tomcoolpxl/cool8-cpu/board/README.md

# board

Pin constraint files and hardware notes. See docs/05-board.md.
