tomcoolpxl/cool8-cpu/rtl/soc/README.md

# rtl/soc

FPGA-only system: SPRAM controller, video, audio, PS/2, UART,
hardware loader, SPI flash reader, bus arbiter.

Free to use iCE40 primitives. Never instantiated by the ASIC build.
