tomcoolpxl/cool8-cpu/RUST_PORT.md

# The machine

`rust/` **is** the COOL8 machine: the CPU, the SoC around it, the
scanline renderer and the window. Every software suite runs on it,
`sim/cosim.py` diffs it against the RTL, and `tools/cool8rsvm.py` is
how Python drives it. Read this file before touching anything under
`rust/`.

It began as a fast copy of a Python model, for one reason — speed:

| level | workload | CPython | Rust | |
|---|---|---|---|---|
| CPU | 852,740-instruction multiply sweep | 0.73 M instr/s | 115 M instr/s | 158× |
| machine | 90 frames of boot ROM | 0.50 M instr/s | 66 M instr/s | 132× |

Profiling showed the CPU stepping loop itself was the cost, and PyPy
was ruled out by its numpy story, so the loop was ported rather than
coaxed. It then spent a development cycle as a runner gated against
the Python model per retired instruction, which is what made the
hand-over a rename rather than a leap
([D57](docs/01-decisions.md)) — and the Python model is now gone.

## The one rule: the RTL is the authority, and the specification is prose

`docs/02-isa.md` and `docs/04-system.md` say what this machine is;
`rtl/` is what it will be in silicon. **When this machine and the RTL
disagree, one of them is wrong and the documents decide which** — the
seat the Python emulator used to hold, now held by the hardware it was
always checked against. Do not resolve a cosim failure by changing
whichever side is easier to change.

Two independent implementations of the semantics still exist, which is
the property that made any of this trustworthy: the Verilog and this.
They are diffed instruction by instruction on every run of the gate.

## The verification contract

`sim/cosim.py` holds this machine and the RTL to one contract, and it
is the contract that was always here:

- **One line of full architectural state per retired instruction**, in
  cosim's format, lowercase hex:
  `pc r0r1r2r3 x y sp f` → `"%04x %02x%02x%02x%02x %04x %04x %04x %02x"`.
  Change one side, change all three.
- **The same programs**, generated by `sim/progen.py`: `directed()` (one
  probe per encoding, all 511), constrained-random streams, the four
  interrupt/halt/brk programs, and the exhaustive 65536-pair multiply.
- **The same retirement rules.** BRK and the reserved page-2 trap retire
  (they are instructions); a hardware interrupt entry does not; a halted
  tick does not. `o_retire` is the RTL's signal for it and the
  machine's `instructions` counter is its mirror.
- **Interrupts injected by retired-instruction count, never by cycle**,
  because the two models cannot agree on a cycle and do not need to.
  The machine takes the RTL testbench's plusarg vocabulary
  (`+irqafter=`, `+nmiafter=`, `+irqat=`), so cosim invokes both sides
  with the same words.
- **The whole 64 KB memory image is compared** after every run, so a
  store to a wrong address cannot hide behind a matching register trace.

Run it:

```
poe cosim              # the gate for any RTL change
poe test-rust          # the machine against RTL-dumped goldens
poe check              # among other things, the generated-table drift check
```

`poe check` runs `mkrsopc --check` so a stale generated table fails
loudly instead of misexecuting quietly. Run it before trusting a
cosim result after an encoding change.

## What is generated and what is hand-written

The project rule is that `tools/opcodes.py` is the single source of
truth for the encoding and nothing carries its own copy of the tables.
Rust cannot import Python, so the tables are **generated, not copied**:

- `tools/mkrsopc.py` reads `opcodes.py` and writes `rust/src/optab.rs`:
  the per-encoding cycle costs (branches as a not-taken/taken pair),
  the page-2 assigned/reserved split, and `INTERRUPT_CYCLES`.
- The generated file is committed, and `python tools/mkrsopc.py --check`
  regenerates and compares without writing — the same drift gate
  `asic/tt/prepare.py --check` gives the TinyTapeout copy of the RTL.
  It runs in `poe check`.
- **The hand-written Rust states no table.** `rust/src/cpu.rs` adds
  cycles only from `optab.rs` — there are no inline cycle constants to
  drift — and decides reserved-page-2 trapping only from the generated
  `P2_ASSIGNED`. After any change to the encoding or to
  `opcodes.cycles()`: rerun `python tools/mkrsopc.py`, rebuild, rerun
  `poe cosim`.

What *cannot* be generated is the instruction semantics, because
`opcodes.py` does not contain them (deliberately — the machine decodes
from bit fields independently of the table, so a disagreement between
the two is a real signal). `rust/src/cpu.rs` states them by hand, and
the trace diff against the RTL is what polices it.

## The files

| file | what |
|---|---|
| `rust/src/cpu.rs` | the CPU: state, ALU, conditions, interrupts, the step dispatcher, and the `Bus` trait |
| `rust/src/machine.rs` | the SoC: memory map, ROM overlay, UART, PS/2, flash, sound, the video register file and VRAM, and the scanline accounting |
| `rust/src/optab.rs` | **generated** by `tools/mkrsopc.py` — do not edit |
| `rust/src/main.rs` | the harness: both CLIs, the run loops, trace, dumps |
| `rust/src/render.rs` | the scanline renderer, modeled on the RTL — see below |
| `rust/src/emu.rs` | the window, the speaker and the host keyboard (`--features gui` only) |
| `tools/mkrsopc.py` | the generator, and `--check` |
| `tools/cool8rsvm.py` | the Python client: the batch machine (CPU+RAM per call, one shared `+serve` process) and the session machine (a persistent machine with peripherals, one process each), plus module-level `Machine`/`boot`/`converse` so a suite migrates by importing this module as `vm` |
| `tools/cool8rsrun.py` | the launcher: builds the ROM, font, keymap and disk with the ordinary tools, then hands over to `cool8rs +emu` |

`rust/target/` is gitignored; `Cargo.lock` is committed. There are no
dependencies.

The runner has two modes, chosen by the arguments. **CPU mode**
(`+hex=`): 64 K image, one hex byte per line as `progen.write_hex`
emits, plus `+trace=`, `+memdump=`, `+maxinstr=`,
`+irqafter=`/`+irqat=`, `+nmiafter=` — the RTL testbench's plusarg
vocabulary. Hardware-only plusargs (`+ws=`, `+wsrnd=`, `+maxcycles=`,
`+busrq*`) are accepted and ignored so cosim call sites can be reused
verbatim; anything else unknown is an error, so a typo'd `+irqafter`
cannot silently become a run with no interrupt in it. **Machine mode**
(`+rom=`, a binary ROM image): `+flash=` (a raw flash image, as
`Machine(flash_path=…)` takes), `+script=`, `+trace=` (a path, or
`-` for stdout), `+memdump=`, `+vramdump=`, `+said=`. Every run prints
`-- N instructions, … T s` (stdout in CPU mode, stderr in machine mode,
where stdout may be carrying the trace); T is stepping time alone, so
process start-up and image parsing flatter neither side of the speed
report.

## The machine level

`machine.rs` is the SoC: the memory map with the I/O page and the ROM
overlay, the UART, the PS/2 port, the SPI flash with its floor, the
eight-voice sound engine, the complete video register file with its
VRAM port, palette latch, pixel port and sprite table, and the
scanline accounting that makes time pass.

Its gate is `sim/test_vm.py`, and it is the same shape as cosim's: the
stimulus is transcribed by hand from `sim/tb/cool8_video_tb.v` into
Python, replayed through this machine's registers and VRAM, and the
frame the renderer scans out is compared **per pixel** against the
frame the RTL's own pixels made — `build/text.hex`, `build/tiles.hex`
and the sprite phase, 307,200 pixels each. The sound engine's level
stream is compared the same way against `build/snd.hex`, 4096 samples
from the running RTL, and the boot path against the bytes a real board
returned on its serial console.

**Why transcribe the stimulus rather than share it.** The frames could
have been produced by asking this machine to render whatever the
testbench set up, which would make the check a test of the renderer
against itself. Written out twice — once in Verilog, once in Python —
a misunderstanding of what a register means has to be made twice,
identically, to go unnoticed.

## Traps already hit, or designed around

- **Cycle accounting is table-driven for a reason.** `enter()` (the
  interrupt/trap entry) adds no cycles itself; every cost comes from
  the generated table at the dispatch site. BRK's table entry (6) and
  the reserved-page-2 trap's (7) already *include* the entry cost —
  adding `INTERRUPT_CYCLES` around a call to `enter()` double-counts.
  Only a real hardware interrupt adds `INTERRUPT_CYCLES` explicitly.
- **The run-loop event order is cosim's**: retire, apply any event,
  write the state line, then the halt check — so an event aimed at a
  halted machine still fires. The stop condition is the emulator's:
  halted, and neither `nmi_edge` nor (`irq_line` and `I`).
- **`+irqat=0` means "asserted from reset"**, applied before the first
  step, exactly like `emu_trace`'s `events={0: ...}`.
- **Both sides of the machine diff must run on `tick()`, not
  `run_line()`.** The two are not interchangeable: `run_line` runs to a
  cycle target and drops the overshoot when an instruction crosses the
  line boundary, while `tick` carries it in the owed-cycles
  accumulator, so the raster — and with it every interrupt — falls on
  different instructions. The Rust machine implements `tick` and the
  parity driver calls `m.tick()`.
- **`m.said()` drains the UART.** The suite compares it once and hands
  the bytes to the sanity callback; a second read sees nothing, which
  looked exactly like a monitor that never spoke.
- **Page-2 `$2C/$2D` (`ADDW X|Y,#imm16`) sit inside the unary range**
  `$10–$3F` and must be matched before it, as the emulator's `elif`
  order does; `$2E/$2F` in that range are reserved and are caught by
  `P2_ASSIGNED` before any range match runs.
- **`INCW`/`DECW` set only Z**, not N; `MOV` and the wide pointer ops
  set nothing; loads and `POP` set Z/N; stores and `PUSH` set nothing.
  All of it is the emulator's behaviour, ported — resist "fixing" flag
  behaviour in Rust on the way through.

## The display: modeled on the RTL, because now it can be

`rust/src/render.rs` is a scanline renderer derived from the Verilog —
`cool8_fetch.v`, `cool8_pixel.v`, `cool8_sprite.v`, `cool8_vga.v` —
rather than a port of the whole-frame Python renderer it replaced. The
reason that renderer stated in its own header: at CPython speed a frame
costs 0.88 s, so it drew whole frames from a register snapshot and **a
mid-frame register change was not visible**. At Rust speed the
hardware's real structure costs nothing, so it is modeled:

- **The line buffer, filled a source row ahead of the raster**, with
  `row_ptr` walking by stride from a base captured at frame start —
  so `VID_BASE` is latched at vblank exactly as docs/04-system.md
  section 12 promises, page flips cannot tear, and a mid-frame base
  write behaves as the hardware's accumulator does.
- **Registers sampled per line**, so a raster split lands on the line
  the write preceded and a palette change colours only the lines below
  it.
- **Text cells latched for sixteen lines, tile rows every line**, the
  circular `stride * 32` wrap, patterns flipped at fetch time, the
  256-word bank clamp on long bitmap strides.
- **Sprites per line**: eight slots with trailing rows counting,
  descriptor-order priority, the shared palette bank, `behind` losing
  to a non-zero background. The slot scan itself lives in the
  *machine* (both of them — see the findings below), because the
  overrun flag is CPU-visible.

The sprite *bandwidth* is modeled too, at the granularity the RTL's
own header states it: the scan-and-sweep lead-in, ~33 clocks for a
16x16 sprite, trailing rows cheaper, against the 266-clock line. A
line that runs out of clocks loses its last-rendered — which are the
lowest-numbered — sprites, and the overrun flag says so. The costs
are the RTL's stated figures, not a cycle-exact FSM re-derivation;
`sprite_plan` in machine.rs is the one statement of the rule, for
both the flag and the renderer. The *fetch* engine's
bandwidth stays unmodeled: nothing observable hangs off it.

**The gate**: `sim/test_vm.py`, per pixel, against the RTL's own
rendered frames — text, tiles and eleven sprites over a bitmap, all
307,200 pixels of each. Static frames, necessarily: the per-line
behaviour a whole-frame comparison cannot reach rests on the RTL
derivation above, and on `sim/test_video.py`, which checks the gates
themselves on every pixel clock of two frames.

## The window: `poe emu`

`tools/cool8rsrun.py` builds the ROM, the font, the machine-layout
keymap and a BASIC disk with the ordinary tools, then launches
`cool8rs +emu` (`--monitor` boots just the ROM). The front end is
`rust/src/emu.rs`, behind `--features gui` so the parity suite's build
stays dependency-free; SDL2 — bundled, so the build owns its copy — is
the window, the speaker, the clipboard and the scaler, the same library
the Python front end rides through pygame. (It was minifb and cpal
first; one library that does all four jobs replaced two that did one
each.)

- The CPU gets **exactly 266 system clocks per scanline**, 525 lines a
  frame, 139,650 cycles a frame at 60 Hz — 8.375 MHz of machine time,
  the same constant the Python machine and D32 state. Real time costs
  about 4 % of a core; the renderer adds 18.4 M pixels/s and does not
  change that picture.
- Audio is the machine's own 32.7 kHz `level` stream, resampled to the
  device rate; the queue takes the drift.
- The keyboard has three modes (`+keys=text|raw|both`).
  `text`, the default, takes printable characters from the OS — the
  user's layout applies — and types them through the machine's own
  keymap, derived from sw/keymap.asm by the launcher, never a second
  copy; the character-less keys go as physical Set 2 make/break, with
  the PS/2 typematic repeat a held key really produces. `raw` is all
  physical US-layout scancodes; `both` echoes characters to the UART
  for a machine with no keyboard driver yet.
- **F1 restarts the machine warm and F10 cold** — they send the raw
  scancodes of the machine's own Ctrl+Esc and Ctrl+Shift+Esc
  ([D54](docs/01-decisions.md)), which the keyboard block decodes
  before software sees them. The chords themselves cannot be used
  here: Windows keeps Ctrl+Esc for the Start menu and Ctrl+Shift+Esc
  for the task manager and never delivers either to an application.
  On the board, where nothing stands between the keyboard and the
  machine, the real chords work. Injecting the scancodes rather than
  performing the restart keeps the emulator on the same path the
  hardware takes — the machine cannot tell which keyboard it is.
- **F11** (and Ctrl+Pause, the board's own chord) is the break button
  — an NMI, as SW[0] is. **F12** writes the screen to a PNG.
  **Alt+Enter** toggles aspect-ratio-scaled fullscreen. **Right
  click** pastes the clipboard as keystrokes, a character a frame so
  the 16-byte FIFO never overruns.
- `+wav=` captures the speaker to a WAV at the machine's own sample
  rate, and a flash the machine wrote is written back to its image at
  exit, so SAVE survives the window closing.

## Python-model errors found against the RTL, and what was done

Reading the Verilog for the renderer turned up three places where
the Python model disagreed with the hardware. Per the rule of the day
the reference was fixed first and the Rust machine followed it; parity
gated both, and the software suites that exercise machine timing
(`basic`, `boot_basic`, `autoboot`, `interp`, and `test_run`'s VSYNC
and sprite-pacing checks) pass on the corrected phase. (At the time of
the fix, `names` and parts of `test_run` were failing for an unrelated
reason — the in-progress editor rewrite and CONST removal — so "the
whole suite is green" was not available as a gate; what was green
before the fix stayed green after it.)

1. **The vblank flag fired 45 lines late.** cool8_vga raises
   `frame_start` at line 480 — the start of vertical blanking, which
   is also what docs/04-system.md section 6 specifies — and the model
   raised it at the counter wrap, line 525/0. **Fixed** in the
   end-of-line step (and the cursor-blink tick with it, which the RTL
   also advances at frame start).
2. **The sprite overrun flag was never set.** cool8_sprite sets it on
   the ninth hit of a line — trailing rows counting — and on a render
   outrun by the next line. **Fixed, both halves**: the scan and the
   clock-budget model run in both machines' end-of-line step whenever
   sprites are enabled, so $FE2C bit 1 reads correctly and the
   renderer drops what the hardware would drop.
3. **Whole-frame rendering itself** — the snapshot model cannot show a
   raster split, a mid-frame palette change, or the vblank `VID_BASE`
   latch. Not fixable at CPython speed; that is what render.rs is for,
   and it is why the whole-frame Python renderer could not survive as
   the render model.

## What this is not: the scope line

- **Scanline granularity, PS/2 at FIFO level** — the machine's stated
  fidelity line. Finer than that, ask the RTL.
- **The loader wire protocol (`cool8_loader`) is not modeled**,
  deliberately: no software in the emulator ever speaks it — loading is
  the flash image or a poked memory image — and `sim/test_loader.py`
  drives the real thing over a bit-banged wire. It becomes worth doing
  the day a host-loader test wants to run without iverilog.
- **The sound *sample stream* is now diffed** (`sim/test_vm.py`, 4096
  levels against the running RTL); what is still not is the sigma-delta
  bitstream below it, where nothing CPU-visible reads back.

## How tests consume it: the batch machine

`tools/cool8rsvm.py` is the consumer path. `cool8rsvm.machine()` hands
back the batch machine, for CPU-and-RAM workloads: `bus.mem`, the
whole register file (which round-trips, so poke → run → inspect → run
again works), `romen`, `breakpoints`, and `run(until=…, cycles=…,
budget=…)` with the classic reasons. Peripheral state does not survive
between runs — the class docstring states the contract — and a
predicate `until` does not cross a process boundary. Without cargo
there is no machine and it says so: the suites need one.

The plumbing: one `cool8rs +serve` process per test process, batch runs
sent over stdin (tab-separated, because the fields carry paths), each
run a fresh machine on the far side whose loop is `Machine.run`'s own —
halt test before the tick, budget in ticks — so stopping behaviour
moves unchanged. One spawn per suite, not per case; per-case cost is a
64 KB file each way. `run()` works once per RustMachine and raises on a
second call — registers do not round-trip, so a resume would be a
different machine.

**The boundary rule, unchanged since the original investigation: it
sits at machine-API granularity or coarser.** There is no PyO3 wrapper
and no per-bus-access FFI. Anything that must look at the machine
*while it runs* becomes a server-side command rather than a Python
loop — `settle`, the cycle profiler (`profon`/`profdump`, which is
what `dbg.Profile` now reads) and the SP low-water mark (`spmin`),
each of which would otherwise cost a round trip per instruction. A new
question extends the protocol; it does not get a loop here.

## And the session machine, for the suites that type

The batch machine cannot host `test_basic` — that suite types, waits
for idle, reads the screen, types again — so the serve protocol grew a
**session form**: one persistent machine per `+serve` process,
peripherals, flash and all, with commands that mirror the Machine API
(`type`, `scan`, `nmi`, `said`, `text`, `frames`, `srun`, memory and
VRAM reads and writes, `flush` for the flash image, `fb` for a
rendered frame, and the peripheral dumps `pald`/`sprd`/`sndd`/`snds`
that let a harness compare two programs' setup without modelling any
of it). The command that shows the boundary rule at work is
**`settle`**: test_basic's idle test — both FIFOs empty, the input
ring drained, PC at the idle label — polls per instruction, so it runs
server-side as one command instead of one tick per round trip.

Two invariants the first migration day taught:

- **`romen` is machine state, not client belief.** The flash stub
  drops the overlay before jumping to BASIC; a client that pushes its
  own stale `romen` back before every run re-enables the overlay
  mid-boot. It round-trips with the registers on every stepping reply.
- **A zero-length transfer is `-`**, not an empty hex string, on both
  sides of the wire.

`cool8rsvm.Machine(...)`, `.boot(...)` and `.converse(...)` are the
module-level entry points, so a suite reads exactly as it did — the
migration was a changed import. `Machine(render=True)` attaches the
scanline renderer, which is what `m.fb()` answers from and what
`test_run`'s sprite check and `test_vm`'s frame gate use.

## Measured

The speeds that justified the port, 2026-08 on this machine, against
the CPython model it replaced:

| | workload | CPython 3.12 | `cool8rs` (release, LTO) |
|---|---|---|---|
| CPU | multiply sweep, 852,740 instr | 1.17 s — 0.73 M instr/s | 0.0074 s — 115 M instr/s |
| machine | 90 boot frames, 3,605,915 instr | 7.18 s — 0.50 M instr/s | 0.055 s — 66 M instr/s |

And what that bought the suites, on the day they moved: the software
group **823.8 s → 185.7 s** wall (`test_run` 823.7 → 183.7,
`test_basic` 177.9 → 2.9, the flash and boot suites to under 1.5 s
each), and `cosim all` to 55 s with the model side reduced from most
of the run to seconds — vvp is the cost now, which is the right cost.

The parity suite that made the hand-over safe (directed 511 encodings,
random streams, the interrupt programs, the multiply sweep, the
monitor conversation and an 8.5 M-instruction flash-to-BASIC boot, all
byte-identical) retired with the model it compared against. Its
successors are `poe cosim` and `poe test-rust`.
