tomcoolpxl/cool8-cpu/docs/12-tasks.md

# 12. Commands, and the runner that names them

Every command this project has is named in `pyproject.toml`: the job
table under `[tool.cool8.jobs]` for the suites, `[tool.poe.tasks]` for
the direct commands. That file is the vocabulary: if a command is not
in it, it is not a command, it is something someone typed once.

**The runner is pytest**, fed the job table by the one shim in
`sim/runner/test_jobs.py` — the shim shells each suite exactly as a
person would and holds no policy of its own. pytest-xdist runs jobs in
parallel (`-n auto`, the default), a group is a marker (`-m rtl`), and
`--durations` says where the time went. **poethepoet** (`poe`) names
the rest; `pip install -e ".[dev]"` once installs all three. Use
`python -m pytest` / `python -m poethepoet` where Scripts is not on
PATH.

```
poe test                 every software suite, in parallel  (pytest)
pytest -k "interp or asm"    just those two
poe test-rtl             the RTL side (cosim is the gate for any RTL change)
poe test-board           the physical board, one job at a time
poe test-all             software and RTL together
poe check                the generated tables, against what generated them
poe build                boot ROM, basic.bin, BOOT.BIN, with sizes
poe bench                the language benchmark
poe prof                 where the interpreter's clocks go
poe web                  build wasm and serve the web emulator locally
poe web-build            build wasm and web assets for GitHub Pages
poe list                 everything the runner knows about
```

**Three phases, and they are not the same kind of thing.** `sw` runs on
the machine — `rust/`, driven through `tools/cool8rsvm.py`, so it needs
`cargo` and there is no fallback — and is the fast inner loop. `rtl`
runs iverilog against the hardware description: slower, and where a
change to `sw/boot.asm` actually gets checked, since the boot ROM is
compiled into the bitstream. `board` talks to real hardware over USB.

**Board jobs must not run in parallel.** There is one USB device and no
lock on it; two `icesprog` processes at once do not fail cleanly, they
interleave on the SPI and hand back a readback full of zeroes — which
reads as a corrupt bitstream rather than as a corrupt test. That
happened here. `poe test-board` therefore carries `-n 0`; never run the
board group with xdist enabled.

What the runner buys is the part that was being done by hand in a shell
loop for a year:

- **The suites run at once.** A dozen of them, serially, is minutes of
  waiting while eleven cores idle.
- **Each job gets its own build directory**, `sim/build/jobs/<group>-<id>`,
  passed as `COOL8_BUILD`. Every `sim/*.py` honours it. This is not a
  nicety: the suites all compile `basic.bin`, and without it parallel
  runs write it on top of each other and fail in ways that look like
  bugs in the machine.

  **The trap that comes with it:** a suite that reads an artifact
  *another* suite produced will not find it, because that one wrote to
  its own directory. `sim/test_vm.py` hit this and passed in 0.19 s
  having compared nothing. If a suite consumes another's output, it
  must search the sibling directories — and **treat a missing input as
  a failure, never a skip**. A check that cannot run has not passed.
- **Only failures print their output.** A pass is a dot and a duration.
- **The exit code is the answer**, so it can gate a commit.

A suite counts as passed when it exits 0 *and* the word `FAIL` does not
appear in its output — two of them report a count rather than a status,
and an exit code alone would take their word for it. The shim enforces
this, not the suites.

## Writing a suite

Every suite is an ordinary script: it builds something, drives the
machine, prints a line per check, and returns an exit code. What it
does **not** do is carry its own copy of any of that.

```python
import harness as H
import cool8rsvm as vm

def main():
    code, syms = H.build_bas("basic.bas")
    m = vm.Machine()
    ...
    H.check(m.shows("42"), "RUN prints its answer")
    return H.report()
```

`sim/harness.py` owns building, checking and the paths;
`sim/toolchain.py` owns iverilog, yosys and the RTL file lists
(`T.build`, `T.run`, `T.cells`, `T.CORE`). Both are described in
[AGENTS.md](../AGENTS.md) and [10-debugging.md](10-debugging.md), and
using them is standing rule 4 — not a style note. A suite that rolls
its own is a second implementation of the thing it is testing with.

**A suite that reads another suite's artifact must search for it and
fail loudly when it is missing** — see the per-job build directories
above.

## The jobs

### `sw` — the software suite (`poe test`)

| | |
|---|---|
| `interp` | the interpreter on the editor's stored form |
| `lib` | M14 -- `sw/demo.bas` against `sw/demo.asm`, work per frame |
| `asm` | the on-machine assembler, byte-identical to `tools/cool8asm.py` |
| `basic` | the screen editor, typed at |
| `run` | `RUN`, plus `INKEY` and `KEY` driven from the PS/2 port |
| `boot_basic` | reset → autoboot → relocate → BASIC → a keypress, off a flash image |
| `autoboot` | autoboot and the monitor's flash write |
| `corpus` | the compiler against its corpus |
| `fs` | the filesystem, both implementations |
| `bas` | the code-size gate: within 15 % of hand-written |
| `memmap` | in the `check` group — [`tools/memmap.py`](../tools/memmap.py) is the one machine-readable memory map, the same arrangement `opcodes.py` has for the encoding. It verifies itself against the equates every `sw/*.asm` actually declares, and refuses two names on one byte of page 0. **Import from it rather than writing an address down twice**: `sim/test_interp.py` used to carry its own `VARS = 0x0040`, `sim/build_basic.py` its own `ORG`/`TOP` — and `sim/tb/cool8_boot_tb.v` its own `$8104` for the boot banner, which went stale at [D70]'s map move (2026-08-13) and stayed stale through [D82]: the `boot` job failed for four days and nobody saw, because map moves are software work and the `rtl` group was not in the loop. A testbench cannot import, so the rule there takes its other form, the one `+stopat` already used: the address goes in as a plusarg (`+banner=`, `+moncy=`), read out of the assembled `boot.asm` by `sim/test_boot.py`, and a missing plusarg is a hard failure rather than a default |
| `fp` | the loadable float package of [D62](01-decisions.md#d62--floating-point-ships-as-a-loadable-library-not-as-part-of-the-system) — arithmetic, decimal text, trig. **It also prints its own size and timing table**, which is what the decision entries quote rather than a hand-typed copy. `--trace <op> <x> <y> <label> <n>` breakpoints a routine and decodes forward; that is how `fdiv16` was caught answering the wrong question |
| `names` | global name collisions across the system image |
| `action` | the CoolAction! compiler of [15-action.md](15-action.md): one program per construct read back by symbol, the Byte sieve's clocks beside compiled BASIC's, `demos/primes.act` at the UART, what the compiler refuses -- and its assembler against `tools/cool8asm.py`: every program byte for byte, and all 491 encodings through both. **The library on the hardware**: every routine of `sw/libaction.act` called and the machine read back -- VRAM, palette, sprites, sound, the registers -- and `Line` against `LINE` over `test_run.py`'s fan, the whole mode 4 frame compared. **The nine ports against their originals**: each `demos/name.act` runs beside its `name.bas` to the same frame wait, `RND` call or key wait, and what the machine holds -- VRAM, palette, text map, voices, registers -- must be identical; the clocks are printed beside each other where the CPU is what is measured. **`KeyPoll`/`KeyHeld`** from a fed FIFO, on the bare machine and `SYS`'d from a booted BASIC with its interrupt handler running (D101), **KEYTEST** from the flash-booted disc, **the loader** (D102) putting RAINBOW.PRG at $1400 from the disc's catalogue and resetting the machine after it, and **Ms. Cool-Man** played by an autopilot -- and started from BASIC with a real space bar -- -- the title frame, dots, the pill, a ghost eaten and home, a death, two levels cleared into the blue maze, the fruit, the sprite engine's overrun flag -- which skips, loudly, without its art part. `--profile` prints the sieve's clocks by loop, `--profile line` the library's `Line` over the fan |

**Ten suites are on disk and not in the runner.** This paragraph said
five, and then named six; it also said "this is all of them", and it
was not. Two Tetris suites arrived with the demos and were never added
here, and the two ports below arrived after that. **The count is
derived, so check it rather than trusting it:**

```bash
for f in sim/test_*.py; do grep -q "$(basename $f)" pyproject.toml || echo $f; done
```

That is the failure mode a "deliberately excluded" list has, and it has
now happened twice: an excluded suite and a forgotten one look
identical from outside, so nothing complains when the list falls
behind.

The shelved on-machine compiler's gates — `sim/test_comp.py`,
`sim/test_emit.py`, `sim/test_lex.py` — cost minutes to gate code that
ships nowhere ([11-compiler.md](11-compiler.md)). Run them deliberately
before touching `sw/comp.bas`, `sw/emit.bas` or `sw/lex.bas`, and before
any change to the token table or the stored-program format, which both
sides of those diffs share.

The rest:

| | |
|---|---|
| `sim/test_asm.py` | `sw/asm.asm`, the assembler **on the machine**, gated on byte-identity with `tools/cool8asm.py` for the same source. Run it when either assembler changes |
| `sim/timing.py` (`poe timing`) | measures every encoding's clocks from `rtl/core`. **Not a suite and not gated**, and it is the only thing that keeps `rtl/core`, `tools/opcodes.py:cycles()` and the emulator's accounting in step — cosim cannot, because the two models are not expected to agree on a cycle. Run it whenever the control FSM changes, then update the other two ([02-isa.md §8](02-isa.md)) |
| `sim/test_load.py` | the host loader against the real RTL and against itself — the wire format of [07-loader.md](07-loader.md). Needs the toolchain, which is why it is not in the `sw` group |
| `sim/test_cooltris.py`, `sim/test_cooltris2.py` | the two Tetris demos, driven through the text buffer and through the tile map. They gate a demo rather than the system. Run them when `demos/cooltris*.bas` changes |
| `sim/test_pascal.py` | UCSD p-System II.0 ([14-demos.md](14-demos.md), [D95 and D96](01-decisions.md)). **It needs a system volume this repository does not contain** — `tools/ucsd-psystem-vm` is cloned rather than vendored, and `.gitignore` says why. Clone it there and the suite boots the p-System, walks into the Filer and back, and compiles `HELLO` with the real `SYSTEM.COMPILER` |
| `sim/test_z3.py` | the Z-Machine and the four Infocom games. **It needs story files that are not ours to redistribute.** Put them where `tools/gen_z3.py` looks and it boots all four, then saves and restores |

**Neither port can be gated, and that is what not vendoring them
costs.** `sim/test_pascal.py` skips its volume when the clone is
absent, which is the one thing the per-job build directory paragraph
above forbids — a check that cannot run has not passed. It cost
exactly that: the Pascal interpreter stopped assembling at some point,
and nothing said so until someone ran the suite by hand.

### `rtl` — `poe test-rtl`

`cosim` is **the gate for any RTL change**. It takes about a minute. Run
it; do not reason about whether it would pass.

`monitor` is the one that matters after a change to `sw/boot.asm`,
`sw/kbd.asm` or `sw/keymap.asm`: it boots the whole SoC cold on the
parameters the bitstream carries and types at it on **both** the serial
line and the PS/2 clock, so a scancode takes the same path it takes on
the bench. That is where a keyboard change is really checked — the
machine models the PS/2 port at FIFO level, but only this runs the
receiver, the parity check and the FIFO itself.

| | |
|---|---|
| `cosim` `boot` `soc` | the CPU and the machine against the RTL |
| `ps2` `flash` `spram` `loader` | one peripheral each |
| `monitor` | type at the whole SoC, serial and PS/2 |
| `video` `vram` `vport` | every mode and visible pixel |
| `snd` | the sound engine — **and it writes `build/snd.hex`**, the golden `test_vm` gates against |

Not in the runner, because they are slower than the gate and are run
deliberately:

```bash
python sim/cosim.py mul        # exhaustive multiply (~2.5 min)
python sim/test_load.py        # the host loader, against the RTL
python sim/test_video.py --refresh    # also updates docs/img/
poe mutate                 # break the RTL on purpose; require a fail
poe synth                  # hygiene, LUT/FF count, gate estimate
poe timing                 # measured clocks per encoding
```

### Two that answer a question rather than gate a change

Neither is a test and neither belongs in the runner. Both exist because
a decision was resting on a guess.

```bash
python sim/cpi.py              # cycles per instruction, and what it
                               # costs to add one. ~1 min
python tools/mkbit.py --seeds 6   # Fmax per clock across placer seeds
                               # ~70 s for the first, ~40 s each after
```

**`sim/cpi.py`** measures CPI on three code shapes — native, bytecode
and the real interpreter — and turns it into the break-even clock for
any change that adds a cycle to the fetch. It priced
[D59](01-decisions.md#d59--cpi-is-259-and-pipelining-the-fetch-is-a-bet-rather-than-an-optimisation)
in minutes, against a question that had been open for four milestones.
Re-run it whenever the cycle table moves: **at CPI 2.59 one added cycle
per instruction is a 39 % penalty**, which is what makes
per-instruction overheads so expensive on this machine.

**`--seeds N`** is the honest way to read Fmax. One nextpnr run is not a
measurement — the placer spread is around 6 %, and
[D38](01-decisions.md#d38--the-fetch-path-next-state-is-decoded-flat-and-it-bought-area-rather-than-speed)
is the write-up of a single-seed result that was noise and was believed
for a round. Synthesis is deterministic, so yosys runs once and only
placement repeats. It reports `sclk` and `pclk` separately, which the
plain build did not: it used to print whichever clock nextpnr mentioned
last.

### `board` — `poe test-board`

| | |
|---|---|
| `probe` | the board answers at all: the SPI flash identifies itself |
| `flash` | both halves read back off the chip and compared byte for byte |

Neither writes anything. Both are exclusive.

### `rust` — `poe test-rust`

| | |
|---|---|
| `vm` | the machine against RTL-dumped goldens: every pixel of three frames (text, tiles, sprites over a bitmap), 4096 sound samples, and a boot to the monitor answering `D F000` with the bytes a real board gave |

Its own group rather than `sw` because it needs the RTL dumps in
`sim/build` — `sim/test_video.py` and `sim/test_snd.py` produce them,
and it SKIPs rather than fails when they are absent. Everything about
the machine — what it is, what is generated, what the gates prove — is
in [RUST_PORT.md](../RUST_PORT.md).

**What the board phase cannot check** is that the machine boots to a
picture. `LOADER` defaults to 0 ([D40](01-decisions.md)) so there is no
way to read the framebuffer over the wire, and BASIC writes to the video
rather than to the UART — a serial terminal shows nothing even when it
is working perfectly. That needs eyes on the VGA output and a PS/2
keyboard in the socket, and it is the one part of this that is not
automatable.

### The emulator window

```
poe disk                                     a flash image with BASIC on drive 0
poe emu                                      boot it in a window
poe demo                                     rebuild the demo disc and boot it
python tools/cool8rsrun.py --flash IMG       boot some other image
python tools/cool8rsrun.py --rebuild ...     rebuild that image first
python tools/cool8rsrun.py --monitor         ROM only: no flash, no BASIC
```

`poe emu -- --flash IMG` does **not** work: poe passes the `--` through
and argparse rejects it. Call the script, or use `poe demo`.

**Putting BASIC into a running machine: `H.line`, not `H.key`.**
`m.key()` is the keyboard and stays the thing to *test* with; `H.line`
is what a builder wants. It sends one `inject` command -- the text, and
the addresses of `LBUF`, `LLEN` and `ed_inject`, all out of the symbol
table -- and the machine tokenises the line itself through
`sw/token.asm`, exactly as if it had been typed. One round trip a line
against one a character: **19.6x measured**, and the stored program is
byte-for-byte identical, floats included.

**Nothing is written into RAM to make the call.** The first version
poked `CALL / HALT` into four bytes of low RAM and jumped there, which
needed an address that was free -- and `sw/lowram.asm` says in its own
header that its map "has been wrong". The return address is pushed
instead, so the machine returns to the PC it was already sitting on and
there is no byte to contest.

**`--rebuild` is the one-command answer to a stale disc.** The launcher
otherwise builds nothing, deliberately — `basic_image` in
[cool8rsrun.py](../tools/cool8rsrun.py) says why: a launcher that
decides *for itself* when an image has gone stale needs a rule about
when a source counts as newer, and that rule is what quietly boots
yesterday's image one day. **Asking is not deciding**, so the flag is
allowed where a timestamp heuristic is not.

It picks the builder from the target: `demos.img` goes to
`mkdemos.py --no-shots`, anything else to `flash.py`. **`--no-shots`
matters**: `mkdemos` normally runs every demo for twelve chunks of 500M
cycles to photograph it, which is minutes; skipping that leaves typing
the sources onto the disc, which is not. The pictures are for
[14-demos.md](14-demos.md), not for booting.

**The launcher refuses to hand over idle symbols it knows are wrong.**
It compares the `BOOT.BIN` it would build against the one on the image,
and when they differ it says so and names the fix rather than passing
`+idle=` addresses from a build the machine is not running — which
makes `Machine::is_idle` never true, so the taskbar's play button waits
forever for a machine that booted seconds ago. That reads as "the demos
do not work" and is nothing of the kind; it has cost two sessions.

**There is a taskbar**, and every key below is also a button on it with
the shortcut and a line of description under the pointer. It carries a
menu of **every program on every disc**, and the play button beside it
cold-restarts the machine and then types `DRIVE n`, `LOAD "…"`, `RUN` —
the machine is typed at, exactly as a person would, and knows nothing
about the menu. **Fullscreen has no bar**, which is what fullscreen is
for.

**A program means a `.BAS`, and the menu holds nothing else.** That is
the machine's own rule and not the launcher's taste: `sw/fscmd.asm`
fills in `.BAS` when a name is typed without an extension, so a name in
the menu is exactly what the `LOAD` it is about to type will find. The
menu listed every *file* until Bad Apple made the difference plain —
its stream is 82 chunks called `BA000.DAT` upward, spread across twelve
drives, none of which can be loaded and run, and they buried the twelve
things that can in a list ninety-five long. `tools/cool8disk.py`'s
`catalogue` filters, `sim/test_fs.py` holds it, and `BOOT.BIN` falls out
of the same test instead of being named.

The bar is [Dear ImGui](https://github.com/ocornut/imgui) through
`imgui-sdl2-support` and `imgui-glow-renderer`, and the icons are
Phosphor merged into its font atlas ([`assets/icons/`](../assets/icons)).
Nothing in [`rust/src/bar.rs`](../rust/src/bar.rs) draws a widget or
packs a glyph; it decides what the bar holds and what each control does
to the machine. **The window never reads the flash image**: the disc
catalogue arrives as a file the launcher wrote with `tools/cool8disk.py`
(`+discs=`), the same arrangement the keymap has, because a directory
walk written again in Rust would be a second implementation of a format
that already has an owner.

| key | |
|---|---|
| `F1` | warm restart — the machine's Ctrl+Esc |
| `F10` | cold restart — Ctrl+Shift+Esc |
| `F11`, `Ctrl+Pause` | break: an NMI, as the board's button is |
| `F12` | the screen to a PNG in the current directory |
| `Alt+Enter` | fullscreen |
| right click | paste the clipboard, typed through the keymap |

**`F1` and `F10` exist because Windows keeps the real chords.** The
machine's own restarts are Ctrl+Esc and Ctrl+Shift+Esc ([D54](01-decisions.md)),
decoded in `cool8_ps2` before software sees anything — right on a board
where no operating system stands between the keyboard and the machine,
and impossible on a host that claims both for the Start menu and the
task manager. So the emulator injects the chord's raw scancodes: the
machine receives the bytes a real keyboard would send and cannot tell
the difference, and the hardware keeps a convention chosen for hardware.

### The demo disc

```
poe demos           build sim/build/demos.img and shoot the first demo
```

Formats sixteen volumes, boots the machine, **types** every
`demos/*.bas` at drive 13 and lets `SAVE` write it, then loads the first
one and renders a frame to `docs/img/`. No toolchain and no board: it is
the VM, which is what [14-demos.md](14-demos.md) means by a demo being a
question about software. It writes the `BOOT.BIN` it just built rather
than the one in `sim/build` — see the trap in
[AGENTS.md](../AGENTS.md), which cost a session.

### The board

```
poe bit             build the bitstream: yosys, nextpnr, icepack
poe disk            a flash image with BASIC on volume 0. No board touched
poe flash           bitstream + BASIC: the whole board
poe flash-fpga      the bitstream only, to flash offset 0
poe flash-system    BASIC only, to flash offset $100000
poe flash-verify    read BOTH halves back off the board and compare
poe console -- --port COM6      the board's text screen, on the PC
poe load -- --port COM6 --load build/BOOT.BIN --at 0x200 --go 0x200
```

> **`console` and `load` need a `LOADER(1)` bitstream, which is not the
> one you have.** Both talk to the hardware loader, and `LOADER`
> defaults to 0 ([D40](01-decisions.md)) — so on a shipping board they
> reach nothing. `poe board-screen` is the screen reader that works
> there: it asks BASIC to POKE the framebuffer at the UART, which needs
> no loader. Build with `LOADER(1)` when a board will not boot and you
> need the bus-master read-back.

**The boot ROM is inside the bitstream.** There is no separate step for
it: a change to `sw/boot.asm`, `sw/kbd.asm` or `sw/keymap.asm` reaches
the board through `poe bit` and `poe flash-fpga`, and through
nothing else. `poe rom` builds `boot.hex` for the *simulators*.

Flash holds two unrelated things and every way of confusing them is
destructive, so `tools/flash.py` makes the mistakes impossible rather
than documenting them a fifth time:

| offset | what | if you get it wrong |
|---|---|---|
| `0` | the FPGA bitstream | the board does nothing until reprogrammed |
| `$100000` | volume 0, where `BOOT.BIN` lives | boots to the monitor, looking like a BASIC bug |

It refuses to write a disk image at offset 0, refuses a bitstream
anywhere else, refuses an image whose volume 0 has no `BOOT.BIN`, and
**refuses `-e` outright** — that is a whole-chip erase, not a sector
erase, and it takes the bitstream with it.

**The image is not what goes to the board.** `build/cool8.img` is the
whole 8 MB flash *with volume 0 at `$100000` inside it*, because that is
what `vm.Machine(flash_path=…)` wants. Handing it to
`icesprog -o 0x100000` writes 8 MB starting at 1 MB — a megabyte off the
end of the chip, and minutes of SPI to do it. Only volume 0's used
extent is written: 28 KB for BASIC, about two seconds. That mistake was
made here and it presented as a hang, which is why:

**Programming streams its output and prints elapsed seconds when it goes
quiet.** A tool that says nothing for a minute cannot be told from one
that has died. Measured on the board: the bitstream writes in 6 s and
reads back in 4, volume 0 writes in 2 s — with a heartbeat every 2 s
throughout.

**Every write reads itself back and compares**, both halves, and that is
the check rather than the exit code — `icesprog` reports `done` for a
zero-byte write exactly as happily as for a real one, which is how a
wrong length went unnoticed here once. A bitstream that is 99 % right is
a board that does nothing and gives no clue why.

| | offset | bytes | write | verify |
|---|---|---|---|---|
| bitstream | `0` | 104,090 | 6 s | 4 s |
| volume 0 | `$100000` | 28,672 | 2 s | 1 s |

`--drive` programs the bitstream by copying onto the iCELink drive
instead, which is the documented drag-and-drop route and needs no
`icesprog`. It is fire-and-forget: the debugger takes the file and tells
you nothing about what reached the chip, so it cannot be verified.
Prefer `icesprog`.

Programming the bitstream works either way: `icesprog`, or a copy onto
the iCELink drive, which is the programming operation on that board.
Reaching a flash *offset* needs `icesprog` — the drive takes a bitstream
and nothing else. `icesprog` **ships in the OSS CAD Suite's `bin`**
([05-board.md](05-board.md)), so it is found by `OSS_CAD_SUITE` or by
the suite being on `PATH`, exactly like `yosys`. A bare `which` in a
shell that has not set that up says "no" and means nothing.

### `check` and `build`

`check` runs `opcodes --check`, `mkasmtab --check`, `mkrsopc --check`,
`mkactdata --check`, `cool8kbd --check` and the emulator's self-test —
the ones that verify a generated table still matches what generated
it. The last two are the CoolAction! ports' tables against their BASIC
originals' `DATA`, and the library's keyboard tables against
`sw/keymap.asm`. `mk3d --check` holds `demos/cobra.bas` and the
compiled COBRAs' model blocks to the generator, which checks each
tumble's camera against the machine's integer arithmetic over every
pose, and COBRA 2's sky against exact division, on the way
([D105](01-decisions.md), [D106](01-decisions.md)). `mkarkanoid --check`
holds Arkanoid's art file and its two data files, ARKANOID.DAT and
ARKSCENE.DAT, to the ripped arcade sheets, the 32 rounds and the music's
register logs, proving on the way that every background's model rebuilds
its panel and that the shadow is the sheet's own
([D107](01-decisions.md)). `mkpics --check` holds the picture drive's `.pic` and
`.rpl` files to the originals they were made from, and passes with a
message when none has been fetched -- the originals are downloaded, not
committed ([D103](01-decisions.md)). It plans every row's palette again
to do it, about 40 s for the four, so it is marked `slow`
([D104](01-decisions.md)). `ioregs --check` is
in the same group and reads every dialect in `sw/` — `.asm`, `.bas`
and `.act` — because the one it did not read shipped a library with
seventeen wrong addresses ([D98](01-decisions.md#d98--the-register-check-reads-every-dialect-and-the-library-names-no-address)).

`build` produces the boot ROM and the system image and **prints the
sizes**, because the image grows down from `$FEFF` into a finite gap
above system storage and nothing else warns you as it fills. `check`
fails the build when that gap is gone and warns from 256 bytes out.

## Adding a command

Add it to the relevant job list in `pyproject.toml`'s `[tool.cool8.jobs]`: an `id`,
the `run` path, optional `args`, and an `about` line that says what it
proves. `slow: true` moves it to the front of the queue, since with a
fixed pool the long pole sets the wall clock.

Nothing else needs changing. `poe list` picks it up.

## Shells

**Run the RTL suites from PowerShell, not from the Bash tool.** Under
Bash, `yosys.exe` exits 0 having printed nothing and every downstream
script then fails on empty output, which reads like a broken script
rather than a broken shell.

There are two `oss-cad-suite` installs on this machine; use the `eda\`
one.

## What is generated

`sim/build/` and everything under it, including the per-job
subdirectories. `build/` is the bitstream's. Both are gitignored, as is
`node_modules/` — there are no dependencies, so nothing is installed and
`poe test` works on a fresh clone with Node present.
