tomcoolpxl/cool8-cpu/docs/04a-registers.md

# 04a. The I/O registers

**Generated by `tools/ioregs.py` from the Verilog that decodes them — do not edit.** `poe build` regenerates it and `poe check` fails if it is stale, if a peripheral has gained a register without a name, or if anything in `sw/` names an address no hardware answers at.

`$FF00-$FFF7` is decoded on the bus ahead of memory, so these addresses are never RAM. Each peripheral's Verilog gives its offsets as localparams whose value *is* the page offset — `A_IDX = 8'h50` is `$FF50` — so the addresses here are read from the hardware rather than restated.

The page stops at `$FFF7`, eight bytes short of the top: `$FFF8-$FFFF` stay RAM because the CPU fetches its reset and interrupt vectors from there, and leaving them alone is what let the page move without touching `rtl/core/` ([D67](01-decisions.md)).

What the registers *do* at the bit level is [04-system.md](04-system.md), written by hand.

## `cool8_flash.v`

| | | |
|---|---|---|
| `$FF88` | `FLS_ADDR_L` | SPI flash address, low |
| `$FF89` | `FLS_ADDR_M` | SPI flash address, middle |
| `$FF8A` | `FLS_ADDR_H` | SPI flash address, high |
| `$FF8B` | `FLS_DATA` | read the byte at that address |
| `$FF8C` | `FLS_CTRL` | start a read, select the device |
| `$FF8D` | `FLS_STAT` | busy and done |
| `$FF8E` | `FLS_WDATA` | byte to program |
| `$FF8F` | `FLS_WCTRL` | program and erase control |

## `cool8_pixport.v`

| | | |
|---|---|---|
| `$FF34` | `PIX_X_L` *(also `PIX_X`)* | plot X, low |
| `$FF35` | `PIX_X_H` | plot X, high |
| `$FF36` | `PIX_Y_L` *(also `PIX_Y`)* | plot Y, low |
| `$FF37` | `PIX_Y_H` | plot Y, high |
| `$FF38` | `PIX_DATA` | write plots the pixel at X,Y, then X advances |
| `$FF39` | `PIX_DATA_Y` | write plots the pixel at X,Y, then Y advances |

## `cool8_ps2.v`

| | | |
|---|---|---|
| `$FF40` | `KBD_STAT` | PS/2 status: byte ready, error |
| `$FF41` | `KBD_DATA` | the scancode; reading clears ready |
| `$FF42` | `KBD_CTRL` | interrupt enable and reset |
| `$FF43` | `KBD_TX` | byte to send to the keyboard |
| `$FF44` | `KBD_MOD` | modifier state, decoded in hardware |

## `cool8_snd.v`

| | | |
|---|---|---|
| `$FF50` | `SND_IDX` | voice to address |
| `$FF51` | `SND_DATA` | that voice's registers |

## `cool8_soc.v`

| | | |
|---|---|---|
| `$FF00` | `SYS_CTRL` *(also `IOBASE`)* | system control: reset and bank selects |
| `$FF02` | `SYS_STAT` | system status, read-only |
| `$FF03` | `LED` | the board's LEDs, one per bit |
| `$FF70` | `UART_STAT` | transmit ready, receive ready |
| `$FF71` | `UART_DATA` | read receives, write transmits |
| `$FF72` | `UART_DIV_L` *(also `UART_DIV`)* | baud divisor, low |
| `$FF73` | `UART_DIV_H` | baud divisor, high |
| `$FF80` | `LDR_CTRL` | boot loader control |
| `$FF81` | `LDR_STAT` | boot loader status |

## `cool8_sprite.v`

| | | |
|---|---|---|
| `$FF2A` | `SPR_IDX` | sprite to address |
| `$FF2B` | `SPR_DATA` | that sprite's attribute bytes |
| `$FF2C` | `SPR_CTRL` | per-sprite enable bits |

## `cool8_vport.v`

| | | |
|---|---|---|
| `$FF26` | `VRAM_ADDR_L` *(also `VRAM_ADDR`)* | indirect VRAM address, low |
| `$FF27` | `VRAM_ADDR_H` | indirect VRAM address, high |
| `$FF28` | `VRAM_STEP` | added to the address after each access |
| `$FF29` | `VRAM_DATA` | the byte at that address; access auto-steps |

## `cool8_vregs.v`

| | | |
|---|---|---|
| `$FF10` | `VID_MODE` | screen mode, low nibble |
| `$FF11` | `VID_CTRL` | display enable, sprite enable, blanking |
| `$FF12` | `VID_BASE_L` *(also `VID_BASE`)* | character/bitmap base, low |
| `$FF13` | `VID_BASE_H` | character/bitmap base, high |
| `$FF14` | `VID_STRIDE_L` *(also `VID_STRIDE`)* | bytes per row, low |
| `$FF15` | `VID_STRIDE_H` | bytes per row, high |
| `$FF16` | `VID_SCX_L` *(also `VID_SCX`)* | horizontal scroll, low |
| `$FF17` | `VID_SCX_H` | horizontal scroll, high |
| `$FF18` | `VID_SCY_L` *(also `VID_SCY`)* | vertical scroll, low |
| `$FF19` | `VID_SCY_H` | vertical scroll, high |
| `$FF1A` | `VID_BORDER` | border colour index |
| `$FF1B` | `VID_RASTER` | current raster line, read-only |
| `$FF1C` | `VID_RCMP` | raster line to compare against |
| `$FF1D` | `VID_IRQ` | interrupt enable and acknowledge |
| `$FF1E` | `PAL_IDX` | palette entry to address |
| `$FF1F` | `PAL_DATA` | that entry's colour |
| `$FF20` | `VID_PAT_L` *(also `VID_PAT`)* | pattern/tile base, low |
| `$FF21` | `VID_PAT_H` | pattern/tile base, high |
| `$FF22` | `CUR_X` | text cursor column |
| `$FF23` | `CUR_Y` | text cursor row |
| `$FF24` | `CUR_CTRL` | cursor enable and blink |
| `$FF2D` | `TMR_L` | frames since reset, low byte |
| `$FF2E` | `TMR_M` | ...middle byte |
| `$FF2F` | `TMR_H` | ...high byte |
| `$FF30` | `VID_DBASE_H` | display base override, high byte -- the fetch engine scans from {this,$00} while VID_CTRL bit 6 is set, so VID_BASE can point drawing at a hidden page (D92) |

## Registers no software name reaches

0 of 62. The hardware decodes them and nothing in `sw/` has an equate for one, so reaching them means a bare `POKE $FExx`. Not a fault — several are read-only status or set once by the boot ROM — but the list is generated so it is a decision rather than an oversight.

.

## Registers with more than one software name

10 of them. `IOBASE` is the page itself, and the rest are `sw/io.act`'s `CARD` views of an `_L`/`_H` pair, which share the low byte's address by construction. Two spellings of one address is untidy but harmless, so the check reports rather than refuses; a spelling pointing at the *wrong* address is what it fails on.

| | |
|---|---|
| `$FF00` | `IOBASE` · `SYS_CTRL` |
| `$FF12` | `VID_BASE` · `VID_BASE_L` |
| `$FF14` | `VID_STRIDE` · `VID_STRIDE_L` |
| `$FF16` | `VID_SCX` · `VID_SCX_L` |
| `$FF18` | `VID_SCY` · `VID_SCY_L` |
| `$FF20` | `VID_PAT` · `VID_PAT_L` |
| `$FF26` | `VRAM_ADDR` · `VRAM_ADDR_L` |
| `$FF34` | `PIX_X` · `PIX_X_L` |
| `$FF36` | `PIX_Y` · `PIX_Y_L` |
| `$FF72` | `UART_DIV` · `UART_DIV_L` |
