tomcoolpxl/cool8-cpu/docs/13a-vocabulary.md

# 13a. The vocabulary

**Generated by `tools/vocab.py` from the tables that implement the language — do not edit.** `poe check` fails if this file and the sources disagree, and if any entry has lost its signature.

Names come from `TOKTAB` and `btab`, the bytes the matcher compares against. Return types are declared next to each entry and verified against the tail its handler leaves through. **Argument types are declarations, not proofs** — most handlers read `R0:R1` without testing `STYPE`, which is what `!intonly` marks: a float reaching one is silently wrong rather than an error. Behaviour at the edges is in [13-basic.md](13-basic.md), measured rather than derived.

## Statements

| token | | |
|---|---|---|
| `$80` | `PRINT [item][; \| ,]...` | strings and numbers; a trailing separator holds the newline |
| `$81` | `SUB name` | a definition; stepped over when execution reaches it |
| `$83` | `DIM name(size:int[,size:int[,size:int]])` | up to three dimensions; the name's suffix picks the element -- none integer, # float, $ string `!intonly` |
| `$84` | `RUN` |  |
| `$85` | `FOR var = from:int TO to:int [STEP step:int]` | eight deep `!intonly` |
| `$86` | `NEXT [var]` | naming an outer var closes the inner loops |
| `$88` | `DO [WHILE cond \| UNTIL cond]` |  |
| `$89` | `LOOP [WHILE cond \| UNTIL cond]` |  |
| `$8C` | `EXIT DO` |  |
| `$8D` | `IF cond THEN stmt [ELSE stmt]` | single line; the arm is one statement |
| `$8F` | `ELSE stmt` |  |
| `$90` | `ELSEIF cond THEN stmt` |  |
| `$91` | `END` |  |
| `$92` | `RETURN` |  |
| `$93` | `CALL name` | no parameters and no locals |
| `$98` | `POKE addr:int, value:int` | `!intonly` |
| `$9E` | `SYS addr:int \| name:string` | jumps to an address, or loads a PRG and jumps where its first two bytes say `!intonly` |
| `$A2` | `GOTO line:int` |  |
| `$A5` | `MODE n:int` | `!intonly` |
| `$A6` | `VSYNC` | waits for the next frame |
| `$A8` | `COLOR fg:int[, bg:int]` | the pen every PRINT, CLS and scroll writes. 0-15 each; with no bg the paper stays as it was |
| `$A9` | `CURSOR on:int[, rate:int]` | 0 off, 1 on. Rate 0-3 is 8, 16, 32 frames a phase and 3 is solid; the blink is the hardware's |
| `$AB` | `SOUND voice:int, pitch:int, volume:int, length:int` | `!intonly` |
| `$AD` | `PLOT x:int, y:int, colour:int` | `!intonly` |
| `$AE` | `LINE x1:int, y1:int, x2:int, y2:int, colour:int` | `!intonly` |
| `$AF` | `INPUT var` | a line of text; the variable's suffix decides -- string, float or integer |
| `$B0` | `DATA n[, n]...` | numbers only; skipped when execution reaches it |
| `$B1` | `READ var[, var]...` | scalar targets only |
| `$B2` | `RESTORE` |  |
| `$B4` | `ON e:int GOTO line[, line]...` | literal lines; out of range falls through |
| `$B6` | `CLG colour:int` | `!intonly` |
| `$B7` | `PITCH voice:int, pitch:int` | `!intonly` |
| `$B8` | `GTEXT x:int, y:int, text:string` | `!intonly` |
| `$B9` | `LIST [from:int][, to:int]` |  |
| `$BA` | `NEW` |  |
| `$BB` | `FREE` | prints the bytes left |
| `$BC` | `RENUM` |  |
| `$BD` | `DELETE from:int[, to:int]` |  |
| `$BE` | `CLS` |  |
| `$BF` | `SAVE name:string [AT addr:int, len:int]` | no AT saves the program; AT saves len bytes of memory, and the length is not optional |
| `$C0` | `LOAD name:string [AT addr:int \| , line:int]` | no AT loads a program and chains into it; AT loads raw bytes, the file's own length; a comma merges from that line up |
| `$C1` | `DIR` |  |
| `$C2` | `ERA name:string` |  |
| `$C3` | `COMPACT` |  |
| `$C4` | `DRIVE n:int` |  |
| `$C5` | `REM text` | stored verbatim; nothing inside is tokenised |
| `$C7` | `CLEAR` | every variable away, the program kept |
| `$C8` | `LOCAL name[,name]` | inside a SUB: the caller's values come back on RETURN |
| `$CB` | `PAUSE frames:int` | wait, still answering the break key `!intonly` |
| `$CC` | `CONT` | resume a program the break key stopped |
| `$CE` | `STOP` | stops with ?BREAK, and CONT resumes; the break key's own tail |
| `$CF` | `OPENIN name:string` | positions a read stream at the file's first byte; one at a time |
| `$D0` | `CLOSE` | abandons the read stream; harmless if none is open |
| `$D2` | `GOSUB line:int` | call a line; RETURN comes back. Shares CALL's frame and its depth limit |

## Tokenised, but not statements

These hold a token but `sttab` sends them to `bad`, so meeting one where a statement was expected is `?SYNTAX`. Three reasons, all marked below: a **clause** the tokeniser matches inside something else (`TO` in a `FOR`, `THEN` in an `IF`); a **function** reached from `prim` rather than dispatched; or a command that was **removed**, whose token stays because the order of `TOKTAB` fixes every byte after it and programs on disk hold the old numbering.

| token | | |
|---|---|---|
| `$82` | `! -- reserved` | was FUNCTION, which only ever parsed as SUB |
| `$87` | `TO` | |
| `$8A` | `WHILE` | |
| `$8B` | `UNTIL` | |
| `$8E` | `THEN` | |
| `$94` | `AS` | |
| `$95` | `INT(a:float) -> int` | floors; the float-to-integer crossing |
| `$96` | `BYTE` | |
| `$97` | `PEEK(addr:int) -> int` | a function, not a statement `!intonly` |
| `$99` | `AND` | |
| `$9A` | `OR` | |
| `$9B` | `XOR` | |
| `$9C` | `CARD` | |
| `$9D` | `AT` | |
| `$9F` | `EXTERN` | |
| `$A0` | `INCLUDE` | |
| `$A1` | `INLINE` | |
| `$A3` | `WEND` | |
| `$A4` | `(reserved)` | K_NUM: a numeric literal with two binary bytes after it. The "?" entry in TOKTAB holds the slot open |
| `$A7` | `(removed)` | was SCROLL dx, dy -- POKE VID_SCX/VID_SCY, see 04a-registers.md |
| `$AA` | `(removed)` | was VPOKE addr, value -- POKE VRAM_ADDR_L/H, VRAM_STEP, then VRAM_DATA, which auto-steps |
| `$AC` | `(removed)` | was HLINE x, y, n, colour -- set PIX_X/PIX_Y, then POKE PIX_DATA n times; the port steps X itself |
| `$B3` | `STEP` | |
| `$B5` | `(removed)` | was TILE x, y, tile, attr -- the map entry through the VRAM port |
| `$C6` | `! -- reserved` | the float literal marker, never a statement |
| `$C9` | `TAB(col:int)` | in PRINT: spaces out to that column, or nothing if already past it |
| `$CA` | `SPC(n:int)` | in PRINT: n spaces |
| `$CD` | `NOT n:int` | -1 - n, bitwise; binds looser than a comparison and tighter than AND `!intonly` |
| `$D1` | `ON ERROR GOTO line:int` | arm a handler; GOTO 0 disarms. ERR says which fault fired |

## Functions

Matched by name, not tokenised — they have no token byte.

| | |
|---|---|
| `LEN(s:string) -> int` |  |
| `LEFT$(s:string, n:int) -> string` | clamps past the end |
| `RIGHT$(s:string, n:int) -> string` | clamps past the end |
| `MID$(s:string, start:int[, n:int]) -> string` | two arguments run to the end; empty past the end |
| `CHR$(n:int) -> string` | `!intonly` |
| `ASC(s:string) -> int` |  |
| `STR$(n:int\|float) -> string` | a float renders as PRINT would |
| `VAL(s:string) -> same` | a fraction gives a float, four digits of it; nonsense is 0 |
| `INSTR(hay:string, needle:string) -> int` |  |
| `INKEY -> int` | 0 when nothing was typed |
| `KEY(code:int) -> int` | is that key held down `!intonly` |
| `RND(n:int) -> int` | 0..n-1; RND(0) is the raw word `!intonly` |
| `TIMER -> int` | frames since boot |
| `ERR -> int` | the code of the fault ON ERROR caught, 0 if none has |
| `BGET -> int` | the next byte of the open stream, or -1 past the end |
| `EOF -> int` | -1 when the stream has no more bytes, or none is open |
| `GET$ -> string` | one line of the open stream, without its CR; empty at the end |
| `POS -> int` | the cursor's column, 0 at the left margin |
| `VPOS -> int` | the cursor's row, 0 at the top |
| `TRUE -> int` | -1, which is what a comparison answers ([D47]) |
| `FALSE -> int` | 0 |
| `STRING$(n:int, s:string) -> string` | s repeated n times; 0 gives the empty string |
| `VPEEK(addr:int) -> int` | `!intonly` |
| `PI -> float` | 3.1416, from the table fatan folds against |
| `SIN(x:float) -> float` | radians |
| `COS(x:float) -> float` | radians |
| `TAN(x:float) -> float` | radians; unchecked at a pole |
| `ATN(x:float) -> float` | radians |
| `SQR(x:float) -> float` | a negative returns the argument, silently |
| `LOG(x:float) -> float` | natural; not-positive returns the argument |
| `EXP(x:float) -> float` |  |
| `FLT(n:int) -> float` |  |
| `ABS(n:int\|float) -> same` | keeps the type it was given |
| `SGN(n:int\|float) -> int` | -1, 0 or 1, always an integer |

## The `!intonly` list

18 of them. Each reads `R0:R1` and never tests `STYPE`, so handing one a float does not raise an error — it acts on whatever the integer registers last held. This list is generated so it cannot quietly grow.

`DIM`, `FOR`, `PEEK`, `POKE`, `SYS`, `MODE`, `SOUND`, `PLOT`, `LINE`, `CLG`, `PITCH`, `GTEXT`, `PAUSE`, `NOT`, `CHR$`, `KEY`, `RND`, `VPEEK`.
