tomcoolpxl/cool8-cpu/docs/15-action.md

# 15 — CoolAction!, the compiled language

**Normative for the language, its calling convention, and the
compiler's command line.** [D97](01-decisions.md#d97--coolaction-a-compiled-language-for-games-cross-compiled-in-rust)
is the argument for having it; this is what it is.

CoolAction! is a small structured language for games and demos,
compiled on the host to a COOL8 PRG. It is Clinton Parker's
Action! (OSS, 1983) with C's operators, and it exists because a 60 Hz
game is the one job the BASIC interpreter of [13-basic.md](13-basic.md)
was never going to do. `BYTE`, `CARD`, `INT`, pointers, arrays, records,
`PROC`/`FUNC`, and nothing else: no strings beyond a length-prefixed
array, no floats, no heap.
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
