tomcoolpxl/cool8-cpu/assets/arkanoid/arcade_vaus_world.png

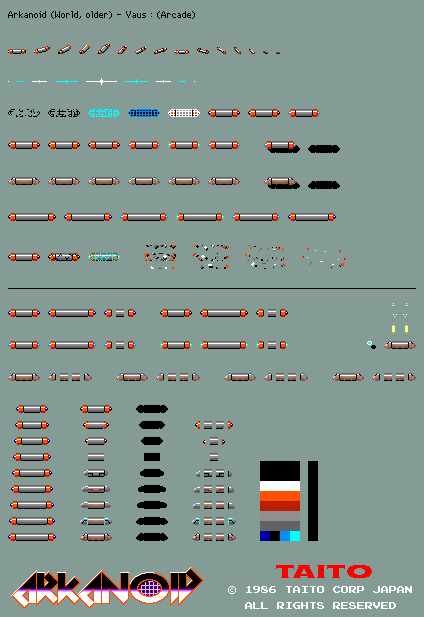
assets/arkanoid/arcade_vaus_world.png
