tomcoolpxl/cool8-cpu/assets/arkanoid/preview.png

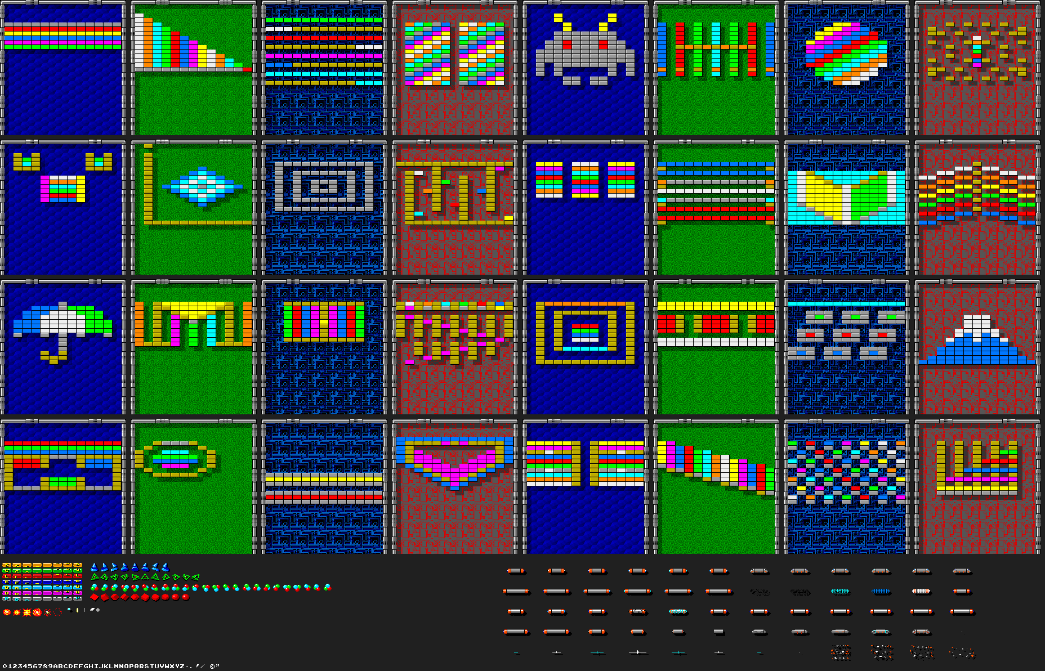
assets/arkanoid/preview.png
