tomcoolpxl/cool8-cpu/assets/blockade/Blockade_gameplay.png

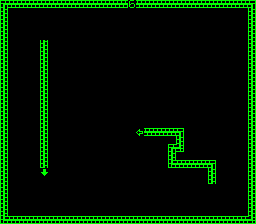
assets/blockade/Blockade_gameplay.png
