tomcoolpxl/cool8-cpu/assets/coolsw/preview.png

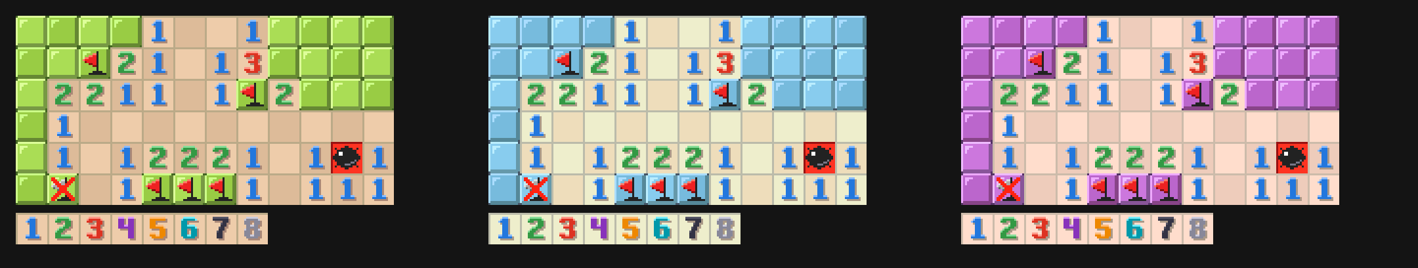
assets/coolsw/preview.png
