tomcoolpxl/cool8-cpu/assets/cooltris/preview.png

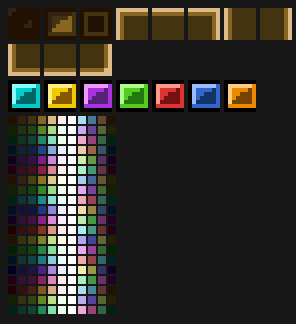
assets/cooltris/preview.png
