tomcoolpxl/cool8-cpu/assets/galaga/preview.png

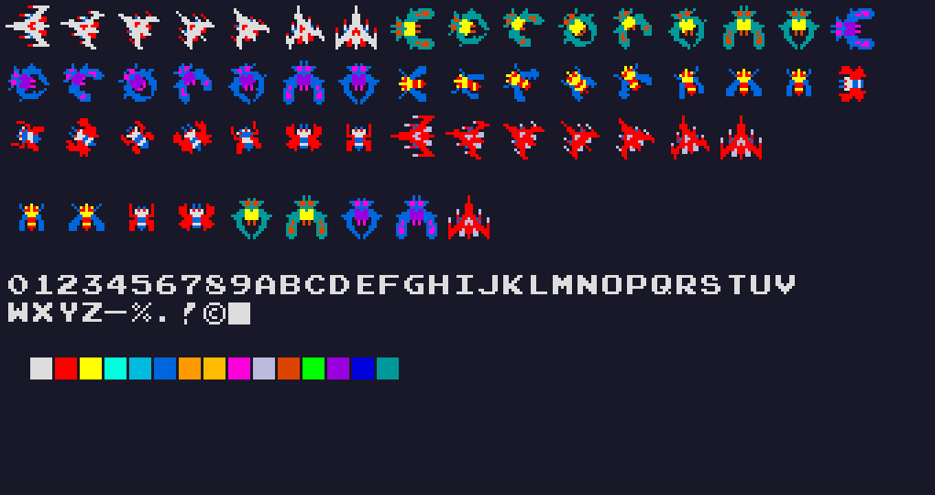
assets/galaga/preview.png
