tomcoolpxl/cool8-cpu/assets/misscool/arcade_mspacman_general.png

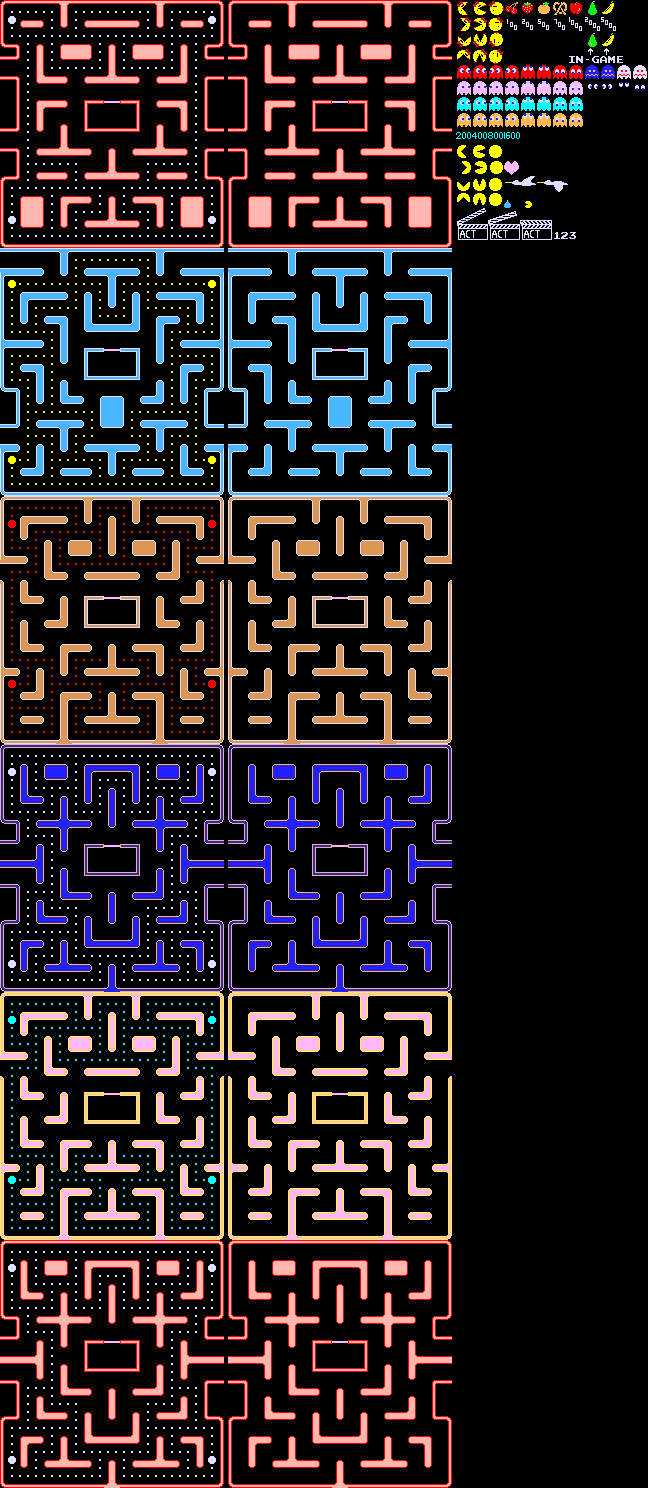
assets/misscool/arcade_mspacman_general.png
