tomcoolpxl/cool8-cpu/assets/misscool/preview.png

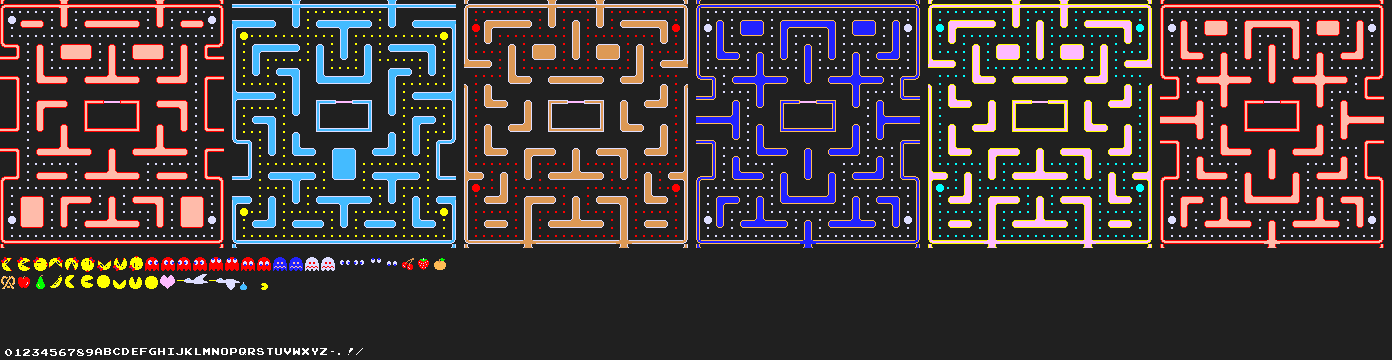
assets/misscool/preview.png
