tomcoolpxl/cool8-cpu/assets/mott/preview.png

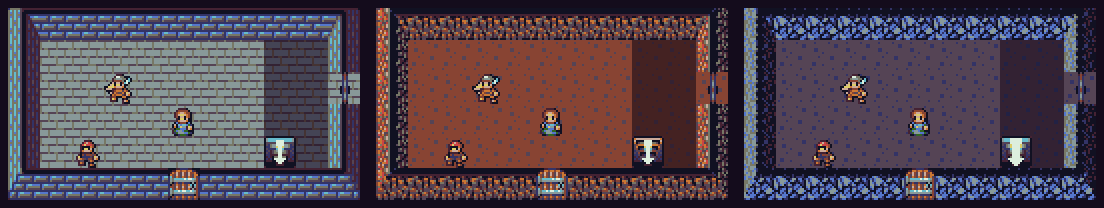
assets/mott/preview.png
