tomcoolpxl/cool8-cpu/docs/img/demo-bapple-early.png

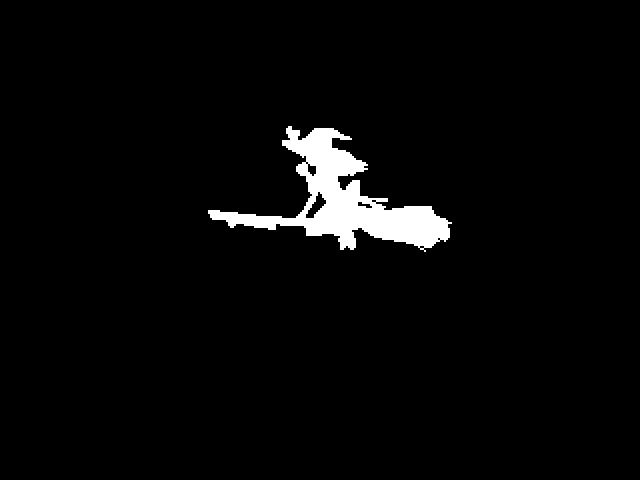
docs/img/demo-bapple-early.png
