tomcoolpxl/cool8-cpu/docs/img/demo-hhgg.png

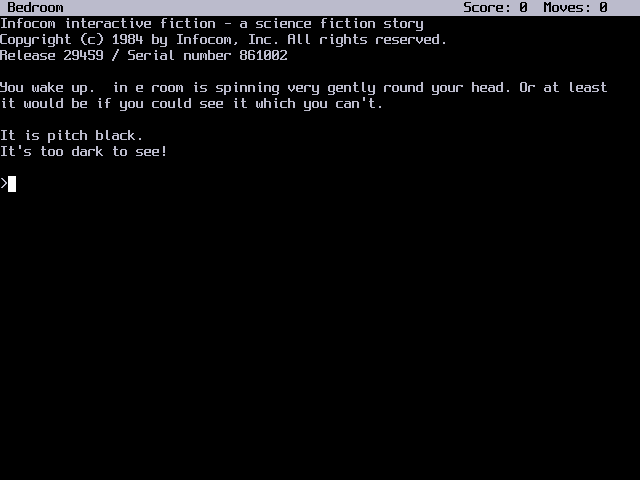
docs/img/demo-hhgg.png
