tomcoolpxl/cool8-cpu/docs/img/screenshot-2026-08-16-015423.png

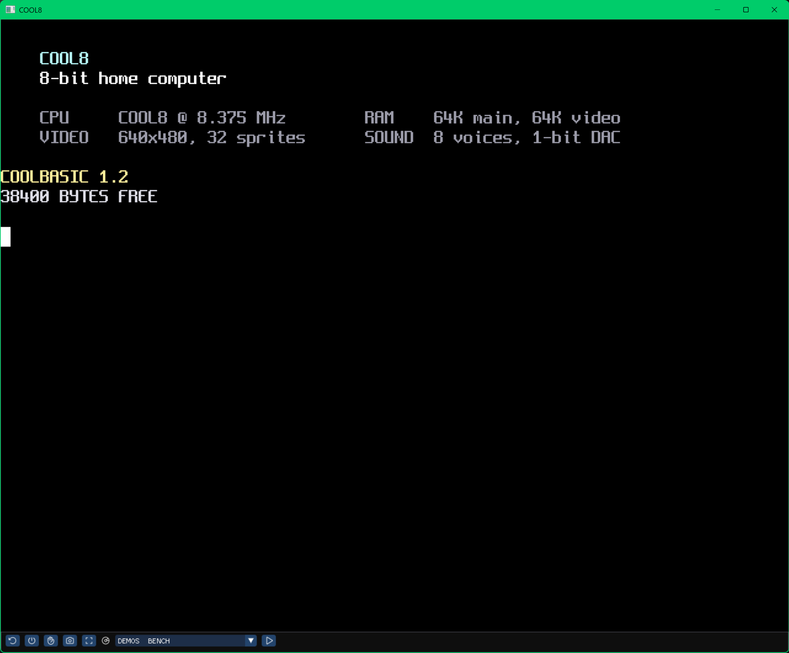
docs/img/screenshot-2026-08-16-015423.png
