tomcoolpxl/cool8-cpu/docs/img/text-mode-0.png

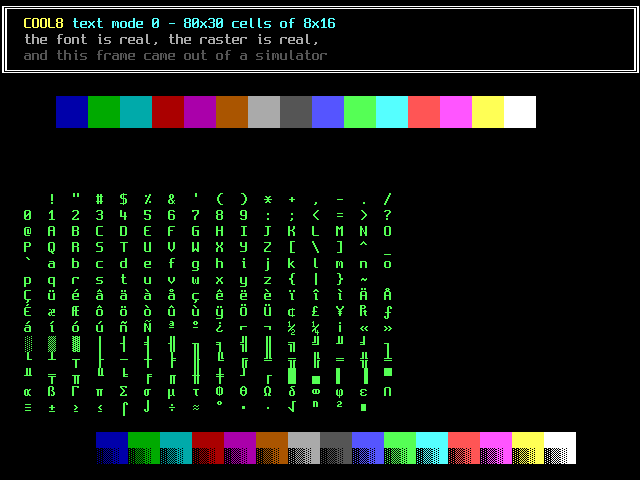
docs/img/text-mode-0.png
