tomcoolpxl/cool8-cpu/docs/img/raster-test-pattern.png

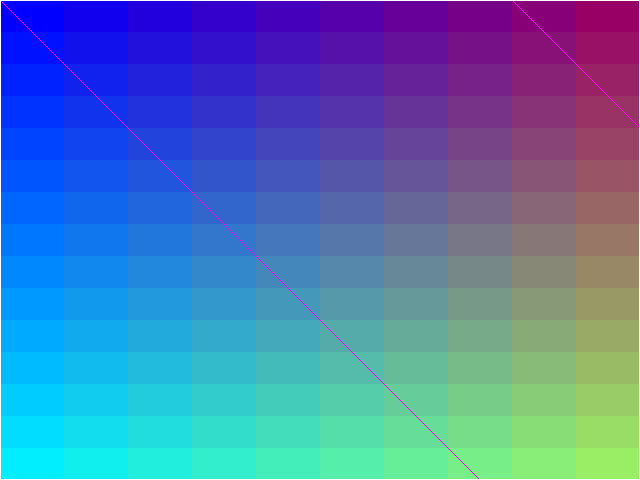
docs/img/raster-test-pattern.png
