tomcoolpxl/cool8-cpu/rust/src/machine.rs

// The COOL8 machine — a hand port of tools/cool8vm.py's Machine, its
// bus and its peripherals, to the same rule as cpu.rs: cool8vm.py is
// the reference, this copy is never authoritative, and sim/rustsim.py
// diffs the two per retired instruction over a real boot with the RAM
// and the VRAM compared at the end.
//
// What is here is what the CPU can see: the register files, the FIFOs,
// the flash, the scanline accounting that makes time pass. Rendering is
// deliberately absent — cool8vid.py stays the only renderer — and so is
// the font, which no register exposes.
//
// The machine is scanline-accurate through tick(), cool8vm's own
// discipline: one instruction, then the raster, the sound clock and the
// interrupt flags kept in step through the owed-cycles accumulator.
// Both sides of the parity diff must use tick(), not run_line(): the
// two differ in how a line boundary falls mid-instruction, and mixing
// them diverges the interrupt timing.

use crate::cpu::{Bus, Cpu};
use std::collections::VecDeque;

// docs/04-system.md section 5.1 and D32.
pub const CYCLES_PER_LINE: u64 = 266;
pub const V_TOTAL: u32 = 525;
const SND_DIV: u64 = 256;

// ------------------------------------------------------------------ UART

pub struct Uart {
    pub rx: VecDeque<u8>,
    pub tx: Vec<u8>, // everything the machine has said
    pub overrun: bool,
    pub div: u16,
}

impl Uart {
    const DEPTH: usize = 16;

    fn new() -> Uart {
        Uart { rx: VecDeque::new(), tx: Vec::new(), overrun: false, div: 72 }
    }

    pub fn feed(&mut self, data: &[u8]) {
        for &b in data {
            if self.rx.len() < Uart::DEPTH {
                self.rx.push_back(b);
            } else {
                self.overrun = true;
            }
        }
    }

    fn read(&mut self, a: u8) -> u8 {
        match a {
            0x70 => {
                (if self.rx.is_empty() { 0 } else { 0x01 })
                    | 0x02
                    | (if self.overrun { 0x04 } else { 0 })
            }
            0x71 => self.rx.pop_front().unwrap_or(0xFF),
            0x72 => self.div as u8,
            0x73 => (self.div >> 8) as u8,
            _ => 0xFF,
        }
    }

    fn write(&mut self, a: u8, v: u8) {
        match a {
            0x70 => {
                if v & 0x04 != 0 {
                    self.overrun = false;
                }
            }
            0x71 => self.tx.push(v),
            0x72 => self.div = (self.div & 0xFF00) | v as u16,
            0x73 => self.div = (self.div & 0x00FF) | (v as u16) << 8,
            _ => {}
        }
    }
}

// ------------------------------------------------------------------- PS/2

pub struct Ps2 {
    pub q: VecDeque<u8>,
    pub overrun: bool,
    pub irq_en: bool,
    // The modifiers and the two chords, as cool8_ps2.v decodes them
    // from the arriving bytes. Tracked on arrival rather than on a
    // successful enqueue: a key really did move even if the queue was
    // full and dropped the byte.
    pub m_shift: bool,
    pub m_ctrl: bool,
    pub m_alt: bool,
    brk_p: bool,
    pub warm_l: bool,
    /// Set when a chord arrives; the machine services them on its next
    /// tick, which is where an NMI or a reset can actually be applied.
    pub warm_pending: bool,
    pub reset_pending: bool,
}

impl Ps2 {
    const DEPTH: usize = 16;

    fn new() -> Ps2 {
        Ps2 {
            q: VecDeque::new(),
            overrun: false,
            irq_en: false,
            m_shift: false,
            m_ctrl: false,
            m_alt: false,
            brk_p: false,
            warm_l: false,
            warm_pending: false,
            reset_pending: false,
        }
    }

    pub fn feed(&mut self, codes: &[u8]) {
        for &b in codes {
            self.track(b);
            if self.q.len() < Ps2::DEPTH {
                self.q.push_back(b);
            } else {
                self.overrun = true;
            }
        }
    }

    /// The modifier and chord decode of cool8_ps2.v, byte for byte.
    /// $E0 is not consumed: left and right Ctrl differ only by that
    /// prefix and are one key here, the same call sw/kdown.asm makes.
    fn track(&mut self, b: u8) {
        if b == 0xF0 {
            self.brk_p = true;
            return;
        }
        if b == 0xE0 {
            return;
        }
        let down = !self.brk_p;
        self.brk_p = false;
        match b {
            0x12 | 0x59 => self.m_shift = down,
            0x14 => self.m_ctrl = down,
            0x11 => self.m_alt = down,
            0x76 if down && self.m_ctrl => {
                if self.m_shift {
                    self.reset_pending = true;
                } else {
                    self.warm_pending = true;
                    self.warm_l = true;
                }
            }
            _ => {}
        }
    }

    fn irq(&self) -> bool {
        self.irq_en && !self.q.is_empty()
    }

    fn read(&mut self, a: u8) -> u8 {
        match a {
            0x40 => {
                (if self.q.is_empty() { 0 } else { 0x01 })
                    | (if self.overrun { 0x02 } else { 0 })
            }
            0x41 => self.q.pop_front().unwrap_or(0xFF),
            0x42 => if self.irq_en { 0x10 } else { 0x00 },
            0x44 => {
                (if self.m_shift { 0x01 } else { 0 })
                    | (if self.m_ctrl { 0x02 } else { 0 })
                    | (if self.m_alt { 0x04 } else { 0 })
                    | (if self.warm_l { 0x08 } else { 0 })
            }
            _ => 0xFF,
        }
    }

    fn write(&mut self, a: u8, v: u8) {
        match a {
            0x40 => {
                if v & 0x02 != 0 {
                    self.overrun = false;
                }
            }
            0x42 => {
                self.irq_en = v & 0x10 != 0;
                if v & 0x01 != 0 {
                    self.q.clear();
                }
            }
            0x44 => {
                if v & 0x08 != 0 {
                    self.warm_l = false;
                }
            }
            _ => {}
        }
    }
}

// ------------------------------------------------------------------ flash

pub struct Flash {
    pub mem: Vec<u8>,
    addr: u32,
    open_r: bool,
    /// When the prefetched byte is there: cool8_flash's `pf_valid`, kept
    /// as a clock. A read of FLS_DATA before it is held off until it,
    /// which is `o_stall` holding mem_ready low -- `MachineBus::wait`.
    ready_at: u64,
    wdata: u8,
    denied: bool,
    /// A program or erase landed: the emulator writes the image back
    /// at exit so SAVE survives the window closing, as cool8run.py's
    /// flush does. Batch and parity runs never write back.
    pub dirty: bool,
}

impl Flash {
    const SIZE: usize = 8 << 20;
    const FLOOR: u32 = 0x100000;
    const SECTOR: usize = 4096;
    /// cool8_flash's shifter in system clocks, as sim/tb/cool8_flash_tb.v
    /// measures it on the RTL: four clocks a bit, so the first byte is
    /// there 161 after the stream opens -- the 32-bit command, then a
    /// byte -- and each one after it 34 after the read before, 32 on the
    /// wire and two to hand it over and arm the next. Until SLIDES timed
    /// its picture stream this model handed every byte over at once, and
    /// a loop the board runs at 34 clocks a byte measured 14 here.
    const FIRST: u64 = 161;
    const BYTE: u64 = 34;

    fn new(image: Option<Vec<u8>>) -> Flash {
        let mut mem = vec![0xFFu8; Flash::SIZE];
        if let Some(d) = image {
            let n = d.len().min(Flash::SIZE);
            mem[..n].copy_from_slice(&d[..n]);
        }
        Flash { mem, addr: 0, open_r: false, ready_at: 0, wdata: 0,
                denied: false, dirty: false }
    }

    /// A read at clock `t`: the value, and the clocks it was held off.
    fn read(&mut self, a: u8, t: u64) -> (u8, u64) {
        match a {
            0x88 => (self.addr as u8, 0),
            0x89 => ((self.addr >> 8) as u8, 0),
            0x8A => ((self.addr >> 16) as u8, 0),
            0x8B => {
                // a read advances the stream; with none open nothing is
                // on its way, and there is nothing to wait for
                if !self.open_r {
                    return (0xFF, 0);
                }
                let held = self.ready_at.saturating_sub(t);
                let b = self.mem[self.addr as usize % Flash::SIZE];
                self.addr = (self.addr + 1) & 0xFFFFFF;
                self.ready_at = t + held + Flash::BYTE;
                (b, held)
            }
            0x8C => (if self.open_r { 0x01 } else { 0x00 }, 0),
            // bit 1 the stream open, bit 0 the shifter still at the next
            // byte -- a read that never stalls, as the RTL's does not
            0x8D => (if !self.open_r { 0x00 }
                     else if t < self.ready_at { 0x03 } else { 0x02 }, 0),
            0x8F => (if self.denied { 0x04 } else { 0x00 }, 0),
            _ => (0xFF, 0),
        }
    }

    /// A write at clock `t`.
    fn write(&mut self, a: u8, v: u8, t: u64) {
        match a {
            0x88 | 0x89 | 0x8A if !self.open_r => {
                let sh = match a {
                    0x88 => 0,
                    0x89 => 8,
                    _ => 16,
                };
                self.addr = (self.addr & !(0xFF << sh)) | (v as u32) << sh;
            }
            0x8C => {
                // opening sends the command and fetches the first byte
                // behind it; a 1 written to an open stream opens nothing
                if v & 1 != 0 && !self.open_r {
                    self.ready_at = t + Flash::FIRST;
                }
                self.open_r = v & 1 != 0;
            }
            0x8E => self.wdata = v,
            0x8F => {
                if v & 0x04 != 0 {
                    self.denied = false;
                }
                if self.open_r {
                    return;
                }
                if v & 0x01 != 0 {
                    // program: a flash can only clear bits
                    if self.addr < Flash::FLOOR {
                        self.denied = true;
                    } else {
                        let i = self.addr as usize % Flash::SIZE;
                        self.mem[i] &= self.wdata;
                        self.dirty = true;
                    }
                } else if v & 0x02 != 0 {
                    // erase the 4 KB sector
                    if self.addr < Flash::FLOOR {
                        self.denied = true;
                    } else {
                        let base = (self.addr as usize % Flash::SIZE)
                            & !(Flash::SECTOR - 1);
                        self.mem[base..base + Flash::SECTOR].fill(0xFF);
                        self.dirty = true;
                    }
                }
            }
            _ => {}
        }
    }
}

// ------------------------------------------------------------------ sound

pub struct Sound {
    inc: [u16; 8],
    phase: [u16; 8],
    vol: [u8; 8],
    enable: [bool; 8],
    noise: [bool; 8],
    idx: u8,
    hold: u8,
    lfsr: u16,
    pub samples: Vec<u8>, // unsigned 8-bit, SND_HZ
}

impl Sound {
    const VOICES: usize = 8;

    /// The programmed voice array, in the register layout software
    /// wrote it through SND_IDX/SND_DATA: per voice, inc lo/hi at
    /// 8v+0/1, the (engine-owned) phase at 8v+2/3, volume at 8v+4,
    /// noise/enable bits at 8v+5. What a harness comparing two
    /// programs' sound setup wants to see.
    pub fn dump(&self) -> [u8; 64] {
        let mut out = [0u8; 64];
        for v in 0..Sound::VOICES {
            out[8 * v] = self.inc[v] as u8;
            out[8 * v + 1] = (self.inc[v] >> 8) as u8;
            out[8 * v + 2] = self.phase[v] as u8;
            out[8 * v + 3] = (self.phase[v] >> 8) as u8;
            out[8 * v + 4] = self.vol[v];
            out[8 * v + 5] = ((self.noise[v] as u8) << 7)
                | ((self.enable[v] as u8) << 6);
        }
        out
    }

    fn new() -> Sound {
        Sound {
            inc: [0; 8],
            phase: [0; 8],
            vol: [0; 8],
            enable: [false; 8],
            noise: [false; 8],
            idx: 0,
            hold: 0,
            lfsr: 0xACE1,
            samples: Vec::new(),
        }
    }

    fn write(&mut self, a: u8, v: u8) {
        if a == 0x50 {
            self.idx = v & 0x3F;
        } else if a == 0x51 {
            if self.idx & 1 != 0 {
                // the odd byte commits the word
                let word = (v as u16) << 8 | self.hold as u16;
                let (vc, which) = ((self.idx >> 3) as usize,
                                   (self.idx >> 1) & 3);
                if vc < Sound::VOICES {
                    if which == 0 {
                        self.inc[vc] = word;
                    } else if which == 1 {
                        self.phase[vc] = word;
                    } else {
                        self.vol[vc] = (word & 0x0F) as u8;
                        self.enable[vc] = word & 0x4000 != 0;
                        self.noise[vc] = word & 0x8000 != 0;
                    }
                }
            } else {
                self.hold = v;
            }
            self.idx = (self.idx + 1) & 0x3F;
        }
    }

    /// One mixed sample, signed, in the mixer's own -128..127 range.
    fn sample(&mut self) -> i32 {
        let mut mix: i32 = 0;
        for v in 0..Sound::VOICES {
            let nxt = (self.phase[v] as u32 + self.inc[v] as u32) & 0x1FFFF;
            let wrapped = nxt > 0xFFFF;
            let old = self.phase[v];
            self.phase[v] = nxt as u16;
            if !self.enable[v] {
                continue;
            }
            let wave = if self.noise[v] {
                let w = self.lfsr & 1;
                if wrapped {
                    let bit = ((self.lfsr >> 15) ^ (self.lfsr >> 13)
                        ^ (self.lfsr >> 12) ^ (self.lfsr >> 10)) & 1;
                    self.lfsr = (self.lfsr << 1) | bit;
                }
                w
            } else {
                (old >> 15) & 1
            };
            mix += if wave != 0 { self.vol[v] as i32 } else { -(self.vol[v] as i32) };
        }
        mix.clamp(-128, 127)
    }

    /// The byte the modulator is fed. The halving is the headroom that
    /// lets eight voices sum without the pin clipping — see cool8vm.py.
    fn level(&mut self) -> u8 {
        (128 + (self.sample() >> 1)) as u8
    }

    fn tick(&mut self, n: u64) {
        for _ in 0..n {
            let l = self.level();
            self.samples.push(l);
        }
    }
}

// ------------------------------------------------------------------ video

/// The register file, VRAM, and the state a frame is drawn from —
/// everything software can see and set, and nothing about how a
/// scanline is assembled.
pub struct Video {
    pub vram: Box<[u8; 0x10000]>,
    pub pal: [u16; 256],

    pub mode: u8,
    pub ctrl: u8,
    /// D92: the page on the glass while ctrl bit 6 splits it from base
    pub dbase: u8,
    pub base: u16,
    /// Where the map starts, as opposed to which row is shown first.
    /// Latched from the mode preset; a scroll moves `base` and not this.
    pub map_org: u16,
    pub stride: u16,
    pub pat_base: u16,
    pub scrl_x: u16,
    pub scrl_y: u16,
    pub border: u8,
    pub rcmp: u8,
    pub irq_en: u8,
    pub irq_fl: u8,
    pub vactive: u16,
    pub raster: u32,
    /// The clock `raster` last changed on: the machine's end of a line.
    pub raster_at: u64,
    /// With the log on, every palette entry committed: (clocks since
    /// `raster_at`, `raster`, the entry, its $0RGB). `pallog`'s.
    pub pal_log: Option<Vec<(u64, u32, u8, u16)>>,
    pub blink: u32, // frames; the phase restarts on a move
    /// Frames since reset, free-running, 24 bits — the machine's clock.
    /// Counted here and not by a handler, so nothing can miss a tick.
    pub tmr: u32,

    pal_idx: u8,
    pal_half: bool,
    pal_red: u8,

    pub cur_x: u8,
    pub cur_y: u8,
    pub cur_ctrl: u8,
    pub cur_lines: u8,

    // VRAM port
    vaddr: u16,
    vstep: u8,

    // pixel port
    pix_x: u16,
    pix_y: u16,

    // sprites: 32 descriptors of 8 bytes
    pub spr: [u8; 256],
    spr_idx: u8,
    spr_hold: u8,
    pub spr_en: bool,
    pub spr_overrun: bool,
    pub spr_bank: u8,
}

// Mode presets, as cool8vm.Video.PRESETS: (ctrl, base, stride, vactive).
const PRESETS: [(u8, u16, u16, u16); 7] = [
    (0b00_00_00, 0x9800, 160, 480),
    (0b01_00_00, 0x9800, 160, 480),
    (0b11_10_01, 0x0000, 128, 480),
    (0b00_00_10, 0x0000, 80, 480),
    (0b11_10_10, 0x0000, 160, 480),
    (0b11_10_10, 0x0000, 128, 384),
    (0b11_11_10, 0x0000, 256, 480),
];

impl Video {
    fn new() -> Video {
        Video {
            vram: vec![0u8; 0x10000].into_boxed_slice().try_into().unwrap(),
            pal: crate::pal::DEFAULT,   // the bitstream's, see tools/palette.py
            mode: 0,
            ctrl: 0,
            dbase: 0,
            base: 0x9800,
            map_org: 0x9800,
            stride: 160,
            pat_base: 0,
            scrl_x: 0,
            scrl_y: 0,
            border: 0,
            rcmp: 0,
            irq_en: 0,
            irq_fl: 0,
            vactive: 480,
            raster: 0,
            raster_at: 0,
            pal_log: None,
            blink: 0,
            tmr: 0,
            pal_idx: 0,
            pal_half: false,
            pal_red: 0,
            cur_x: 0,
            cur_y: 0,
            cur_ctrl: 0,
            cur_lines: 0xF0,
            vaddr: 0,
            vstep: 1,
            pix_x: 0,
            pix_y: 0,
            spr: [0; 256],
            spr_idx: 0,
            spr_hold: 0,
            spr_en: false,
            spr_overrun: false,
            spr_bank: 0,
        }
    }

    pub fn bpp_log(&self) -> u8 {
        (self.ctrl >> 2) & 3
    }

    /// One line's sprite work, planned as cool8_sprite.v performs it
    /// and exactly as cool8vm.Video.scan_sprites states it: up to
    /// eight hits in descriptor order (trailing rows counting), a
    /// ninth setting the overrun flag, and the render budget — the
    /// RTL's own stated costs against the 266-clock line — deciding
    /// how many of the *last-rendered* sprites, which are the
    /// lowest-numbered ones, are lost. Returns (hits, lost, ninth).
    pub fn sprite_plan(&self, line: u32)
        -> ([(usize, bool, bool, u32); 8], usize, usize, bool) {
        let mut hits = [(0usize, false, false, 0u32); 8];
        let mut n = 0;
        let mut ninth = false;
        for si in 0..32 {
            let d1 = self.spr[si * 8 + 1];
            if d1 & 0x40 == 0 {
                continue;
            }
            let big = d1 & 0x80 != 0;
            let h = if big { 16u32 } else { 8 };
            let y = ((d1 as u32 & 0x01) << 8) | self.spr[si * 8] as u32;
            let dy = line.wrapping_sub(y) & 0x3FF;
            let trail = dy >= h;
            if !(dy < h + 2 && (line < 480 || trail)) {
                continue;
            }
            if n == 8 {
                ninth = true;
                continue;
            }
            hits[n] = (si, big, trail, dy);
            n += 1;
        }

        // The render costs as the RTL's header counts them: ~33 clocks
        // for a 16x16, the scan and sweep leading in, trailing rows
        // cheaper because they fetch nothing. Behaviour, not clock
        // exactness: a render outrun by the next line loses its tail.
        let mut budget: i32 = 266 - 34;
        let mut lost = 0usize;
        for want_trail in [true, false] {
            for &(_, big, trail, _) in hits[..n].iter().rev() {
                if trail != want_trail {
                    continue;
                }
                let c: i32 = match (big, trail) {
                    (true, true) => 21,
                    (false, true) => 13,
                    (true, false) => 33,
                    (false, false) => 21,
                };
                if lost > 0 || c > budget {
                    if !trail {
                        lost += 1; // a lost trailing row draws nothing
                    }
                } else {
                    budget -= c;
                }
            }
        }
        (hits, n, lost, ninth)
    }

    pub fn scan_sprites(&mut self, line: u32) {
        let (_, _, lost, ninth) = self.sprite_plan(line);
        if lost > 0 || ninth {
            self.spr_overrun = true;
        }
    }

    fn irq(&self) -> bool {
        self.irq_fl & (self.irq_en >> 4) != 0
    }

    fn step_val(&self) -> u16 {
        match self.vstep & 7 {
            0 => 0,
            1 => 1,
            2 => 2,
            3 => 4,
            4 => 8,
            5 => 16,
            6 => 256,
            _ => self.stride,
        }
    }

    fn vadvance(&mut self) {
        let d = self.step_val();
        self.vaddr = if self.vstep & 8 != 0 {
            self.vaddr.wrapping_sub(d)
        } else {
            self.vaddr.wrapping_add(d)
        };
    }

    fn read(&mut self, a: u8) -> u8 {
        match a {
            0x10 => self.mode,
            0x11 => self.ctrl,
            0x30 => self.dbase,
            0x12 => self.base as u8,
            0x13 => (self.base >> 8) as u8,
            0x14 => self.stride as u8,
            0x15 => (self.stride >> 8) as u8,
            0x16 => self.scrl_x as u8,
            0x17 => (self.scrl_x >> 8) as u8,
            0x18 => self.scrl_y as u8,
            0x19 => (self.scrl_y >> 8) as u8,
            0x1A => self.border,
            0x1B => self.raster as u8,
            0x1C => self.rcmp,
            0x1D => self.irq_en | self.irq_fl,
            0x1E => self.pal_idx,
            0x20 => self.pat_base as u8,
            0x21 => (self.pat_base >> 8) as u8,
            0x22 => self.cur_x,
            0x23 => self.cur_y,
            0x24 => self.cur_ctrl,
            0x25 => self.cur_lines,
            0x2D => self.tmr as u8,
            0x2E => (self.tmr >> 8) as u8,
            0x2F => (self.tmr >> 16) as u8,
            0x26 => self.vaddr as u8,
            0x27 => (self.vaddr >> 8) as u8,
            0x28 => self.vstep,
            0x29 | 0xC0..=0xFF => {
                // VRAM_DATA, and its $FEC0 alias
                let b = self.vram[self.vaddr as usize];
                self.vadvance();
                b
            }
            0x2A => self.spr_idx,
            0x2C => {
                (self.spr_bank << 4)
                    | (if self.spr_overrun { 0x02 } else { 0 })
                    | (if self.spr_en { 0x01 } else { 0 })
            }
            0x34 | 0x35 | 0x36 | 0x37 => {
                let v = if a < 0x36 { self.pix_x } else { self.pix_y };
                if a & 1 == 0 { v as u8 } else { ((v >> 8) & 7) as u8 }
            }
            _ => 0xFF,
        }
    }

    /// PAL_DATA: the first write holds the red, the second commits the
    /// entry and advances PAL_IDX, as cool8_pal does. With the log on, a
    /// commit is recorded with `t`, the clock of the store that made it,
    /// as clocks since the raster line last changed.
    fn pal_data(&mut self, v: u8, t: Option<u64>) {
        if self.pal_half {
            let rgb = (self.pal_red as u16) << 8 | v as u16;
            self.pal[self.pal_idx as usize] = rgb;
            if let Some(t) = t {
                let rec = (t.saturating_sub(self.raster_at), self.raster,
                           self.pal_idx, rgb);
                if let Some(log) = self.pal_log.as_mut() {
                    log.push(rec);
                }
            }
            self.pal_idx = self.pal_idx.wrapping_add(1);
            self.pal_half = false;
        } else {
            self.pal_red = v & 0x0F;
            self.pal_half = true;
        }
    }

    fn write(&mut self, a: u8, v: u8) {
        match a {
            0x10 => {
                self.mode = v;
                if let Some(p) = PRESETS.get((v & 0x0F) as usize) {
                    self.ctrl = p.0;
                    self.base = p.1;
                    self.map_org = p.1;
                    self.stride = p.2;
                    self.vactive = p.3;
                }
            }
            0x11 => self.ctrl = v & 0x7F,
            0x30 => self.dbase = v,
            0x12 => self.base = (self.base & 0xFF00) | v as u16,
            0x13 => self.base = (self.base & 0x00FF) | (v as u16) << 8,
            0x14 => self.stride = (self.stride & 0xFF00) | v as u16,
            0x15 => self.stride = (self.stride & 0x00FF) | (v as u16) << 8,
            0x16 => self.scrl_x = (self.scrl_x & 0x300) | v as u16,
            0x17 => self.scrl_x = (self.scrl_x & 0xFF) | ((v & 3) as u16) << 8,
            0x18 => self.scrl_y = (self.scrl_y & 0x300) | v as u16,
            0x19 => self.scrl_y = (self.scrl_y & 0xFF) | ((v & 3) as u16) << 8,
            0x1A => self.border = v,
            0x1C => self.rcmp = v,
            0x1D => {
                self.irq_en = v & 0x30;
                self.irq_fl &= !(v & 0x03);
            }
            0x1E => {
                self.pal_idx = v;
                self.pal_half = false;
            }
            0x1F => self.pal_data(v, None),
            0x20 => self.pat_base = (self.pat_base & 0xFF00) | v as u16,
            0x21 => self.pat_base = (self.pat_base & 0x00FF) | (v as u16) << 8,
            0x22 => {
                self.cur_x = v & 0x7F;
                self.blink = 0;
            }
            0x23 => {
                self.cur_y = v & 0x1F;
                self.blink = 0;
            }
            0x24 => self.cur_ctrl = v & 0x1F,
            0x25 => self.cur_lines = v,
            0x26 => self.vaddr = (self.vaddr & 0xFF00) | v as u16,
            0x27 => self.vaddr = (self.vaddr & 0x00FF) | (v as u16) << 8,
            0x28 => self.vstep = v & 0x0F,
            0x29 | 0xC0..=0xFF => {
                self.vram[self.vaddr as usize] = v;
                self.vadvance();
            }
            0x2A => self.spr_idx = v,
            0x2B => {
                if self.spr_idx & 1 != 0 {
                    self.spr[(self.spr_idx - 1) as usize] = self.spr_hold;
                    self.spr[self.spr_idx as usize] = v;
                } else {
                    self.spr_hold = v;
                }
                self.spr_idx = self.spr_idx.wrapping_add(1);
            }
            0x2C => {
                self.spr_en = v & 1 != 0;
                self.spr_bank = (v >> 4) & 0x0F;
                if v & 2 != 0 {
                    self.spr_overrun = false;
                }
            }
            0x34 => self.pix_x = (self.pix_x & 0x700) | v as u16,
            0x35 => self.pix_x = (self.pix_x & 0xFF) | ((v & 7) as u16) << 8,
            0x36 => self.pix_y = (self.pix_y & 0x700) | v as u16,
            0x37 => self.pix_y = (self.pix_y & 0xFF) | ((v & 7) as u16) << 8,
            0x38 => self.plot(v, false),
            0x39 => self.plot(v, true),
            _ => {}
        }
    }

    /// PIX_DATA: one pixel at (X, Y), then X advances. PIX_DATA_Y is the
    /// same store advancing Y instead — the address picks the direction,
    /// so a Bresenham loop holds no mode bit (D91). Both write-only.
    fn plot(&mut self, colour: u8, adv_y: bool) {
        let bpp = 1u32 << self.bpp_log();
        let row = self.base as u32 + self.pix_y as u32 * self.stride as u32;
        let byte = ((row + ((self.pix_x as u32 * bpp) >> 3)) & 0xFFFF) as usize;
        if bpp == 8 {
            self.vram[byte] = colour;
        } else {
            let sub = (self.pix_x as u32 * bpp) & 7;
            let shift = 8 - bpp - sub;
            let mask = (((1u32 << bpp) - 1) << shift) as u8;
            self.vram[byte] = (self.vram[byte] & !mask)
                | (((colour as u32) << shift) as u8 & mask);
        }
        if adv_y {
            self.pix_y = (self.pix_y + 1) & 0x7FF;
        } else {
            self.pix_x = (self.pix_x + 1) & 0x7FF;
        }
    }
}

// ---------------------------------------------------------------- the bus

/// The memory map of docs/04-system.md section 2: the I/O page wins,
/// reads at $F000-$FFFF come from ROM while ROMEN is set, and writes
/// always go to RAM.
pub struct MachineBus {
    pub mem: Box<[u8; 0x10000]>,
    pub rom: [u8; 4096],
    pub romen: bool,
    pub led: u8,
    build_id: u8,
    pub uart: Uart,
    pub kbd: Ps2,
    pub sound: Sound,
    pub video: Video,
    pub flash: Flash,
    /// The clock the instruction being executed began on, and the clocks
    /// a peripheral has held it off so far -- mem_ready low. The CPU's
    /// cycle table knows nothing of wait states, so `Machine::tick` adds
    /// these after the step, and they count for the raster, the profile
    /// and everything else a clock is counted for.
    pub now: u64,
    pub wait: u64,
}

/// Where in an instruction an I/O access falls: the data cycle of
/// `LD`/`ST [abs16]`, the last of its four, the form every streaming
/// loop uses. A read through `[X]` falls a cycle or two earlier, which
/// moves the phase of a read that is not held off and never the rate of
/// one that is.
const ACCESS: u64 = 3;

impl MachineBus {
    fn io_read(&mut self, a: u8) -> u8 {
        match a {
            0x00 => if self.romen { 0x01 } else { 0x00 },
            0x02 => self.build_id,
            0x03 => self.led,
            0x10..=0x3F | 0xC0..=0xFF => self.video.read(a),
            0x40..=0x44 => self.kbd.read(a),
            0x50..=0x51 => 0xFF, // sound is write-only, as the hardware is
            0x70..=0x73 => self.uart.read(a),
            0x88..=0x8F => {
                let (v, held) = self.flash.read(a, self.now + self.wait + ACCESS);
                self.wait += held;
                v
            }
            _ => 0xFF, // as a bus nobody is driving reads
        }
    }

    fn io_write(&mut self, a: u8, v: u8) {
        match a {
            0x00 => self.romen = v & 1 != 0,
            0x03 => self.led = v & 7,
            // ahead of the video block: a palette commit is logged with
            // the clock of the store that made it
            0x1F => self.video.pal_data(v, Some(self.now + self.wait + ACCESS)),
            0x10..=0x3F | 0xC0..=0xFF => self.video.write(a, v),
            0x40..=0x44 => self.kbd.write(a, v),
            0x50..=0x51 => self.sound.write(a, v),
            0x70..=0x73 => self.uart.write(a, v),
            0x88..=0x8F => self.flash.write(a, v, self.now + self.wait + ACCESS),
            _ => {}
        }
    }
}

/// The I/O page: $FF00-$FFF7, the top page less the eight vector bytes.
///
/// Mirrors `io_sel` in `rtl/soc/cool8_soc.v` and must keep mirroring it --
/// the two models are diffed instruction by instruction and a decode that
/// disagreed would show up as a wrong load rather than as a decode bug.
/// The notch at $FFF8 is what leaves RESET/NMI/IRQ/BRK in RAM, so the
/// core is unchanged by the move and the boot still installs them (D67).
#[inline]
fn is_io(addr: u16) -> bool {
    addr >= 0xFF00 && addr < 0xFFF8
}

impl Bus for MachineBus {
    fn read(&mut self, addr: u16) -> u8 {
        if is_io(addr) {
            return self.io_read(addr as u8);
        }
        if self.romen && addr & 0xF000 == 0xF000 {
            return self.rom[(addr & 0x0FFF) as usize];
        }
        self.mem[addr as usize]
    }

    fn write(&mut self, addr: u16, value: u8) {
        if is_io(addr) {
            self.io_write(addr as u8, value);
            return;
        }
        self.mem[addr as usize] = value;
    }
}

// ------------------------------------------------------------ the machine

pub struct Machine {
    pub cpu: Cpu,
    pub bus: MachineBus,
    pub line: u32,
    pub frames: u64,
    snd_owed: u64,
    tick_owed: u64,
    /// Display only, never CPU-visible: parity with cool8vm.Machine is
    /// untouched whether this is attached or not.
    pub renderer: Option<crate::render::Renderer>,
}

impl Machine {
    /// Idle: nothing left to read anywhere, and the CPU sitting in its
    /// keyboard wait.
    ///
    /// **One definition of "ready", asked by everything that needs it.**
    /// The `settle` command uses it for the suites and the window's demo
    /// launcher uses it to know a restart has finished booting — so
    /// "booted" cannot come to mean two different things in two places.
    /// The addresses are the machine's own symbols, handed in by whoever
    /// built the image; nothing here writes one down.
    ///
    /// It is not the cursor. The boot ROM enables the hardware cursor
    /// for its own loading screen (`sw/boot.asm`), so a blinking cursor
    /// means the ROM is alive, not that BASIC is listening.
    pub fn is_idle(&self, idle_pc: u16, irhead: usize, irtail: usize)
                   -> bool {
        self.bus.uart.rx.is_empty()
            && self.bus.kbd.q.is_empty()
            && self.bus.mem[irhead] == self.bus.mem[irtail]
            && self.cpu.pc == idle_pc
    }

    pub fn new(rom: [u8; 4096], flash_image: Option<Vec<u8>>) -> Machine {
        let mut m = Machine {
            cpu: Cpu::new(),
            bus: MachineBus {
                mem: vec![0u8; 0x10000].into_boxed_slice().try_into()
                    .unwrap(),
                rom,
                romen: true,
                led: 0,
                build_id: 0x05,
                uart: Uart::new(),
                kbd: Ps2::new(),
                sound: Sound::new(),
                video: Video::new(),
                flash: Flash::new(flash_image),
                now: 0,
                wait: 0,
            },
            line: 0,
            frames: 0,
            snd_owed: 0,
            tick_owed: 0,
            renderer: None,
        };
        m.cpu.reset(&mut m.bus);
        m
    }

    fn irq(&self) -> bool {
        self.bus.video.irq() || self.bus.kbd.irq()
    }

    /// The bookkeeping that happens when a scanline finishes.
    fn end_line(&mut self) {
        self.snd_owed += CYCLES_PER_LINE;
        let n = self.snd_owed / SND_DIV;
        self.snd_owed %= SND_DIV;
        self.bus.sound.tick(n);

        self.line += 1;
        if self.line >= V_TOTAL {
            self.line = 0;
            self.frames += 1;
        }
        if self.line == 480 {
            // At the start of vertical blanking, as cool8_vga raises
            // frame_start — cool8vm.py's rule, corrected to the RTL's.
            self.bus.video.blink += 1;
            self.bus.video.tmr = (self.bus.video.tmr + 1) & 0xFF_FFFF;
            self.bus.video.irq_fl |= 0x02; // vblank
        }
        self.bus.video.raster = self.line;
        // the clock the line changed on: `tick` has just taken the line's
        // clocks off what it owes
        self.bus.video.raster_at = self.cpu.cycles - self.tick_owed;
        if self.line & 0xFF == self.bus.video.rcmp as u32 {
            self.bus.video.irq_fl |= 0x01; // raster compare
        }
        if self.bus.video.spr_en {
            self.bus.video.scan_sprites(self.line);
        }
        if let Some(r) = self.renderer.as_mut() {
            r.line_event(self.line, &self.bus);
        }
    }

    /// One instruction, with the raster and the interrupts kept in step
    /// with it — cool8vm.Machine.tick, minus the profiling hooks.
    /// Ctrl+Shift+Esc. The hardware restarts its power-on stretch, which
    /// resets every register and leaves memory alone -- RAM, VRAM, the
    /// palette and the font are all still there, and it is BASIC's own
    /// init, once the boot ROM has reloaded it, that wipes user RAM.
    /// So this resets state, not storage.
    pub fn kbd_reset(&mut self) {
        let vram = std::mem::replace(&mut self.bus.video.vram,
                                     vec![0u8; 0x10000].into_boxed_slice()
                                         .try_into().unwrap());
        let pal = self.bus.video.pal;
        let spr = self.bus.video.spr;
        self.bus.video = Video::new();
        self.bus.video.vram = vram;
        self.bus.video.pal = pal;
        self.bus.video.spr = spr;

        self.bus.uart = Uart::new();
        self.bus.kbd = Ps2::new();
        self.bus.sound = Sound::new();
        self.bus.romen = true;
        self.bus.led = 0;
        self.line = 0;
        self.snd_owed = 0;
        self.tick_owed = 0;
        self.cpu.reset(&mut self.bus);
        if let Some(r) = self.renderer.as_mut() {
            *r = crate::render::Renderer::new(r.font);
        }
    }

    pub fn tick(&mut self) {
        // The chords, serviced where they can be: an NMI needs an
        // instruction boundary and a reset needs the whole machine.
        if self.bus.kbd.reset_pending {
            self.bus.kbd.reset_pending = false;
            self.kbd_reset();
            return;
        }
        if self.bus.kbd.warm_pending {
            self.bus.kbd.warm_pending = false;
            self.cpu.pulse_nmi();
        }
        self.cpu.irq_line = self.irq();
        let before = self.cpu.cycles;
        self.bus.now = before;
        self.bus.wait = 0;
        self.cpu.step(&mut self.bus);
        // the clocks a peripheral held an access off are clocks the
        // instruction took, as they are when mem_ready is low
        self.cpu.cycles += self.bus.wait;
        self.tick_owed += self.cpu.cycles - before;
        while self.tick_owed >= CYCLES_PER_LINE {
            self.tick_owed -= CYCLES_PER_LINE;
            self.end_line();
        }
    }
}
