tomcoolpxl/cool8-cpu/sw/interp.asm

; ---------------------------------------------------------------------
; interp.asm -- COOL8 BASIC, executing the program it holds.
;
; The stored program IS the program. There is no compile step and no
; second copy in memory: what LIST shows is what runs.
;
; ## It executes the editor's tokens, not its own
;
; I1 invented a private token space and was poked into memory by hand.
; That was wrong the moment it met a real program: $80 is PRINT in the
; editor's TOKTAB, not LET. This walks the stored form directly --
;
;     lineno (2, LE) | len (1) | tokens (len)
;
; -- with the same token bytes the editor writes. Statement tokens are
; not consecutive in TOKTAB, so dispatch is a table indexed by
; token - $80 with every unimplemented slot pointing at one handler.
;
; ## Recursion is bounded, and the bound is tighter than it looks
;
; The stack is 256 bytes. It is not where an earlier version of this
; comment said: sw/boot.asm:339 sets SP to $0200 and nothing moves it,
; so it grows down through page 1, and page 0 below holds this file's
; state, the A-Z variables and the filesystem's workspace. An overrun
; corrupts those rather than the I/O page.
;
; The expression evaluator is recursive descent, which is cheap here
; because a level costs one return address rather than a frame -- the
; compiler blew its stack because its frames were large, not because it
; recursed.
;
; **Measured, by sim/test_interp.py, rather than assumed: a parenthesis
; costs 4.0 bytes** -- 26 bytes at depth 5, 106 at depth 25. The earlier
; guess of six was pessimistic in the wrong direction, because the real
; problem is not the slope but where it ends up:
;
;   a stored line holds 127 token bytes, so the deepest expression a
;   user can type is about 60 parentheses, and that reaches 246 bytes
;   of the 256.
;
; Ten bytes of margin, measured from an empty stack -- and the editor is
; already 78 bytes down when it calls RUN, so 78 + 246 does not fit.
;
; So the evaluator counts its own nesting and refuses past MAXEXPR with
; ?FORMULA TOO COMPLEX, which is the error C64 BASIC has for exactly
; this reason. 24 levels is about 102 bytes, which leaves the editor its
; 78 and 76 spare. The counter is only touched where prim actually
; recurses, so an expression without a parenthesis pays nothing.
; sim/test_interp.py gates both the slope and the refusal.
; ---------------------------------------------------------------------

; ---- the tokens, generated from TOKTAB by tools/vocab.py.
;
; **These were twenty-five equates written out here**, which is the
; numbering hand-copied into a second place -- and [D65] then called the
; table order frozen on the strength of it. `poe check` fails if the
; generated file is stale, so `sw/toktab.asm` can be reordered or given
; a flags byte by rebuilding ([D68]).
;
; Generating them found four that had a definition and no user:
; `K_FUNC`, `K_RET`, `K_GOTOT` -- and `K_CONST`, which said `$84` long
; after `CONST` was removed and `RUN` took that byte, so anything that
; had reached for it would have matched the wrong keyword.
;
; $95 is INT. It is in toktab as the compiled dialect's type name, so
; the editor tokenises it before the interpreter can look it up, and a
; btab entry spelled "INT" could never be reached -- the token byte
; never spells itself. It is a builtin here instead, dispatched in
; `prim` the way PEEK is. $94 (AS) and $96 (BYTE) are still unused.
        .include "tokens.asm"

; ---- state
;
; The page 0 map and the error codes are in sw/lowram.asm, which the
; including file supplies once. LVAR/LLIM/LBODY/LLINE are adjacent there
; on purpose: they are the innermost FOR's frame and fpush copies them
; as seven consecutive bytes.
;
; The FOR stack is the BBC Micro's shape rather than BBC BASIC (86)'s.
; The BBC gave FOR, REPEAT and GOSUB a stack each and said "Too many
; FORs" when one filled; BBC BASIC (86) merged them onto the processor
; stack. The first is right here, because the processor stack is 256
; bytes shared with everything else and a deeply parenthesised
; expression already reaches 246 of it.

; ---- how deep an expression may nest
;
; Measured at 4.0 bytes of stack a level, so 24 is about 102 bytes. The
; editor is already 78 bytes down when it calls RUN and the whole stack
; is 256, which is where the number comes from: it is a stack budget,
; not a limit on what anyone would write. Ten nested parentheses is
; already beyond what BBC or C64 BASIC will take.
MAXEXPR = 24


; CALLB1 and friends: the convention for calling compiled BASIC.
; Included here rather than by basic.bas because this file is what
; uses them, and sim/test_interp.py assembles this file against a
; stub that never sees the editor.
        .include "call.asm"

; ---------------------------------------------------------------------
; SKIPSP -- Y forward over spaces; R2 = the character it stopped on.
;
; The editor stores the line as it was typed. `sw/basic.bas:1536-1541`
; drops exactly one space after the line number and `tokenise` copies
; every interior space verbatim, so `10 A = 7` is stored as
; A ' ' = ' ' $A4 07 00 -- and LIST gives the indentation back because of
; it. That is BBC BASIC's arrangement and 6502 Microsoft BASIC's alike:
; both keep the spaces and skip them at read time.
;
; Nothing here did, and no gate could see it, because every case in
; sim/test_interp.py builds its token stream by hand with no separators.
; A space reaching `varidx` became variable ($20-'A')*2 = 190, so
; `A = 7` assigned VARS+190 = $00FE -- silently, with ERR still zero.
;
; **Inlined, and that is measured.** As a subroutine it was 17.2 % of
; the expression benchmark, whose lines hold no spaces at all: 6 clocks
; of CALL and 3 of RET to discover there was nothing to do. The test
; itself is 7. This is CHRGOT, and it is inline for the reason CHRGOT
; is.
;
; R2 and not R0, because every operator peek in `eval` runs with the
; value it is accumulating live in R0:R1.
; ---------------------------------------------------------------------
.macro  SKIPSP
        LD   R2,[Y]
        CMP  R2,#$20
        BNE  @go
        CALL skipsp
@go:
.endm

; ---------------------------------------------------------------------
; run -- execute from the first line to the last.
;
; X and Y are both needed for memory access, so the token pointer lives
; in Y and everything else is reloaded. Y is the thing there are most
; accesses to.
; ---------------------------------------------------------------------
irun:
        CLR  R0
        ST   [ERR],R0
        CALL vwipe              ; every variable to zero, and the heap
        CLR  R0
        ST   [FDEPTH],R0        ; and no FOR loop is running
        ST   [DDEPTH],R0        ; nor a DO, which a second RUN must not
                                ;   inherit from the first
        ST   [EDEPTH],R0        ; at statement level, not inside a paren
        ST   [CDEPTH],R0        ; nor a call in progress
        ST   [FSP],R0           ; nor a float operand pending -- see
                                ;   idrct for why this one matters most
        CALL drst               ; the DATA pointer rewinds, unpositioned
        CLR  R0
        ST   [ibreak],R0        ; and nothing is asking it to stop
        ; Every SUB is found now, while LREC is still the program's
        ; first record -- the only moment that address is known without
        ; keeping a pointer to it. A call is then a name lookup rather
        ; than a search of the whole program.
        LD   R0,[LREC]
        PUSH R0
        LD   R0,[LREC+1]
        PUSH R0
        CALL subscan
        POP  R0
        ST   [LREC+1],R0
        POP  R0
        ST   [LREC],R0
        ; NTAB and HEAP are the caller's, like LREC and PEND: the table
        ; starts where the program's code ends and the heap comes down
        ; from MEMTOP, and only the caller knows where those are.
        ; LREC and PEND are set by the caller -- the editor passes the
        ; program it is holding, and the gate passes one it built.
        ;
        ; The FIRST record gets the same bound test every later one
        ; gets, through nextline's own tail. An empty program is
        ; LREC = PEND, and opening record zero anyway executes
        ; whatever is at PROG -- zeros on a harness, the relocating
        ; stub's leftover code on every flash boot.
        LD   R0,[LREC]
        LD   R1,[LREC+1]
        CALL lbound
        BCS  .go
        JMP  h_end              ; empty: a clean stop, nothing ran
.go:    JMP  stmt

; ---------------------------------------------------------------------
; The former editor commands, as statements. Thin token-side parsers
; over the same compiled cores the editor always used -- one
; vocabulary, so a program can SAVE itself, LOAD its sequel, CLS, or
; ask FREE, exactly as on the machines this one descends from. No
; guards and no ILLEGAL DIRECT: DELETE from a running program is legal
; and self-inflicted. The one exception is RUN, direct-only by ruling:
; a program restarting itself would stack a frame per restart.
; ---------------------------------------------------------------------

; rangel -- [lit ['-' [lit]]] into garg+0 and garg+2, presence in R3:
; bit 0 first number, bit 1 dash, bit 2 second number.
rangel: CLR  R3
        SKIPSP
        CMP  R2,#T_LIT
        BNE  .dash
        CALL rlit
        ST   [garg],R0
        ST   [garg+1],R1
        MOV  R3,#1
.dash:  SKIPSP
        CMP  R2,#$2D
        BNE  .out
        INCW Y
        OR   R3,#2
        SKIPSP
        CMP  R2,#T_LIT
        BNE  .out
        CALL rlit
        ST   [garg+2],R0
        ST   [garg+3],R1
        OR   R3,#4
.out:   RET

; rlit -- Y on T_LIT: the two bytes into R0:R1, Y past.
rlit:   INCW Y
        LD   R0,[Y]
        INCW Y
        LD   R1,[Y]
        INCW Y
        RET

esyn:   MOV  R0,#E_SYN
        ST   [ERR],R0
        RET

; **pshab is gone.** It pushed garg as two stacked call arguments, which
; is how a *compiled* SUB took them -- and sw/basic.bas went with [D68],
; so LIST, DELETE and RENUM read garg directly and nothing called it.
; cnext -- where every command handler ends. A compiled core clobbers
; X and Y both, so the walk resumes from LREC, which survives: the
; command was its line's last statement by construction (there is no
; ':'), and nextline already knows how to say "that was the direct
; line" or open the next record with Y rebuilt.
; cnext -- abandon the rest of this line and go to the next.
;
; **Only for statements that moved the program under the interpreter.**
; DELETE, RENUM, a program LOAD and a MERGE all rewrite the records that
; `LREC` is pointing into, so carrying on where we stood would run
; whatever landed there. Everything else -- CLS, FREE, DIR, SAVE, ERA,
; DRIVE, COMPACT, OPENIN, CLOSE, LIST, LOAD..AT -- leaves the program
; alone and ends in `JMP stmt`, which continues on the line and reaches
; the next record by itself when the line runs out.
;
; **That distinction did not matter until [D86].** With no separator
; there was never anything after these statements, so skipping the rest
; of the line was free; the moment `:` became legal, `CLS:PRINT 1`
; silently dropped the PRINT. Thirteen of the seventeen were wrong the
; day the colon landed.
cnext:  CALL nextline
        BCS  .cn
        RET
.cn:    JMP  stmt


; LIST [a[-[b]]]
h_list: CALL rangel
        TST  R3
        BNE  .some
        CLR  R0                 ; bare LIST: everything
        ST   [garg],R0
        ST   [garg+1],R0
        BRA  .all
.some:  CMP  R3,#1
        BNE  .dash
        LD   R0,[garg]          ; one number: that line alone
        ST   [garg+2],R0
        LD   R0,[garg+1]
        ST   [garg+3],R0
        BRA  .go
.dash:  CMP  R3,#7
        BEQ  .go
.all:   MOV  R0,#$FF            ; open-ended: to 32767
        ST   [garg+2],R0
        MOV  R0,#$7F
        ST   [garg+3],R0
.go:    LD   R0,[garg]          ; the bounds, in registers now
        LD   R1,[garg+1]
        LD   R2,[garg+2]
        LD   R3,[garg+3]
        CALL prg_list
        JMP  stmt 

; DELETE a[-[b]]
h_del:  CALL rangel
        BTST R3,#1
        BNE  .r1                ; no first number: nothing to do
        JMP  stmt 
.r1:    BTST R3,#2
        BNE  .r2
        LD   R0,[garg]          ; DELETE n: that line
        ST   [garg+2],R0
        LD   R0,[garg+1]
        ST   [garg+3],R0
        BRA  .go
.r2:    BTST R3,#4
        BNE  .go
        MOV  R0,#$FF            ; DELETE n-: to the end
        ST   [garg+2],R0
        MOV  R0,#$7F
        ST   [garg+3],R0
.go:    LD   R0,[garg]
        LD   R1,[garg+1]
        LD   R2,[garg+2]
        LD   R3,[garg+3]
        CALL prg_del
        JMP  cnext

; RENUM [start [step]]
h_renum:
        MOV  R0,#10
        ST   [garg],R0
        ST   [garg+2],R0
        CLR  R0
        ST   [garg+1],R0
        ST   [garg+3],R0
        SKIPSP
        CMP  R2,#T_LIT
        BNE  .go
        CALL rlit
        ST   [garg],R0
        ST   [garg+1],R1
        SKIPSP
        CMP  R2,#$2C            ; RENUM 100,5 and RENUM 100 5
        BNE  .st
        INCW Y
        SKIPSP
.st:    CMP  R2,#T_LIT
        BNE  .go
        CALL rlit
        ST   [garg+2],R0
        ST   [garg+3],R1
.go:    LD   R0,[garg]          ; start in R0:R1, step in R2
        LD   R1,[garg+1]
        LD   R2,[garg+2]
        CALL prg_renum
        JMP  cnext

h_new:  CALL prg_new              ; the program deleted itself: stop, as
        MOV  R0,#E_DONE         ; the C64 did
        ST   [ERR],R0
        RET

h_free: CALL prg_free           ; the count, then the word for it
        CALL num_putu           ; a size, not a value: 40,448 > 32767
        LDW  X,#MSGFREE
        CALL con_puts
        CALL con_nl
        JMP  stmt 

; vwipe -- A-Z to zero, then the heap and the name table.
;
; RUN's variable clear, split out because CLEAR is exactly that and
; nothing else: the program, and where it is, are untouched.
vwipe:  LDW  X,#VARS
        MOV  R1,#52
.z:     CLR  R0
        ST   [X],R0
        INCW X
        SUB  R1,#1
        BNE  .z
        JMP  vclear

; ---------------------------------------------------------------------
; LOCAL name[,name] -- the caller's values come back on RETURN.
;
; **The same save stack a parameter uses, minus the assignment.** That
; is the whole of it, and the reason it earns its place at forty-odd
; bytes: once values can be saved and put back, a local is a parameter
; nobody passed.
;
; Zeroed after saving, which is BBC's behaviour and the only predictable
; choice -- leaving the caller's value visible would make a local read
; as whatever the caller last had.
; ---------------------------------------------------------------------
h_local:
        LD   R0,[CDEPTH]
        BNE  .live
        JMP  e_call             ; outside a SUB nothing would put it back
.live:  SKIPSP
        CALL varidx
        LD   R2,[ERR]
        BNE  .out
        CMP  R0,#52
        BCC  .loc_res
        CALL nfind
.loc_res:
        MOV  R2,R0
        PUSH R2
        CALL lpush
        POP  R2
        LD   R0,[ERR]
        BNE  .out
        MOV  R0,R2
        PUSH R2
        CALL varaddr
        POP  R2
        CLR  R0
        ST   [X],R0
        INCW X
        ST   [X],R0
        CMP  R2,#52             ; a resident owns only those two
        BLO  .next
        INCW X
        ST   [X],R0
        INCW X
        ST   [X],R0
.next:  SKIPSP
        CMP  R2,#$2C            ; ',' -- another one
        BNE  .done
        INCW Y
        BRA  .live
.done:  JMP  stmt
.out:   RET

h_clear:
        CALL vwipe
        JMP  stmt

; ---------------------------------------------------------------------
; PAUSE n -- n frames, and the break key still works.
;
; Frames rather than milliseconds because `frames` is what the machine
; counts and what TIMER reports, so `PAUSE 60` and `TIMER` measure the
; same second. Sixty a second.
;
; **It polls `ipoll` rather than spinning.** A wait that cannot be
; interrupted is a machine that has hung as far as anyone watching is
; concerned, and this is the one statement whose whole job is to take a
; long time.
;
; The count is on the CPU stack, not in a claim: PAUSE cannot nest and
; the storage region has nothing spare.
; ---------------------------------------------------------------------
h_pause:
        CALL eval
        PUSH R1
        PUSH R0
.next:  LD   R0,[SP+0]
        LD   R1,[SP+1]
        MOV  R2,R0
        OR   R2,R1
        BEQ  .done
        LD   R2,[frames]        ; wait for the counter to tick once
.spin:  PUSH R2                 ; **ipoll returns the break flag in R2**
        CALL ipoll              ;   and this is the frame it is watching
        POP  R2                 ;   -- without the save, the compare
        LD   R0,[ERR]           ;   below was against 0 and PAUSE
                                ;   returned instantly, measured at
                                ;   zero frames waited
        BNE  .done
        LD   R0,[frames]
        CMP  R0,R2
        BEQ  .spin
        LD   R0,[SP+0]
        SUB  R0,#1
        ST   [SP+0],R0
        BCS  .next              ; carry set is no borrow ([D9])
        LD   R0,[SP+1]
        SUB  R0,#1
        ST   [SP+1],R0
        BRA  .next
.done:  ADDW SP,#2
        JMP  stmt

; ---------------------------------------------------------------------
; CONT -- resume the program the break key stopped.
;
; **Validated against the program, not only against a flag.** The record
; lives at a derived address above the name table, which is itself at
; PROGEND -- so editing the program moves it and the bytes read there
; are whatever happened to be in the heap. A saved LREC outside
; $0200..PROGEND cannot be a statement of the program that is loaded
; now, which is the same thing the C64 means by "editing a line loses
; CONT", arrived at from the other end.
; ---------------------------------------------------------------------
h_cont: CALL csave
        MOV  R0,XL
        ADD  R0,#9
        MOV  R1,XH
        MOV  R2,#0
        ADC  R1,R2
        MOV  XL,R0
        MOV  XH,R1
        LD   R0,[X]
        TST  R0
        BEQ  .no
        CLR  R0
        ST   [X],R0             ; one resume per break

        CALL csave
        LD   R0,[X]             ; the record it stopped in
        INCW X
        LD   R1,[X]
        INCW X
        PUSH R1                 ; ...checked before anything is restored
        PUSH R0
        LD   R2,[PROGEND]
        LD   R3,[PROGEND+1]
        SUB  R0,R2
        SBC  R1,R3
        BHS  .stale             ; at or past the end: a different program
        POP  R0
        POP  R1
        ST   [LREC],R0
        ST   [LREC+1],R1

        LD   R0,[X]             ; Y, kept while the depths go back
        INCW X
        PUSH R0
        LD   R0,[X]
        INCW X
        PUSH R0
        LD   R0,[X]
        ST   [FDEPTH],R0
        INCW X
        LD   R0,[X]
        ST   [DDEPTH],R0
        INCW X
        LD   R0,[X]
        ST   [EDEPTH],R0
        INCW X
        LD   R0,[X]
        ST   [CDEPTH],R0
        INCW X
        LD   R0,[X]
        ST   [LDEPTH],R0
        POP  R0
        MOV  YH,R0
        POP  R0
        MOV  YL,R0
        JMP  stmt

        ; **Not ?CALL, which means "no such SUB".** Four ways to get
        ; here and all of them are the same fact: there is no break to
        ; go back to. Nothing was stopped; the program was edited, so
        ; the saved record names a statement that is not there any more;
        ; NEW or RUN emptied it; or this break has already been
        ; continued once.
.stale: POP  R0
        POP  R1
.no:    MOV  R0,#E_CONT
        ST   [ERR],R0
        RET

h_cls:  CALL con_cls
        JMP  stmt 

; COLOR fg[, bg] -- the pen, which is CATTR: bg in the high nibble, fg
; in the low.
;
; **The background is optional and that is the whole design.** Changing
; ink is the common case by a wide margin, and a program that had to
; name the paper every time would either repeat itself or keep its own
; copy of it -- so `COLOR 14` reads the byte back and keeps the nibble
; it is not being asked about. Both are masked to 0-15, so no value can
; reach into the other's nibble.
;
; con_fill reads the same byte, so CLS and a scroll paint in the current
; paper rather than reverting to grey.
; CURSOR on[, rate] -- CUR_CTRL: bit 0 enables, bits 4:3 pick the
; blink.
;
; **Nothing here blinks anything.** `blink_r` counts frames in
; cool8_vregs.v and the rate selects which of its bits to test, so
; rate 0 is 8 frames a phase, 1 is 16, 2 is 32 and 3 short-circuits
; to solid. The phase also restarts whenever the cursor moves, which
; is what keeps it visible while a key is held -- none of which
; software could do as well per frame.
;
; A warm restart puts it back: `con_geom` writes $11 whatever a
; program left, so a demo cannot strand a machine with no cursor.
h_cursor:
        CALL eval               ; 0 off, 1 on
        AND  R0,#$01
        PUSH R0
        LD   R2,[Y]             ; a rate as well?
        CMP  R2,#$2C
        BEQ  .rate
        MOV  R0,#2              ; no: 32 frames a phase, the machine's
        BRA  .set
.rate:  INCW Y
        CALL eval
        AND  R0,#$03
.set:   ADD  R0,R0              ; the rate lives in bits 4:3
        ADD  R0,R0
        ADD  R0,R0
        POP  R2
        OR   R0,R2
        ST   [CUR_CTRL],R0
        JMP  stmt

h_color:
        CALL eval               ; the ink
        AND  R0,#$0F
        PUSH R0
        ; **The comma is read straight off Y, as h_poke reads its
        ; own.** `SKIPSP` here saw no comma at all and every paper
        ; silently became 0; the two-argument idiom in this file is
        ; `INCW Y` over a comma the evaluator left Y sitting on.
        LD   R2,[Y]
        CMP  R2,#$2C            ; ',' -- a paper as well?
        BEQ  .paper
        LD   R0,[CATTR]         ; no: keep the one already set
        AND  R0,#$F0
        BRA  .set
.paper: INCW Y
        CALL eval
        AND  R0,#$0F
        ; **Four adds, not MUL.** `MUL R0,R1` puts its product in
        ; X and leaves both registers alone -- `nentry` says so in
        ; its own comment -- so multiplying here left the paper
        ; exactly where it started and every one came out 0.
        ADD  R0,R0              ; into the high nibble
        ADD  R0,R0
        ADD  R0,R0
        ADD  R0,R0
.set:   POP  R2
        OR   R0,R2
        ST   [CATTR],R0
        JMP  stmt

h_run:  LD   R0,[LREC+1]        ; direct only: a program restarting
        CMP  R0,#>DIRBUF        ;   itself stacks a frame per restart
        BEQ  .ok
        JMP  esyn
.ok:
        CALL main_pre           ; where the program and the heap are
        CALL irun
        CALL main_err           ; ?WHAT IN nn, if it set ERR
        MOV  R0,#E_DONE
        ST   [ERR],R0
        RET

; idrct -- the staged record at DIRBUF, run with the machine's state
; LEFT ALONE. This is irun minus the variable clear: A-Z, arrays and
; the heap survive from the last run, which is what a direct PRINT A
; after a break is FOR -- the C64's direct mode with the BBC's manners.
; The caller (dodirect) has run the same preflight RUN gets, so a
; direct CALL reaches assembled ASM blocks and scanned SUB names, and
; PEND is progend: a direct GOTO lands in the program and simply keeps
; walking -- resume falls out of the record machinery.
idrct:  CLR  R0
        ST   [FDEPTH],R0        ; statement level, fresh
        ST   [DDEPTH],R0
        ST   [EDEPTH],R0
        ST   [CDEPTH],R0
        ST   [FSP],R0           ; **not optional.** fsav refuses past
                                ;   FSDEEP without pushing, and its
                                ;   caller pops regardless, so one
                                ;   over-nested expression leaves FSP
                                ;   five below zero -- and a byte
                                ;   underflows to 251, past every
                                ;   depth test. Every expression for
                                ;   the rest of the session then failed
                                ;   ?COMPLEX and returned rubbish:
                                ;   2 + 2 printed 1538. Resetting here
                                ;   bounds it to the statement.
        CALL drst               ; READ starts at the first DATA
        CLR  R0
        ST   [ibreak],R0
        LD   R0,[LREC]          ; subscan walks the program (LREC is
        PUSH R0                 ;   PROG here) exactly as irun's does
        LD   R0,[LREC+1]
        PUSH R0
        CALL subscan
        POP  R0
        POP  R0
        MOV  R0,#<DIRBUF        ; then the record is the staged one
        ST   [LREC],R0
        MOV  R0,#>DIRBUF
        ST   [LREC+1],R0
        CALL openline
        JMP  stmt

; openline -- LREC points at a record; put Y on its first token.
;
; There is nothing else to do. The line ends with a zero byte, so the
; statement loop asks "end of line?" with one load rather than a 16-bit
; compare against an end pointer that had to be maintained here.
openline:
        LD   R0,[LREC]
        MOV  YL,R0
        LD   R0,[LREC+1]
        MOV  YH,R0
        INCW Y
        INCW Y
        INCW Y
        RET

; nextline -- LREC = the record after this one. Carry clear when the
; program has run out.
;
; A record on DIRBUF's page is the staged direct line: it has no next
; record by construction, and its address is the whole mark -- the BBC's
; immediate-mode test was address-based too, and for the same reason:
; nothing else can be there. Program records live from $0200 up to
; progend, which cannot reach USERTOP, and the system storage region
; starts above USERTOP.
;
; **This was `CMP R0,#$FF`**, from when DIRBUF was at $FF88 in the old
; workspace page. When the I/O page took that page and DIRBUF moved to
; the storage region ([D67]), the constant did not move with it, so
; every direct line walked off its own record into the heap: RUN printed
; nothing and `MODE 4` never reached the hardware. The high byte is
; taken from DIRBUF now, so the mark follows the buffer.
nextline:
        LD   R0,[LREC+1]
        CMP  R0,#>DIRBUF
        BNE  .adv
        CLC
        RET
.adv:   LD   R0,[LREC]          ; this record + 4 + its length
        LD   R1,[LREC+1]
        MOV  XL,R0
        MOV  XH,R1
        INCW X
        INCW X
        LD   R2,[X]
        ADD  R0,#4
        MOV  R3,#0
        ADC  R1,R3
        ADD  R0,R2
        ADC  R1,R3
        ST   [LREC],R0
        ST   [LREC+1],R1
; lbound -- R0:R1 holds LREC's value: open it if it is short of PEND
; and return with carry set, or carry clear for "the program is over".
; irun enters here for record zero, nextline falls through for the rest.
lbound: LD   R2,[PEND]
        LD   R3,[PEND+1]
        SUB  R0,R2              ; LREC - progend
        SBC  R1,R3
        BLT  .more
        CLC
        RET
.more:  CALL openline
        SEC
        RET

; ---------------------------------------------------------------------
; The statement loop.
; ---------------------------------------------------------------------
stmt:
        LD   R0,[ERR]
        TST  R0
        BEQ  .live
        RET
.live:
        ; Every statement starts with an empty accumulator. Doing it
        ; here rather than in each handler is what makes a string
        ; sub-expression safe to leave alone: `(A$ + B$)` has to go on
        ; appending, so nothing below statement level may reset.
        CLR  R2
        ST   [SLEN],R2
        ST   [STYPE],R2
        SKIPSP             ; end of line? one load, past the spaces.
        TST  R2
        BNE  .more
        ; **Ask about the record that just ran, before overwriting the
        ; pointer to it.** This tested `R1` -- the high byte of the
        ; *next* record -- after LREC had already been advanced, so it
        ; only answered correctly while a direct line began and ended on
        ; the same page. DIRBUF sits at $B5FA, six bytes below the
        ; boundary, so `PRINT 6` ends at $B602 and the next record is on
        ; page $B6: the test compared $B6 against $B5, said "not the
        ; direct line", and walked on. LREC then marched up through
        ; memory four bytes at a time reading zeros as empty records
        ; until it reached the image at $BB97 and tried to run it --
        ; which is where the `?SYNTAX` after every direct statement came
        ; from. The answer had already been printed, so the machine
        ; looked like it was working and complaining anyway.
        ;
        ; Still the page and not the whole address: `nextline` beside
        ; this makes the identical test, program records cannot reach
        ; $B5xx, and comparing both bytes was built and measured at
        ; **seven bytes more** for a robustness against DIRBUF moving to
        ; a shared page -- which `tools/memmap.py --check` would refuse
        ; anyway. Three bytes buys the fix; ten buys the fix and a
        ; second opinion.
        LD   R0,[LREC+1]
        CMP  R0,#>DIRBUF
        BEQ  .stop              ; the staged direct line has no next

        ; Y is sitting on the terminator, so the next record begins at
        ; Y+1. There is no address to compute: nextline was 18 % of the
        ; run doing arithmetic the position already answered.
        INCW Y
        MOV  R0,YL
        ST   [LREC],R0
        MOV  R1,YH
        ST   [LREC+1],R1
        LD   R2,[PEND]
        LD   R3,[PEND+1]
        SUB  R0,R2
        SBC  R1,R3
        BLT  .open
.stop:  RET                     ; past the last line: stop
.open:  CALL openline
        JMP  stmt
.more:
        ; **The $80 split first, because every statement needs it.** A
        ; token dispatches; anything below is a name, a separator or a
        ; comment. This used to test the apostrophe -- the rarest of the
        ; three -- ahead of the split that decides all of them, so every
        ; token-led statement paid for a case it could not be.
        ;
        ; Putting the split first is what makes `:` free on that path
        ; rather than a third test in front of it.
        CMP  R2,#$80
        BCS  .tok
        ; **`:` is a separator, and it is all it is.** This loop already
        ; ran statement after statement to the end of a line -- a handler
        ; ends in `JMP stmt` and only a zero byte sends it to the next
        ; record -- so `A=5 PRINT A` has always worked and nobody could
        ; have guessed it. What did not work was the colon every BASIC
        ; programmer types, because it is below $80 and fell through to
        ; `h_let`, which read it as a variable name.
        ;
        ; Punctuation, not a token: stored as itself, costing no slot in
        ; TOKTAB, and LIST gives it back for nothing.
        CMP  R2,#$3A            ; ':'
        BEQ  .sep
        ; An apostrophe comment is stored as itself -- it is punctuation,
        ; so it gets no token. Sending it to h_rem is what keeps
        ; `' like this` from being parsed as a variable named `'`.
        CMP  R2,#$27
        BEQ  .rem
        JMP  h_let              ; a name: an assignment
.sep:   INCW Y
        BRA  stmt
.rem:   JMP  h_rem
.tok:   INCW Y
        MOV  R0,R2
        SUB  R0,#$80
        CMP  R0,#NTOK
        BCS  bad
        SHL  R0
        LDW  X,#sttab
        LD   R1,[X+R0]
        ADD  R0,#1
        LD   R2,[X+R0]
        MOV  XL,R1
        MOV  XH,R2
        JMP  [X]

bad:    MOV  R0,#E_SYN
        ST   [ERR],R0
        RET

; ---------------------------------------------------------------------
; REM, and the apostrophe stmt sends here: a comment.
;
; The tokeniser stores the text verbatim after the marker, so there is
; nothing here to interpret -- walk to the record's terminator and let
; the statement loop do what it already does with the end of a line.
;
; **Raw bytes, not skiptok.** A comment may contain a quote, and
; skiptok would take it for the start of a string and run past the
; terminator looking for the close.
; ---------------------------------------------------------------------
h_rem:  LD   R2,[Y]
        TST  R2
        BEQ  .out
        INCW Y
        BRA  h_rem
.out:   JMP  stmt

; END, and `END SUB` which is not the same statement at all.
;
; **Falling into `END SUB` used to stop the program.** A SUB returned
; only through `RETURN`; `END SUB` was a marker `h_sub` scanned for when
; stepping over a definition, and if execution ever reached one, `END`
; ran and set E_DONE. A sub whose last statement was not RETURN ended
; the whole program, silently and with the right answer already
; printed -- the shape of fault this file keeps producing.
h_end:  SKIPSP
        CMP  R2,#K_SUB
        BNE  .stop
        INCW Y                  ; over SUB: this is a return, not a stop
        JMP  h_ret
.stop:  MOV  R0,#E_DONE         ; a clean stop, not an error
        ST   [ERR],R0
        RET

; ---------------------------------------------------------------------
; v = <expression>
;
; A name is one letter here: A-Z are resident, which is BBC BASIC's
; A%-Z% and is why a loop counter costs nothing to find.
; ---------------------------------------------------------------------
; ---------------------------------------------------------------------
; MID$(a$, start [, n]) = expr -- the one assignment target that is not
; a variable or an array element.
;
; **A special case here because it is a special case in the language.**
; Every BASIC that has this implements it apart from ordinary assignment,
; because the left-hand side is a function call in every other context.
; The C64 has it; BBC BASIC does not.
;
; It **overwrites in place and never changes the length**, which is the
; whole reason it exists: no allocation, no garbage, and a fixed-width
; field can be rewritten as often as a program likes. Everything is
; clamped to what is there -- past the end writes nothing, too long a
; replacement is truncated -- so it cannot extend a string or run off
; the end of one.
; ---------------------------------------------------------------------

midnam: .byte "m","i","d","$","("

; ismid -- is the statement `MID$(`? C set and Y past it if so, Y
; untouched if not.
;
; Folded with OR $20, which turns a letter lower case and leaves `$` and
; `(` alone -- both already have bit 5 set. So this reads `mid$(` and
; `MID$(` alike without the tokeniser having to fold identifiers, which
; it does not: a name that is not a keyword is copied verbatim.
ismid:  PUSHW Y
        LDW  X,#midnam
        MOV  R3,#5
.mc:    LD   R0,[X]
        INCW X
        LD   R1,[Y]
        INCW Y
        OR   R1,#$20
        CMP  R0,R1
        BNE  .no
        SUB  R3,#1
        BNE  .mc
        POPW X                  ; matched: drop the saved Y, keep the walk
        SEC
        RET
.no:    POPW Y
        CLC
        RET

h_midst:
        CALL varidx             ; the target, X on its descriptor
        CMP  R0,#52
        BCS  .long
        JMP  esyn               ; A-Z is never a string, so nor is this
.long:  PUSHW X
        CALL isstr
        BCC  .str
        POPW X
        JMP  esyn
.str:   CALL sopen              ; ','
        CALL eval               ; where to start, counting from one
        PUSH R0
        ; **Two arguments means "to the end"**, the same shape `smid`
        ; uses for reading, and for the same reason: the count is asked
        ; for only if a ',' follows, and everything below clamps.
        SKIPSP
        CMP  R2,#$29            ; ')'
        BNE  .three
        INCW Y
        MOV  R0,#$FF
        BRA  .have
.three: CALL earg               ; , n )
.have:  PUSH R0
        SKIPSP
        INCW Y                  ; the '='
        CALL eval               ; the replacement, into the accumulator
        POP  R3                 ; how many
        POP  R2                 ; where
        POPW X                  ; the descriptor
        LD   R0,[ERR]
        BEQ  .go
        JMP  stmt
.go:    PUSHW Y                 ; Y is the token pointer; borrow it

        TST  R2                 ; one-based, and 0 reads as 1
        BNE  .s1
        MOV  R2,#1
.s1:    SUB  R2,#1              ; ...so this is the offset

        MOV  R1,#2
        LD   R1,[X+R1]          ; what the variable actually holds
        CMP  R2,R1
        BCC  .in
        BRA  .done              ; start past the end: nothing to write
.in:    SUB  R1,R2              ; room from there to the end
        CMP  R3,R1
        BCC  .n1
        MOV  R3,R1
.n1:    LD   R0,[SLEN]          ; and no more than there is to say
        CMP  R3,R0
        BCC  .n2
        MOV  R3,R0
.n2:    TST  R3
        BEQ  .done

        LD   R0,[X]             ; the heap bytes, at the offset
        INCW X
        LD   R1,[X]
        MOV  XL,R0
        MOV  XH,R1
        ADDW X,R2
        LD   R0,[SACC]
        MOV  YL,R0
        LD   R0,[SACC+1]
        MOV  YH,R0
.cp:    LD   R0,[Y+]
        ST   [X],R0
        INCW X
        SUB  R3,#1
        BNE  .cp
.done:  POPW Y
        JMP  stmt               ; `stmt` empties the accumulator, and a
                                ;   handler that does it too is six bytes
                                ;   saying what the loop already said

h_let:
        ; **One byte before anything else.** This is the hottest
        ; statement in the language -- `A = A + 1` inside a loop is here
        ; every iteration -- and MID$ on the left is rare, so the first
        ; character answers it and only a name beginning with M pays for
        ; the rest. Calling `ismid` unconditionally cost thirteen
        ; instructions per assignment to say no, which is the shape
        ; `nextline` was already caught in.
        LD   R0,[Y]
        OR   R0,#$20
        CMP  R0,#$6D            ; 'm', folded
        BNE  .let
        CALL ismid              ; MID$(a$,s[,n]) = ... ?
        BCS  h_midst
.let:   CALL varidx             ; R0 = the handle, Y past the name
        CMP  R0,#52
        BCC  .notstr            ; resident A-Z is never a string
        ; The subscript first, for the reason `prim` gives: the suffix
        ; test fired ahead of it, so `A$(3) = "x"` assigned the scalar
        ; A$ and left the subscript behind.
        SKIPSP
        CMP  R2,#$28            ; '('
        BEQ  .notstr
        CALL nfind              ; a long scalar: ensure in NTAB
        PUSH R0
        CALL isflt
        POP  R0
        BCC  .flt
        PUSH R0
        CALL isstr
        POP  R0
        BCS  .notstr
        JMP  h_lets             ; X is on its descriptor already
.flt:   JMP  h_letf
.notstr:
        SKIPSP
        CMP  R2,#$28            ; '(' -- a subscripted assignment
        BNE  .scalar
        JMP  h_leta             ; it lives at the end, out of branch reach
.scalar:
        ST   [TVAR],R0
        SKIPSP
        INCW Y                  ; the '='
        CALL evali              ; [D88] a float crosses here, flooring
        PUSH R1
        PUSH R0
        LD   R0,[TVAR]
        CALL varaddr
        POP  R0
        POP  R1
        ST   [X],R0
        INCW X
        ST   [X],R1
        JMP  stmt

; ---------------------------------------------------------------------
; Variables, and the two kinds of them.
;
; `varidx` returns a one-byte **handle**, not an address, and the split
; is the whole point:
;
;   0..50 even    A-Z, resident, the value at VARS + handle
;   52 + slot     a long name, the value in the name table's entry
;
; A handle rather than an address because `FOR` caches its variable in
; LVAR, one byte of a seven-byte frame that `fpush` copies whole; making
; it two would take FORSTK to 64 bytes and it has 56. It also keeps the
; resident path exactly what it was -- one load, one subtract, one shift
; -- which is most of the speed in a loop and the reason A-Z exist.
;
; What is new is that a name is now *scanned* rather than assumed to be
; one character. That closes a real fault as well as adding long names:
; any token byte below $80 that was not `(`, `-` or $A4 used to be taken
; for a variable, so a stray quote indexed VARS+194 = $0102 and `h_let`
; wrote there.
; ---------------------------------------------------------------------
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
