tomcoolpxl/cool8-cpu/(commit log)

2026-08-02 Add documentation for the Cool8 machine, board details, roadmap, and opcode table
    - Created `04-system.md` detailing the Cool8 machine architecture, memory map, boot sequence, I/O page, video specifications, and interrupt sources.
    - Added `05-board.md` outlining the iCESugar v1.5 board resources, pin assignments, external circuits for PS/2 and audio output, and a bill of materials.
    - Introduced `06-roadmap.md` to outline project milestones from specification to TinyTapeout, including tasks for each milestone.
    - Implemented `tools/opcodes.py` to generate and validate the opcode table for the Cool8 architecture, ensuring no collisions or gaps in the primary instruction set.
    [opcodes.py]
2026-08-02 Add loader documentation and update system and board details in README
    - Introduced a new document for the loader wire protocol.
    - Updated README with hardware loader capabilities and USB serial details.
    - Enhanced board documentation to clarify SPI flash usage post-configuration.
    - Revised roadmap to emphasize the importance of the hardware loader.
2026-08-02 Add 8x8 multiply instruction and related architecture updates
    - Introduced `MUL Rd,Rs` instruction for unsigned 16-bit multiplication, storing the result in register X.
    - Updated decision document (01-decisions.md) to include rationale for the multiply instruction and its implementation details.
    - Revised ISA documentation (02-isa.md) to define the new `MUL` instruction and its operation.
    - Enhanced microarchitecture documentation (03-microarchitecture.md) to describe the implementation of the multiply sequencer using existing hardware.
    - Added NMI break button functionality in system documentation (04-system.md) for debugging purposes.
    - Updated board pinout documentation (05-board.md) to r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
2026-08-02 Add COOL8 standard library and assembler
    - Introduced `lib.asm` containing standard routines for the COOL8 architecture, including memory manipulation, string handling, and arithmetic operations.
    - Added binary output for the library as `lib.bin`.
    - Implemented `gfx.bin` for graphical data.
    - Created `cool8asm.py`, a two-pass assembler that processes assembly code, generates binary output, and supports macros and expressions.
    - Enhanced operand normalization and instruction encoding to ensure compatibility with the disassembler.
2026-08-03 Enhance COOL8 architecture: add ADDW X|Y,#imm16 instruction, update documentation, and refine assembler functionality
2026-08-03 M3: the CPU in Verilog, co-simulated against the emulator
    cool8_core in Verilog-2001, plus the ASIC pad wrapper brought forward
    from M8 because LibreLane needs a tt_um_ top to harden and a core-only
    area figure would not be the figure that matters.
    Verification. Every one of the 511 encodings runs through a generated
    probe that sets the whole architectural state, executes one instruction
    and converges on a common jump, at zero, one and randomised wait states.
    Twelve randomised streams of 4000 instructions on top of that, the full
    64 KB memory image compared as well as the register trace, all 65536
    multiply operand pairs, and the same 511 encodings again through the
    three-phase bus against b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
2026-08-03 M4: settle the clock by measurement, start the SoC
    The CPU does not close at 25.125 MHz on iCE40UP5K. Measured with core,
    two SPRAM and the PLL: 1040 LCs and 16.90 MHz, the critical path being
    read data from SPRAM through instruction decode to the next address.
    Two attempts to break it elsewhere both failed and are recorded in D26
    because the failures bound the problem: adv as a flip-flop enable gave
    17.24 MHz for 109 more LCs, and registering the address in the memory
    controller gave 16.20 MHz. The floor is the decode cone at ~35 ns, and
    only splitting fetch and decode across two cycles moves it.
    None of which is necessary, because only the VGA pins need 25.175 MHz.
    Section 4.1's one-clock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
    [cool8_loader.v, cool8_uart.v]
2026-08-03 Add testbenches for cool8 SPRAM and loader functionality
    - Introduced cool8_spram_cpu_tb.v to test the CPU with real SPRAM, ensuring proper memory interaction and instruction execution.
    - Added cool8_spram_tb.v to validate the SPRAM controller against a byte array, checking address mapping and handshake protocols.
    - Created test_loader.py to simulate the cool8_loader and UART communication, allowing for baud rate and memory wait state variations.
    - Implemented test_spram.py to run comprehensive tests on the SPRAM controller, including directed cases and random access patterns.
2026-08-03 Add boot ROM and testbench for COOL8 architecture
    - Implemented the boot ROM in `sw/boot.asm`, initializing the system and setting up the RAM and vectors.
    - Created `tools/mkrom.py` to assemble the boot ROM into a hex image for simulation.
    - Developed `sim/tb/cool8_rom_tb.v` to verify the ROM image against the expected output.
    - Added `sim/tb/cool8_mem_tb.v` to test the memory overlay functionality and ensure correct read/write behavior.
    - Introduced `sim/test_boot.py` to automate the testing of the ROM and memory overlay, including RTL and netlist checks.
    [boot.asm, cool8_boot_tb.v, cool8_mem.v, cool8_mem_tb.v, cool8_rom.v, cool8_rom_tb.v, cool8_spram.v, mkrom.py]
2026-08-03 Add testbench and Python script for cool8 SoC
    - Introduced `cool8_soc_tb.v`, a comprehensive testbench for the cool8 SoC, validating the I/O page decode and ensuring proper interaction with the underlying memory and peripherals.
    - Created `test_soc.py`, a Python script to automate the testing process, including assembling test programs and running simulations with detailed reporting.
    - The testbench includes checks for register reads/writes, memory access, UART functionality, and proper handling of edge cases.
    - The Python script orchestrates the test execution, manages program assembly, and synthesizes the SoC design, providing a streamlined testing workflow.
2026-08-03 Add board wrapper and testbench for cool8 SoC; implement bitstream generation
2026-08-03 Implement loader functionality and testing framework for COOL8 hardware
    - Added `tools/cool8load.py` for host-side loader operations including commands for loading, dumping, and interacting with the COOL8 hardware.
    - Introduced `sim/test_load.py` to validate the loader's wire format against the RTL and command loops against a simulated board.
    - Created `sim/tb/cool8_wire_tb.v` to simulate the serial port communication, allowing for testing of the host tool against the machine.
    - Updated documentation in `docs/07-loader.md` to reflect new usage patterns and important operational rules for the loader.
    - Enhanced `sim/README.md` to include references to new test files and their purposes.
2026-08-05 Add testbenches for cool8_vram and cool8_vport
    - Implemented cool8_vram_tb.v to test the video memory and its arbiter against a reference word array, ensuring correct address mapping, nibble write masks, and arbitration logic.
    - Created test_vport.py to validate the indirect VRAM port functionality, including contention scenarios and various read/write operations.
    - Introduced test_vram.py to verify the video memory's behavior under directed cases, arbitration order, throughput, and concurrent access patterns.
    [cool8_vport.v, cool8_vport_tb.v, cool8_vram.v, cool8_vram_tb.v]
2026-08-06 Add COOL8 monitor implementation in assembly language
    This commit introduces the COOL8 monitor, an assembly language program that serves as the primary interface for the COOL8 machine. The monitor allows users to interact with the system through commands for dumping memory, entering bytes, unassembling instructions, executing code, and loading from SPI flash. It supports input from both a serial port and a PS/2 keyboard, providing a versatile environment for system management and debugging. The monitor operates directly from ROM, utilizing a small page of RAM for variables, and includes a command loop for processing user input.
2026-08-06 Refactor sprite handling and memory management in cool8 architecture
    - Updated cool8_pixel to use a shared palette bank for sprites, reducing memory usage and simplifying sprite data structure.
    - Modified cool8_pixport to remove unnecessary read capabilities, optimizing write operations and reducing complexity.
    - Enhanced cool8_soc to ensure proper write handling with new io_wreq signal, preventing double writes during stalled cycles.
    - Adjusted cool8_sprite to accommodate the new palette bank structure and ensure correct sprite rendering.
    - Improved cool8_video to reflect changes in sprite data handling and memory management.
    - Refined cool8_vport to align with the new write request handlin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
    [cool8_core.v, cool8_fetch.v, cool8_mon_tb.v, cool8_pixel.v, cool8_pixport.v, cool8_soc.v, cool8_sprite.v, cool8_uart.v]
2026-08-06 Add break button support and loader configuration options in cool8 architecture
2026-08-06 Refactor audio and loader functionality; update documentation
    - Updated the microarchitecture documentation to reflect changes in the SoC's resource usage, including LUT4 and flip-flop counts.
    - Changed references from "audio" to "sound" in system documentation, clarifying the sound engine's capabilities and structure.
    - Revised the loader section to indicate it is now a build option, with implications for the system's operation.
    - Enhanced board documentation to specify the audio output as mono and detail the DAC implementation using RC filters.
    - Adjusted the roadmap to reflect completed tasks for M7, including sound capabilities and flash writing.
    - Modified the top-level module to improv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
    [cool8_top.v]
2026-08-07 Add COOL8 BASIC one-pass native-code compiler
    This commit introduces a new Python script, cool8bas.py, which implements a one-pass compiler for a structured BASIC language targeting the COOL8 machine code. The compiler supports basic constructs such as variable declarations, arithmetic operations, conditional statements, loops, and subroutine calls. It generates assembly code directly without an intermediate representation, optimizing for speed and efficiency. The script includes a lexer, parser, and code generator, along with error handling for syntax issues.
    [cool8bas.py]
2026-08-07 Add COOL8 BASIC demo and runtime library
    - Introduced `demo.bas`, a COOL8 BASIC implementation of the assembly demo, featuring a tiled background, bouncing sprites, and sound.
    - Added `lib.bas`, a runtime library for COOL8 BASIC providing graphics, sound, and utility functions.
    - Created `test_lib.py` to benchmark the performance of the assembly and BASIC versions of the demo.
    - Implemented `libtest.bas` for testing basic library functions including modulo and random number generation.
2026-08-07 S1: COOL8 BASIC screen editor, the C64 way
    The screen is the buffer. Type anywhere, press Return anywhere on a row,
    and the machine re-reads that whole row and processes it: a row starting
    with a number is stored, one that does not is executed. Re-entering an
    existing number replaces that line.
    sw/basic.bas -- 7,162 bytes at $C000, 7.0 KB of the 15.5 KB resident
    budget. Lines are stored tokenised (lineno, len, tokens) in ascending
    order, so len makes skipping O(1) and insertion is a memmove.
    LIST, NEW, FREE, RENUMBER, DELETE, CLS.
    sim/test_basic.py types at it over the UART -- nothing is poked into
    memory -- and reads the screen back through the machine's own VID_BASE
    and VID_STRIDE. It re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
    [boot.asm, cool8_boot_tb.v, cool8_mon_tb.v, cool8bas.py, monitor.asm]
2026-08-07 S3: the code emitter, byte-identical to the assembler
    sw/emit.bas is the compiler's back end, running on the machine.
    sim/test_emit.py drives it with a program written twice -- once as calls
    into the emitter, once as text for tools/cool8asm.py -- and requires the
    bytes to match. A single source could only ever agree with itself; the
    second copy is the test. It earned that immediately, catching a
    transcribed LD where the driver said ST.
    The encodings turn out to be arithmetic, not a table:
    ALU Rd,#imm8 op*4 + rd
    ALU Rd,Rs $80 + op*16 + rd*4 + rs
    Bcc rel8 $70 + cc
    LD/ST Rd,[X|Y] $40 + st*8 + rd*2 + isy
    LD/ST Rd,[X|Y+d8] $50 + st*8 + rd*2 + isy
    L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
2026-08-07 S4b: symbols and expressions, byte-identical to the cross-compiler
    sw/comp.bas compiles DIM, CONST and assignment with the arithmetic
    between them, straight to bytes. sim/test_comp.py compiles the same
    program with tools/cool8bas.py and requires the code to match byte for
    byte and the variables to land at the same addresses.
    code and data together are 187 bytes, the reference 187 ok
    and the 182 bytes of code are identical ok
    the first variable is at $60B6, as the assembler put it ok
    There is a small expression tree here, where the rest of the compiler is
    one pass. It has to be: the code for `a + b` depends on whether b is a
    leaf, and every operand's width depend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
2026-08-07 S4c: control flow, byte-identical to the cross-compiler
    IF/ELSE/ELSEIF, single-line IF, DO with WHILE or UNTIL at either end,
    EXIT DO, FOR/NEXT. 562 bytes of code from a 50-line program, identical
    to what tools/cool8bas.py produces, with the variables at the same
    addresses.
    Every conditional branch goes long -- the short branch inverted, jumping
    over a JMP -- because one pass cannot see how far forward a block runs.
    The inverse of a condition is its low bit flipped: BLT/BGE, BEQ/BNE and
    BCC/BCS are adjacent encodings, so there is no table.
    a > b compiles as b < a and a <= b as b >= a. A 16-bit SUB leaves Z from
    the high byte alone, so BGT and BLE would be wrong whenever the low
    bytes diffe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
    [comp.bas]
2026-08-07 S4d(1): temporaries and the frame, byte-identical
    A right operand that is not a leaf now spills. 772 bytes of code from a
    58-line program, identical to tools/cool8bas.py, variables at the same
    ## The silent pass
    The frame prologue is ADDW SP,#-total, and the cross-compiler deletes
    the line entirely when the total is zero. This emitter writes bytes, so
    it cannot delete one it has written, and it cannot know the total until
    the body has been read.
    So the body is compiled twice. The first time equiet is set: cp advances
    exactly as it will the second time -- no instruction's length depends on
    a label's value, because every forward branch is emitted long -- but
    nothing is written an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
2026-08-07 S4d(3): arrays, byte-identical
    DIM a(n), element reads and stores, and DIM ... AT for an array laid
    over an address rather than allocated -- the screen, the I/O page.
    1,325 bytes of code from an 84-line program, identical to the
    cross-compiler's.
    ## The side table
    The backpatch chain cannot carry `base + off`: the operand field holds
    the link to the previous site waiting on the label, and there is nowhere
    left to put an addend. Array element addresses are the only place it
    comes up, so those sites go in a table of 64 -- site, label, offset --
    and are filled in after every label has been placed. It costs 320 bytes
    and nothing else changes.
    Both of the cross-compiler's subscript shortcuts a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
    [comp.bas, emit.bas]
2026-08-07 S4d(4): SUB and CALL, and the tooling that found the bug
    Parameters, locals, RETURN, calls in expressions and as statements, all
    byte-identical to the cross-compiler. A pre-scan records SUB names so a
    call can precede its definition, and because it runs first in both
    passes the k-th SUB is symbol k -- which is how each body's frame
    survives from the silent pass to the real one.
    ## The stack is 256 bytes, and below it is hardware
    OS_PLAN puts the stack at $FF00-$FFFF with the I/O page directly below
    at $FE00-$FEFF. A stack that grows past about 250 bytes therefore pushes
    return addresses INTO HARDWARE REGISTERS, where they are silently lost:
    the push appears to work and the matching RET ret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
    [comp.bas, emit.bas]
2026-08-07 S4d(5): size the tables, and measure the fixed point
    The compiler's own source declares 238 named things against a symbol
    table of 40, so the tables are sized for it: 255 symbols, 256 labels, a
    1,400-byte name pool, 128 fixups.
    255 and not 256 because an expression node holds a symbol index in one
    byte and 255 is "no such symbol". That is a limit on how many things one
    program may NAME, not on how big anything is: array bounds live in
    sycnt, which is 16-bit, and the gate compiles DIM scr(4095) already.
    Labels are made when first needed rather than two per symbol. Two
    apiece cost 476 on the compiler's own source, most never used -- a
    constant needs none, a SUB and an array need one, only a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
    [comp.bas, emit.bas]
2026-08-07 Drop self-hosting; measure what the overlay problem actually is
    The fixed point is off the plan. The measurement that killed it:
    compiler code + tables 30,020
    its own source, comments stripped 36,686
    resident system 12,064
    ------
    78,770 of 65,536
    It does not fit in the address space, and the gap is not the sort you
    close by tightening a loop. With comments the source alone is 59 KB --
    the stored form keeps them verbatim so LIST can give them back, so prose
    costs the same as code.
    No 8-bit home computer self-hosted. BBC BASIC was written on Acorn's
    development sy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
2026-08-07 Size the compiler's tables for user programs, not for itself
    MAXSYM was 255 and the name pool 1,400 bytes, sized so the compiler
    could compile its own source. That is no longer a goal, and 128 names is
    generous for a program someone types at a machine with 39.5 KB of user
    memory. Six tables and the pool halve: 6.8 KB of working RAM becomes
    4.3 KB.
    That limit is on how many things a program may NAME -- variables,
    constants and SUBs together. Not on how big anything is: array bounds
    live in sycnt, which is 16-bit, so an array can still have 65535
    elements and the gate compiles DIM scr(4095) as before.
    ## The shrink cannot be done by tightening
    Measured before touching anything, because "rew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
    [comp.bas, emit.bas]
2026-08-07 Measure how an interpreted operation reaches the next, on this ISA
    sim/bench_dispatch.py. bench_lang.py answered "compile or interpret"
    and got 6.7x for native. This asks the question underneath: if we
    interpret, how should control get from one operation to the next? On an
    8-bit machine that choice is most of the speed, and the answer is
    instruction-set specific, so it is measured rather than taken from a
    6502 paper.
    mechanism clocks/op overhead bytes/op vs native
    token table 49.0 38.0 1 4.45x
    direct thread 30.0 19.0 2 2.73x
    subroutine 20.0 9.0 3 1.82x
    native inline 11.0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
2026-08-07 Prototype: a statement-dispatched interpreter, 1.5x native
    sim/bench_interp.py runs BM1 -- FOR K = 1 TO 1000: NEXT K -- three ways
    and checks all three leave K at the same value before believing any of
    the timings.
    clocks per iteration vs native
    native 52,056 52.1 1.00x
    interpreted 98,122 98.1 1.88x
    interpreted, tight NEXT 77,143 77.1 1.48x
    An empty FOR loop is the WORST case for an interpreter -- there is no
    real work for the dispatch to be amortised over -- and it still comes in
    under 2x. That is nothing like the 6.7x that native-versus-bytecode
    suggested, and better th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
2026-08-07 Three prototypes: where a statement interpreter actually loses
    sim/bench_interp2.py. bench_interp measured loop control and got 1.5x.
    That is the case statement dispatch flatters, because one dispatch
    covers a whole iteration. These are the three it does not, all checked
    for the same answer before any timing is believed:
    native interpreted ratio
    expression 66,061 333,061 5.04x
    subscript 62,061 193,061 3.11x
    call 48,061 219,061 4.56x
    So the loop figure was not representative. An expression has to walk
    operands and operators one at a time, and that is where the dispatch
    saving is given back: `A = K + 3 - K` costs fi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
2026-08-07 I1: the interpreter core, and the compiler documented for keeping
    ## sw/interp.asm
    317 bytes: statement dispatch, resident variables, an inlined expression
    walker, LET, FOR/NEXT, END. sim/test_interp.py runs three programs and
    requires the same answers as native code before reporting any timing.
    native interp ratio answer
    A = 7 17 190 11.18x ok
    A = K + 3 - K 55 335 6.09x ok
    FOR K = 1 TO 1000: NEXT K 50,040 77,279 1.54x ok
    The first two are single statements, so their ratios are fixed overhead
    against almost nothing and should not be read as speed. The loop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
    [interp.asm]
2026-08-08 I2: the interpreter executes the editor's own stored programs
    sw/interp.asm, 830 bytes, walking `lineno | len | tokens` with the
    editor's token bytes. Eleven cases in sim/test_interp.py: assignment,
    precedence, parentheses, unary minus, variables, IF/THEN taken and not,
    the six relational operators, FOR/NEXT with and without a body, and
    POKE/PEEK.
    I1 had invented a private token space where $80 meant LET. $80 is PRINT
    in TOKTAB. It only worked because the test poked its own bytes into
    memory and never met a real program.
    Numeric literals are now stored as token $A4 and two binary bytes rather
    than as ASCII digits, so a loop no longer re-parses decimal every time
    round. tokenise() emits it,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
    [interp.asm]
2026-08-08 Profile the interpreter, and stop guessing at it
    sim/dbg.py gains a Profile class: per-routine clock counts, attributed
    by nearest preceding code label, costed with the emulator's own cycle
    count so the numbers add up rather than approximate. sim/prof_interp.py
    runs the expression benchmark under it.
    This exists because guessing did not work. Flattening the expression
    evaluator from three nested calls per operand to one was the obvious fix
    and moved the benchmark by 1.6 %:
    846,149 clocks total
    stmt 185,180 21.9%
    openline 138,046 16.3%
    eval 136,098 16.1%
    prim 111,042 13.1%
    h_next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
    [interp.asm]
2026-08-08 The stored form gains an end-of-line marker: 9.20x -> 7.57x
    A record is now `lineno(2) len(1) tokens(len) 0`. The zero is not
    counted in len, so LIST and the memmoves in storeline are unchanged and
    SAVE/LOAD keep working -- which a per-line link, the other candidate,
    would have broken without a relink pass after every edit and load.
    What it buys, all of it measured rather than reasoned:
    **The end-of-line test is one load.** `stmt` was comparing Y against a
    maintained 16-bit end pointer on every statement. Now it reads a byte
    and tests it.
    **openline has nothing left to do** but put Y on the first token. It was
    16.3 % of the run maintaining that end pointer; it is 6.9 % now.
    **There is no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
    [interp.asm]
2026-08-08 An address is 16 bits, even when it fits in eight
    width() calls a literal one byte wide when it is under 256, and PEEK and
    POKE took that width for the address expression itself. R1 was never
    loaded with the high byte, so XH carried whatever the previous statement
    left there: the right offset of the wrong page, read by PEEK and written
    by POKE.
    It hid because every small constant in the system was an I/O register
    used bare, and `PEEK($FE70)` is a literal that takes the
    one-instruction path. It surfaced the moment a base below 256 was added
    to an index, which is what moving the filesystem's variables to $0074
    did. DIR printed EST.BAS.
    addr.bas gates it both ways: the same four bytes through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
    [cool8bas.py]
2026-08-08 The screen moves to $8000, FOR nests, and I3 gets its table
    The system had 3,026 bytes left of its 15.5 KB and needed room for an
    assembler, strings and RUN. The text map must be 8 KB aligned -- the row
    wrap is a mask -- so it sits at $8000 or $A000 and nowhere between, and
    mode 0's preset, the boot ROM's banner and the monitor were all already
    at $8000. The editor was overriding the preset to $A000, and that
    override was the only thing forcing the system up to $C000. Moving it
    back trades 8 KB of program space for 8 KB of system space and leaves
    one screen base where there were three; free space goes 3,026 -> 11,218.
    INTERP_PLAN said the screen could move into video RAM instead, "because
    t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
2026-08-08 Refactor interpreter to support long variable names and improve whitespace handling
    - Introduced inline SKIPSP macro to efficiently skip spaces in the interpreter.
    - Enhanced variable handling with a new structure for long names, allowing up to 6 significant characters.
    - Updated variable indexing to prevent incorrect assignments and ensure proper error handling for undefined variables.
    - Implemented array handling with checks for subscripts and memory allocation.
    - Adjusted error codes to reflect changes in variable management and memory handling.
    - Improved overall performance by reducing unnecessary calls and optimizing existing routines.
    [asm.asm, interp.asm, zp.asm]
2026-08-08 Refactor interpreter and documentation: update performance metrics, clarify token handling, and enhance division logic in assembly
2026-08-08 Implement DO/LOOP control structures: add support for DO/LOOP with optional WHILE/UNTIL conditions, enhance error handling for nested loops, and update interpreter logic accordingly.
    [interp.asm, zp.asm]
2026-08-08 Enhance interpreter to support string functions: add implementations for LEFT$, RIGHT$, MID$, CHR$, and ASC; update related assembly logic and tests accordingly.
2026-08-08 Implement CALL and RETURN functionality: add support for SUB procedures, including name resolution and stack management; enhance interpreter logic and related assembly code.
2026-08-08 Implement RUN command and associated error handling: add RUN functionality to the interpreter, including program execution and error reporting; enhance test coverage with new test_run.py.
    [interp.asm]
2026-08-08 Refactor interrupt handling and improve debugging tools
    - Updated documentation in `04-system.md` to clarify interrupt sources and their behavior, specifically noting that the timer and UART do not raise interrupts.
    - Enhanced debugging capabilities in `10-debugging.md` by detailing the API for driving the machine and emphasizing the importance of using `m.tick()` instead of `cpu.step()`.
    - Refactored various simulation scripts (`bench_dispatch.py`, `bench_interp.py`, `bench_interp2.py`, `test_asm.py`, `test_basic.py`, `test_emit.py`, `test_fs.py`, `test_interp.py`, `test_lex.py`, `test_run.py`) to replace manual stepping loops with `m.run()` for better accuracy in simulating machine behavio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
    [interp.asm]
2026-08-09 Refactor interpreter and add board management tools
    - Updated `interp.asm` to handle `DO WHILE` and `DO UNTIL` conditions more robustly by separating the condition checking into a new routine `docond`.
    - Enhanced `run.mjs` to support heartbeat logging for long-running jobs, improving visibility into job status and execution time.
    - Introduced `board.py` for managing the COOL8 board over serial, allowing for program execution, memory inspection, and screen output retrieval.
    - Added `doctor.py` to check for installed dependencies and tools, providing clear feedback on missing components and their implications.
    - Created `flash.py` to streamline the flashing process of the COOL8 board, ensuring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
    [board.py, doctor.py, flash.py, interp.asm]
2026-08-09 Document flash access issues on iCESugar board and update bitstream handling in flash.py
    [flash.py]
2026-08-09 Enhance flash handling and debugging tools
    - Updated iCESugar board constraints to correctly assign flash pins and added necessary SB_IO configurations.
    - Improved documentation in 05-board.md regarding flash wake-up sequence and resolved issues with CPU access to SPI flash.
    - Refactored cool8_flash.v to implement a wake-up sequence for the flash memory, ensuring proper initialization.
    - Created cool8_flashtest.v to verify flash reading functionality independently from the main SoC.
    - Added flash.py updates to clarify FPGA reconfiguration behavior after flash writes.
    - Enhanced boot.asm and basic.bas to reflect changes in boot behavior and LED indications.
    [boot.asm, cool8_flash.v, cool8_flash_tb.v, cool8_flashtest.v, cool8_top.v, flash.py]
2026-08-09 Refactor BASIC execution flow; improve cursor behavior and add input handling pause
2026-08-09 Enhance assembly error handling and improve window scaling in pygame
    [interp.asm]
2026-08-09 Space hunt, unified terse errors, boot screen in the stub, peephole pass
    The resident system drops from 24,063 to 22,614 bytes (1,450 free):
    - Workspace out of the image: FOR frames, input ring, key bitmap and
    scratch as equates into the idle $FF00 page; the fs page buffer laid
    over the string accumulator (disjoint lifetimes); ctab halved, its
    token half was 128 zeros behind a new bit-7 guard.
    - One error table, C64-terse: ERRTAB merged into RUNTAB, no ERROR
    suffix anywhere, editor and interpreter report through one mouth.
    - The boot screen moved wholesale into the relocating stub, free count
    computed at build time; the chime removed; init wipes all user RAM
    behind itself, so no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
    [cool8bas.py, interp.asm, mkboot.py]
2026-08-09 Peephole rules 3-5: TST for live reloads, AND-255 fold, const >>8 fold
    A store/reload pair whose Z/N are still read becomes ST + TST -- TST
    is OR Rd,Rd, N/Z from the register and C untouched (02-isa.md), which
    is exactly the LD it replaces. The AND-with-255 no-op folds to nothing
    or a TST behind a register-liveness check on R2, and a constant's high
    byte no longer travels through both halves of a pair. -12 bytes; the
    census says the compiler is now clean of everything but real work.
    The full run suite passed on the first pass (675 s); the fast gates
    pass on this one.
    [cool8bas.py]
2026-08-09 Hand-asm shared tails: earg and negp16
    The n-gram census over the hand-written interpreter found ten literal
    "CALL sopen / CALL eval / CALL sopen" builtin prologues and seven
    inline 16-bit negates. Both become helpers: earg tail-calls sopen so
    its RET is the return; negp16 preserves R2/R3 (checked at every site)
    and replaces the old clobbering neg16, whose callers all redirect and
    whose body is deleted. -96 bytes, 22,506 resident, gates green.
    [interp.asm]
2026-08-09 Peephole rule 6: merge adjacent stack cleanups; static-frame idea measured and closed
    Seventeen back-to-back ADDW SP,#n pairs in the compiled output fold to
    one each (ADDW touches no flags, so no liveness question). -51 bytes,
    22,455 resident.
    Recorded for the next visitor: the static-frames idea (args and locals
    in fixed slots -- sound, the 45-SUB call graph has no recursion) LOSES
    on this ISA. [SP+u8] is 2 bytes and 3 cycles against [abs16] at 3 and
    4, and the compiled system does 1,788 frame accesses against ~300
    pushes and 250 cleanups. The frame convention is why the encoding
    exists; the machinery it costs is already cheaper than the escape.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
    [cool8bas.py]
2026-08-09 Direct-push arguments: the 146 call-site temp round-trips eliminated
    gen_call evaluated EVERY argument into a frame temp and re-loaded it
    before pushing, guarding [SP+u8] param reads against SP movement. The
    guard is now push_bias: the two argument pushes are the only
    mid-expression SP movement the emitter has, so the displacement is
    statically exact and nests through inner calls. Arguments evaluate
    right to left, straight onto the stack; param and local loads add the
    bias. Baseline output is bit-identical (bias is zero outside the
    optimized path), so the self-hosted parity gates hold.
    -1,226 bytes in one change: 21,229 resident, 2,835 free. The temp
    collapse also shrank every frame, which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
2026-08-09 One vocabulary: the editor commands are ordinary statements
    CMDTAB, iscmd and docommand are gone (~1,100 bytes). LIST NEW FREE
    RENUMBER DELETE CLS SAVE LOAD DIR ERA COMPACT DRIVE RUN are tokens
    $B9-$C5 with thin asm parsers over the same compiled cores, so every
    one runs in a program or typed direct -- the shape the C64 and the BBC
    always had. enter() is now: digit stores, anything else executes.
    New capability, all tested in sim/test_basic.py:
    - SAVE from a running program; LOAD in a program CHAINS -- the new
    program continues from its first line with variables kept.
    - SAVE "N" AT addr, len and LOAD "N" AT addr: raw bytes through the
    filesystem, the BBC star commands brought inside the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
2026-08-09 The Rust fast runner: the CPU at 158x, held to cosim's own contract
    Profiling put the cost in the Python stepping loop, so the loop is
    ported, not the authority: tools/cool8emu.py stays the executable
    specification and rust/ is never right when they disagree.
    sim/rustsim.py holds it there with the exact contract sim/cosim.py
    holds the RTL to -- progen's programs, one state line per retired
    instruction, whole-memory compare. The tables are generated from
    opcodes.py by tools/mkrsopc.py, drift-gated like the TinyTapeout copy;
    the hand-written Rust states semantics only. Measured on the multiply
    sweep: 0.73 M instr/s CPython, 114.8 M instr/s Rust.
    Documented in RUST_PORT.md, at the user's direc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
    [cpu.rs, main.rs, mkrsopc.py]
2026-08-09 The machine in Rust: flash to BASIC to a keypress, byte-identical, 132x
    Phase 2 of the fast runner. rust/src/machine.rs ports cool8vm.py's
    Machine -- the memory map and ROM overlay, UART, PS/2, the flash and
    its floor, the sound engine, the whole video register file, and the
    tick() scanline accounting -- behind a Bus trait the CPU now steps
    through. Rendering and the font stay in Python on purpose.
    The gate is the same contract one level up: a stimulus script both
    sides execute identically, the Rust trace streamed over stdout and
    compared in lockstep per retired instruction, RAM, VRAM and the UART
    output diffed at the end. The heavy workload is test_boot_basic's own
    path -- a flash image, a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
2026-08-10 The interp suite runs on the Rust machine: 1.9s to 0.7s, cycle-exact
    tools/cool8rsvm.py is the consumer path the port was waiting for:
    machine() hands test code a cool8vm.Machine stand-in covering exactly
    the batch slice -- bus.mem, pc/sp, romen, run(budget) -- backed by one
    cool8rs +serve process per suite, a fresh machine per run whose loop
    is Machine.run's own so stopping behaviour moves unchanged. It falls
    back to the reference machine without cargo, and COOL8_PYVM=1 forces
    it, the second opinion when a failure needs one.
    sim/test_interp.py moves its batch runs across; the SP high-water case
    stays on the reference machine because it watches every instruction,
    which is exactly the bounda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
    [cool8rsvm.py, main.rs]
2026-08-10 The tests catch up with the editor rewrite and the CONST removal
    Four suites were failing against work the tree had already done.
    test_asm's standalone prelude never gained the stubs for the editor
    cores interp.asm's tokenised commands now call -- the same block
    test_interp already carries. test_lex and test_comp fed CONST source
    to the self-hosted pipeline, which correctly dropped the keyword; the
    parity tests now speak the common language, host-folded CONST staying
    a host-compiler feature by design. test_interp's copy of the TOKTAB
    order still named slot $84 CONST, which toktab.asm had already made
    RUN.
    Still red, deliberately untouched: check_names, over the stale
    CONST COLS/ROWS pair in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
2026-08-10 Graphics, sound and keyboard for the Rust machine, from the RTL down
    rust/src/render.rs is a scanline renderer derived from cool8_fetch,
    cool8_pixel, cool8_sprite and cool8_vga rather than from cool8vid.py:
    the line buffer filled a source row ahead, row_ptr walking from a base
    latched at frame start (so page flips cannot tear), registers sampled
    per line (so raster splits land where the write preceded), text cells
    held for sixteen lines, patterns flipped at fetch, eight sprite slots
    a line with trailing rows counting. cool8vid could not afford any of
    this -- 0.88 s a frame in CPython is its own stated reason -- and at
    Rust speed it costs nothing. Gated per pixel against render_np, the
    model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
    [cool8rsrun.py, emu.rs, machine.rs, main.rs, render.rs]
2026-08-10 The window grows up, the batch machine grows a register file
    The emulator front end reaches parity with cool8run.py and passes it:
    +keys=text|raw|both -- text takes the OS's characters so the user's
    layout applies, typed through the launcher-derived keymap; physical
    keys get the PS/2 typematic a held key really produces. F11 and
    Ctrl+Pause are the break button, F12 writes a PNG (the png crate; wav
    via hound -- established wheels, not reinvented ones), +wav= captures
    the speaker, and a dirtied flash is written back at exit so SAVE
    survives the window closing.
    The sprite engine's clock budget is modeled from the RTL's own stated
    costs: a line that runs out of clocks loses its last-rendered --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
2026-08-10 Mode 3 gets the whole screen, and the text modes' own face
    The 1 bpp console covered 240 of mode 3's 480 lines: the cell map
    tops out at 32 rows (stride x 32 is the wrap, in gates -- D30), so 60
    rows of 8-line cells were never available, and 30 stopped halfway.
    Doubling the 8x8 glyphs would have wasted exactly the resolution the
    mode exists for. Instead the boot stub now seeds a second font: the
    96 glyphs at 8x16, verbatim from the same Spleen BDF the bitstream's
    font ROM is built from -- the CPU cannot read that ROM, so the copy
    rides in the stub's reclaimed memory, 1,536 bytes at VRAM $F600,
    below the GTEXT 8x8 at $FC00 where no framebuffer reaches. Mode 3's
    cells are 16 undoubled lines; 3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
2026-08-10 The interlace was bstr; the fast variant was a broken build; two chords
    Mode 3 glyphs drew on alternate lines: bput still stepped bstr =
    gs8 >> 3 per font row, two raster lines once gs8 doubled. The step is
    one raster line by definition, so setgeom computes it once from the
    hardware stride and bput leaves it alone -- 24,019 bytes, 45 free to
    $FDFF, and the measured cost of a mode 3 keystroke is ~5,000 cycles,
    three 16-row blits and the editor around them.
    The benchmark that briefly said otherwise was measuring a lie worth
    recording: the per-glyph variant weighed 24,071 bytes against the
    $FE00 ceiling's 24,064, and test_basic.build() does not police the
    ceiling -- so the relocation wrote its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
    [emu.rs, mkboot.py]
2026-08-10 BASIC owns the NMI: the break button stops a program instead of it all
    SW[0] is documented as the break button -- an NMI that lands a hung
    program in the monitor with its state intact. That contract assumed
    the ROM handler behind the vector, and BASIC boot turns the overlay
    off: the stale vector then pointed at image bytes, and pressing break
    under BASIC executed the middle of the interpreter. It looked like a
    break, because it broke things -- and RUN and LIST were dead until a
    reboot. Reproduced keystroke for keystroke in the harness, byte-
    identical on both machines, which is what ruled the emulators out.
    BASIC now installs inmi beside iisr: push R0, set ibreak, pop, RETI --
    the same flag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
2026-08-10 Fullscreen is a bare popup, not a resizable captioned window
    Alt+Enter produced a "fullscreen" that still carried a caption and a
    sizing frame -- WindowOptions kept resize and the title bar on -- so
    the picture sat a title bar too low with a border round it. The
    fullscreen window is now borderless, titleless and fixed-size at the
    screen's own dimensions; the windowed one keeps its chrome.
    [emu.rs]
2026-08-10 The window is SDL2 now -- the wheel pygame already rides
    minifb could not say fullscreen and meant it: no fullscreen API at
    all, so the front end faked one from a borderless window and got a
    maximised window with opinions. Gone, with everything that propped it
    up -- the GetAsyncKeyState chord poller, the hand-rolled typematic
    timer, the char callback, cpal and arboard. SDL2 owns the window, and
    Alt+Enter is set_fullscreen(Desktop): the real thing. The GPU scales
    the 640x480 through set_logical_size with the aspect kept and the
    bars drawn by SDL, text input carries the user's layout, Ctrl+Pause
    arrives as SDL says it (Cancel on Windows, Pause elsewhere), held
    keys repeat because SDL repeats t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
2026-08-10 The machine keeps its own time; vsync only shows the picture
    One machine frame per presented frame meant the machine ran at the
    monitor's refresh -- on a fast panel everything, the cursor blink
    first among them, ran proportionally quick. The machine now advances
    against the wall clock at its own 59.97 Hz (8.375 MHz over the
    139,650 cycles a frame costs), presentation stays vsync-paced, and a
    stall skips forward rather than sprinting to catch up.
    [emu.rs]
2026-08-10 A lazier cursor: rate 2 in silicon, 32 frames in software, every mode
    The editor blinked the hardware cursor at rate 1 -- 267 ms a phase,
    quicker than the C64's 333 -- and the soft cursor at 20 frames, which
    IS the C64's. Both now blink at 32 frames a phase, 533 ms: the
    hardware rates quantize to 267 or 533 and lazier was asked for, so
    the bitmap modes' soft cursor follows the same count and every mode
    blinks alike. 24,040 bytes, 24 free.
2026-08-10 D53: the cursor the screen shows is frame-latched, like VID_BASE
    The pixel stage sampled CUR_X/CUR_Y live, so a mid-frame move split
    the block across two columns for a frame -- period-true of every
    live-sampled hardware cursor since the CRTC, invisible on phosphor,
    and faithfully reproduced by the scanline renderer onto an LCD that
    holds the frame. cool8_vregs now hands the display copies latched at
    frame_start, the blink-phase restart deferred to the same edge, so
    the cursor's whole screen state changes atomically; reads still
    return the written value at once. Measured: 330 LUT4 / 186 FF against
    337 / 173 -- thirteen flip-flops bought, seven LUTs returned, the
    blink mux coming out simpler t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
    [cool8_vregs.v, render.rs]
2026-08-10 Update documentation and filesystem implementation details
    - Added decision log entry for storage volume design and rationale.
    - Expanded mass storage section in system documentation to clarify filesystem structure.
    - Updated BASIC language reference to include filesystem format and geometry.
    - Revised comments in filesystem assembly code for clarity on structure and format.
    - Adjusted Verilog top module for proper flash I/O instance declarations.
    - Enhanced testbench for monitor to handle unknown opcodes correctly.
    - Added font generation logic to the simulation script.
    - Removed unused constants from BASIC source code.
    [cool8_mon_tb.v, cool8_top.v, cool8_top_tb.v, fs.asm]
2026-08-10 Refactor project structure and update tooling
    - Replaced npm commands with poe in doctor.py for improved task management.
    - Removed keyscan.py as it is no longer needed.
    - Updated mkrsopc.py to reflect changes in file structure.
    - Deleted run.mjs and migrated task definitions to pyproject.toml.
    - Introduced pyproject.toml as the new project manifest, replacing package.json.
    - Added test_jobs.py to run jobs defined in pyproject.toml using pytest.
    - Created cool8kbd.py to handle keymap encoding from assembly source.
    [board.py, cool8_mon_tb.v, cool8kbd.py, cool8rsrun.py, cool8rsvm.py]
2026-08-10 Refactor simulation scripts to use toolchain module
    - Replaced direct imports and calls to cosim with toolchain in test_load.py, test_loader.py, test_monitor.py, test_ps2.py, test_run.py, test_snd.py, test_soc.py, test_spram.py, test_video.py, test_vport.py, and test_vram.py.
    - Consolidated common functionality into harness.py to reduce code duplication across test scripts.
    - Updated build and run commands to utilize the new toolchain interface for improved maintainability and clarity.
    - Enhanced comments and documentation for better understanding of the changes and their purpose.
    - Adjusted demo.bas to optimize sprite movement logic by removing unnecessary masking operations.
    - Updated cool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
    [cool8rsrun.py, cool8screen.py, demo.bas, flash.py]
2026-08-10 REM was a syntax error, and one tick loop was 90% of the suite
    Comments never ran. The tokeniser copied `REM ...` and `'` ...` to the
    end of the line verbatim -- correct -- but stored as plain text they
    arrive at `stmt` as bytes below $80, which is exactly what the
    dispatch hands to the assignment handler. Every comment was ?SYNTAX,
    in every form: empty, words, asterisks, `=`, dashes.
    So a comment becomes what every other statement already is: a token.
    REM joins toktab at $C5 and lookup finds it, case and all, which
    deletes the hand-written three-character match in tokenise -- and that
    pays for the whole feature twice over: 24,040 bytes with 24 free
    becomes 23,970 with 94. The text still fo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
    [interp.asm, toktab.asm]
2026-08-10 The UART FIFO handed one byte out twice, and only sometimes
    Typing `E 0500 A5 5A` at the monitor echoed `A55 5A` and stored $55.
    The receiver was blameless -- the strobes into the FIFO were exactly
    the bytes sent -- and so was the monitor: the duplicate was made
    between them.
    `rx_settle` hides the cycle in which `rx_head` is not yet the byte at
    `rx_rd`, and only two things put it there: a pop, which moves `rx_rd`,
    and a push into an EMPTY FIFO, which writes the entry `rx_head`
    already points at. A push into a FIFO that is not empty lands at
    `rx_wr` and leaves `rx_head` alone -- but it was settling for that
    too, which drops `rx_avail` for a cycle, and `rx_pop` is gated on
    `rx_avail`. A read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
2026-08-10 A test that got faster has to still catch what it caught
    Two follow-ups to the FIFO fix, both under one rule: speed is only
    worth having if the test still fails when the machine is wrong.
    sim/test_run.py's break test now runs the machine SIX million cycles
    where the tick loop it replaced ran about 1.5 M instructions -- some
    4.5 M. Trading a Python loop for a server-side run is free; quietly
    leaving the program running for less time than before is not, and a
    rewrite that narrows what a test can catch is a regression wearing a
    speedup's clothes. It costs milliseconds either way, because the cost
    was never the machine.
    sim/tb/cool8_soc_tb.v gains a streamed-echo phase: thirty-two bytes
    throug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
    [cool8_soc_tb.v]
2026-08-10 The pixel clock is load-bearing in a test that never draws a pixel
    Two open items closed, one of them by not doing it.
    The sound diff was already there and I had been reading a stale note:
    sim/test_snd.py dumps 4096 level bytes off the running RTL engine and
    sim/test_vm.py gates the machine against them -- "4096 samples, 0
    wrong". Verified rather than assumed this time.
    The pclk speedup is refused, and the measurement is why. Nothing in
    sim/tb/cool8_mon_tb.v looks at a pixel, so running the raster at a
    quarter speed looks free: 220s becomes 160s and all thirteen checks
    still pass. Then mutation-test it -- put `rx_settle <= rx_pop |
    rx_push` back -- and the slow-raster version reports PASS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
    [cool8_mon_tb.v]
2026-08-10 D54: the keyboard restarts the machine, because software cannot
    There was no way back from a wedged program. SW[0] reaches NMI and
    BASIC handles it, but a game may take that vector, and the board has
    no reset pin -- so recovery meant the power switch.
    Software cannot fix that by itself, which is the whole argument: a
    chord BASIC watches for is invisible exactly when it is needed, since
    a program that has disabled interrupts and stopped reading the FIFO
    cannot be asked to restart. cool8_ps2 now tracks Shift, Ctrl and Alt
    across break codes and raises two outputs. Ctrl+Shift+Esc restarts
    cool8_top's power-on stretch -- indistinguishable from switching the
    machine off and on, and nothing in so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
    [cool8_ps2.v, cool8_ps2_tb.v, cool8_soc.v, cool8_top.v, machine.rs, mkbit.py]
2026-08-10 The chords, tried on the machine that boots from flash
    D54 was gated in the keyboard block and modelled in rust/, which
    proves the decode and the parity but not that pressing the keys does
    anything useful. sim/test_boot_basic.py is where it can be asked
    properly: a real image on a real volume, autoboot, BASIC, a program
    typed at the PS/2 port.
    So the machine is first put in the state a restart exists for -- MODE
    4, a bitmap the editor cannot be read on -- and then:
    Ctrl+Esc mode 0 is back and LIST still has the program
    Ctrl+Shift+Esc the banner is back and LIST has nothing
    Raw scancodes, not m.key(): the chords are decoded by the keyboard
    before software sees them, and goi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
2026-08-10 F9 and F10 restart the machine, because Windows keeps the real chords
    Ctrl+Esc and Ctrl+Shift+Esc never reach the emulator: the shell takes
    one for the Start menu and the other for the task manager, and an
    application does not get a say. On the board there is no operating
    system between the keyboard and cool8_ps2, so the chords work exactly
    as D54 designed them -- this is a host problem, and it is the host
    that should bend.
    So the front end takes F9 and F10 and injects the chords' raw
    scancodes, the same bytes sim/test_boot_basic.py already drives the
    machine with. The machine cannot tell which keyboard sent them, the
    path under test stays the real one, and the hardware keeps a
    convention c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
    [emu.rs]
2026-08-10 The Rugg/Feldman benchmarks, beside the machines they were written for
    BM1-BM7 in COOL8 BASIC, typed at the editor and RUN, measured in
    cycles rather than with a stopwatch -- and measured on the body: every
    benchmark runs twice, once whole and once with the loop taken out, so
    the editor, the parse, both PRINTs and the way back to the prompt
    subtract out. That is what the stopwatch between the S and the E was
    doing.
    Three adaptations, each named in the file: GOSUB becomes CALL/SUB,
    which this language has instead; LET is gone; and the bare line number
    after THEN was Microsoft shorthand this language never had. BM8 is not
    run and no number is invented for it -- it is K^2, LOG and SIN, and
    the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
    [interp.asm, mkbit.py]
2026-08-10 The 8088 joins the table, and the V20 does not
    The IBM PC is real and measured: 8088 at 4.77 MHz, BASICA, BM7 in
    37.4 s -- against 1.77 s here at a clock only 1.8x higher, and losing
    to a 3 MHz Z80 (ABC 800, 19.6 s) on the way. BASICA is floating point
    out of a ROM built for a different job, and the 8088's half-width bus
    does the rest. Apple III and the VIC-20 come along in the same table.
    The 8086 and the NEC V20 are not here, and neither is the TRS-80. The
    V20 was a pin-compatible 8088 replacement and an 8086 has the wider
    bus, so both would land near the IBM PC row -- which is an argument,
    not a measurement, and this table carries measurements. The TRS-80 is
    the bigger gap: a 1.77 MHz Z8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
2026-08-11 Refactor interpreter and remove obsolete commands
    - Updated `build_basic.py` to clarify command handler costs and their implications on memory reclamation.
    - Modified `prof_interp.py` to profile two programs under the debugger, highlighting the performance impact of built-in function lookups.
    - Enhanced `test_interp.py` with new test cases for the `VAL` function, ensuring correct handling of fractions and negative values.
    - Adjusted `test_run.py` to reflect changes in the `VAL` function and removed references to obsolete commands like `VPOKE`, `SCROLL`, and `SPRITE`.
    - Removed the implementation of `SCROLL`, `PALETTE`, `SPRITE`, `VPOKE`, and `HLINE` from `interp.asm`, replacing them with app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
    [interp.asm, memmap.py, vocab.py, zp.asm]
2026-08-12 Refactor BASIC calling conventions and enhance assembler functionality
    - Introduced CALLB1 and CALLB1K macros in call.asm for consistent calling of compiled BASIC routines from assembly.
    - Updated h_input in interp.asm to handle INPUT statements for strings, integers, and floats, improving type handling.
    - Added relaxation logic in cool8asm.py to automatically grow branches that exceed displacement limits, enhancing assembler robustness.
    - Implemented tests for assembler behavior in test_cool8asm.py, ensuring correct opcode generation and branch handling.
    - Created ed.asm for hand-written editor routines, focusing on performance and maintaining the calling convention.
    - Added CLAUDE.md to cl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
    [call.asm, cool8asm.py, cool8bas.py, cool8rsvm.py, ed.asm, interp.asm]
2026-08-12 Refactor memory mapping and I/O definitions
    - Updated `tools/memmap.py` to derive memory addresses from source files, ensuring consistency and reducing duplication.
    - Introduced a new `sw/io.asm` file to define I/O addresses using a single base constant, improving maintainability.
    - Added `sw/io.bas` for BASIC definitions of I/O constants, ensuring they are derived from the same source as the assembly.
    - Modified `tools/mkboot.py` and `tools/mkrom.py` to reference the new I/O definitions, eliminating hardcoded values.
    - Enhanced the memory map checking mechanism to prevent overlaps and ensure proper allocation.
    [board.py, boot.asm, cool8_boot_tb.v, cool8_mem.v, cool8_mem_tb.v, cool8_soc.v, cool8_soc_boot_tb.v]
2026-08-12 input.asm: PS/2 and ANSI meet in one place
    Second module of the D68 port, still parallel: nothing calls it and
    sw/basic.bas keeps the machine working.
    serialkey decoded ESC [ A with a chain of eight IF comparisons, one per
    named key, which is 393 bytes for a lookup. K_UP..K_INS are contiguous,
    so the table holds the final ANSI byte and an offset from K_UP, and the
    two sequences that end in ~ are marked with a bit rather than given
    cases of their own.
    622 bytes of compiled routines become ~235 -- 2.6x.
    sim/test_input.py fills the ring from Python rather than through the
    interrupt, which is the point of a unit test here: in_key decodes what
    is in the ring, and which wire the bytes came from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
2026-08-12 tokens.asm: the token numbering is generated, not remembered
    tools/vocab.py already read TOKTAB. It now generates sw/tokens.asm from
    it -- the same arrangement ioregs.py has for the I/O page -- and poe
    check fails if the file is stale. The numbering was hand-copied into
    three places: 25 K_* equates in interp.asm, a CONST T_LIT in basic.bas,
    and a private 37-word list in test_interp.py, in a table of seventy.
    D65 called the order frozen because "programs on disk hold the old
    numbering". There is no installed base; every .img under sim/build is
    generated by the suites. The order is now something the build knows and
    nobody has to remember, which is what lets token.asm give TOKTAB a flags
    byte.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
    [interp.asm, vocab.py]
2026-08-12 token.asm: the tokeniser, and the float literal it was blocking
    Third module of the D68 port. Redesigned rather than ported.
    The keyword flags come out of a generated table. sw/tokflag.asm is one
    byte per keyword, emitted from TOKTAB beside tokens.asm, and F_VERB is
    what makes REM take the rest of the line -- so the inline REM case the
    compiled tokeniser carried is gone. F_LINE is unread here on purpose: it
    is for RENUMBER, which cannot currently find a GOTO target to rewrite.
    The number parser is snum, not a fourth digit loop. The compiled
    tokeniser had one inline, number() had another, and snum is the
    interpreter own. Because snum already reads a fraction and already
    decides integer or f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
    [interp.asm, token.asm, toktab.asm, vocab.py]
2026-08-12 prog.asm and num.asm: the store, and RENUM finally correct
    Fourth and fifth modules of the D68 port.
    num.asm is the bottom of the stack with the console: numbers as text,
    and a divide-by-ten to make them. It exists because con_putn would have
    had to call udiv16 in interp.asm -- a call upward, and the smell that
    says a routine is in the wrong file. The console emits characters; this
    decides which characters.
    prog.asm is the stored program: find, insert, delete a range, list,
    renumber. Its four top-level commands share one six-byte scratch block
    rather than owning thirteen bytes between them, because none of them can
    be running while another is -- an invariant memmap.py cannot see, so it
    is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
    [interp.asm, num.asm, prog.asm, token.asm]
2026-08-12 edit.asm: the screen is the document
    Sixth module of the D68 port. The C64 arrangement generalised: a logical
    line may span several rows, CONT marks the continuations, and Return
    reads the line back off the display rather than out of a buffer somebody
    maintained. Every editing operation is read / edit / write, and one
    implementation covers all four modes and all three widths.
    ed_enter is the whole grammar and it is BBC BASIC SPTSTN: read the line,
    tokenise at entry, look for a line number, store it or run it now. One
    branch.
    Two bugs found by running it:
    * ed_write read the row it had pushed at [SP+2] instead of [SP+0] --
    the same slip as prg_find, and the reason that one is now writ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
    [cool8asm.py, edit.asm]
2026-08-12 fscmd.asm and main.asm: every module written; the switch-over remains
    Seventh and eighth modules of the D68 port.
    fscmd.asm is the language side of the filesystem: parse a name, call the
    right fs.asm primitive, say what went wrong, plus COMPACT and its
    scratch sector. fs.asm own state is reached by name now -- the compiled
    version read fsent and fsfpg as the literals $007B and $0078 with a
    comment saying they must track FSVARS, which is the invisible allocator
    D67 removed everywhere else.
    main.asm is boot and the prompt loop, in BBC BASIC shape: read a line,
    tokenise at entry, look for a line number, store it or run it now. The
    loop is the C64: no prompt, no input buffer, the screen is the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
    [fscmd.asm, main.asm]
2026-08-12 test_fscmd.py: the disk commands get a suite before the switch-over
    fscmd.asm was 2,942 bytes of compiled BASIC replaced by code that had
    never executed, and it is the only code whose bugs corrupt a volume.
    Nine checks on fsc_name -- every form the editor accepts, the padding
    that makes a name match byte for byte, and the comma that has to end an
    unquoted name so LOAD "N",100 still has its number.
    Running it found that fscmd.asm had declared its own 11-byte FSNAME
    while sw/fs.asm already has fsname, "the name being sought". The two
    fold together in a case-insensitive symbol lookup, so the suite read
    back zeros from the wrong one -- and fs_find copies into its own buffer
    anyway, so the claim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
    [fscmd.asm, main.asm]
2026-08-12 the handlers go home, and the suites stop building their own machine
    Two changes that are one change: the image knows its own layering, and
    the tests stop inventing a second one.
    sw/interp.asm was a hub. It held the disk command handlers, `tname`,
    and `sttab` -- and since the table names every handler in the system,
    anything that wanted the expression evaluator pulled the whole image in.
    That is what forced four suites to assemble their own program in front
    of the module under test, with stand-ins for everything the include
    dragged along, and then to split one stub block apart on a comment line
    to take the half they wanted. The private-copy trap AGENTS.md names,
    arrived at from a direction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
2026-08-12 test_run.py: the float literal case records the gap closed
    It asserted `?SYNTAX IN 10` for `10 PRINT 1.5`, which was true for as
    long as the tokeniser was compiled BASIC''s and had no decimal point in
    it. sw/token.asm has one, so the line prints 1.5 and the suite says so.
    Measured either side: 8 case failures at HEAD, 7 with this. The rest --
    strings, arrays, the subscript check -- want the name table and the heap
    set up and were failing before the handlers moved; they are the next
    thing, not a consequence of this branch.
2026-08-12 test_interp: the interpreter suite boots the system instead of faking it
    The suite carried a hundred lines of harness -- pointer writes copied
    out of the editor, then forty stubs standing in for every routine
    interp.asm named, because naming them all was what interp.asm did.
    Moving the handlers out took the reason away, so the harness goes too.
    The driver is three lines now: con_init, main_pre, irun. `main_pre` is
    sw/main.asm''s real cold-boot initialisation and derives NTAB and PEND
    from PROGEND, so a case seeds the store, writes PROGEND, and lets the
    system arrange itself. cpi.py and prof_interp.py, which each held a
    copy of the same setup, call boot() too. H.MODULE_STUBS is deleted; it
    h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
2026-08-12 test_interp: green, and the four "silent" string cases were the reader
    `printed()` stopped at the first blank row, so a program that assigned
    before it printed read as an empty screen -- the text was sitting on
    row 3. Every row now, stripped and joined, with the row count asked of
    the machine rather than assumed.
    That was the whole of it: the interpreter was printing correctly the
    entire time. What the old harness hid was not a bug in sw/interp.asm
    but the fact that nobody had ever looked at the screen -- `con_putsn`
    was a recording stub that appended to a buffer, and a buffer has no
    rows to get wrong.
    sim/test_interp.py now passes in full against the shipped image.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
2026-08-12 USERTOP was 313 bytes too high, and DIM wrote arrays over the console
    `10 DIM A(3)` followed by any PRINT printed nothing. No error, no
    output, a blank screen -- which reads exactly like a program that never
    ran, and is why it survived the whole port.
    sw/zp.asm said `SYSBOT = irring`. That was true while zp.asm held every
    claim in the region. sw/console.asm then claimed $7DAF-$7DE8 -- CONT,
    the mirror, the cursor and the entire geometry -- *below* irring, and
    sw/main.asm claimed MAINK lower still at $7C76. USERTOP is SYSBOT-1, so
    the heap was handed 313 bytes of system storage to allocate over.
    halloc took ten of them for the array and wrote it across CCY, CTOP,
    CCOLS, CROWS, CKIND and CLIM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
    [console.asm, interp.asm, memmap.py, vocab.py, zp.asm]
2026-08-12 the board boots from flash: an entry point, a DI, and a banner kept
    19 suites green, 0 failing. The port runs on hardware''s own path now,
    not just when a harness pokes the image in and jumps to `main`.
    Three bugs, all of them only reachable from a cold flash boot:
    **The image had no door.** The relocating stub jumps to $A000 because
    that is where it was told to load; it has no symbol table. While the
    system was compiled BASIC the entry happened to be first. Here `main`
    is at the far end past every module, so $A000 was the middle of
    sw/console.asm -- the machine relocated perfectly, executed console
    internals as if they were a program, and wandered into user RAM. Three
    bytes of `JMP main`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
    [console.asm, main.asm]
2026-08-12 sw/basic.bas is deleted: the port replaced it
    11,008 bytes of compiled BASIC, 47% of the old image and the reason
    [D66] existed. Everything it did is sw/*.asm now, and 19 suites say so.
    What went with it is worth more than the file. It declared storage with
    `DIM x AT $00xx`, which emits no symbol and no size, so seventeen claims
    were visible to tools/memmap.py and to nothing else -- the map carried
    $00A4-$00D9 as "the editor''s" and could not say what would break if
    something else took a byte. That whole span is free now, 54 bytes, by
    derivation rather than by assertion. The map went from 117 claims and
    1,129 bytes to 100 and 820.
    Three readers had to be pointed somewhere real:
    - tools/co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
    [cool8kbd.py, memmap.py, mkboot.py, zp.asm]
2026-08-12 the docs stop describing a port that is finished
    ASM_MOVE_PLAN.md and D68 said "in progress" and carried the predicted
    numbers; both now carry the measured ones -- 17,314 bytes against
    23,528, 6,214 saved -- and the four things the plan got wrong, which
    are the part worth keeping: the layering was upside down at fscmd, the
    dispatch belongs above the handlers rather than beside them, a module
    boundary is not a test boundary, and the storage floor cannot be an
    equate.
    docs/13-basic.md: PRINT 1.5 works, and the sizes are the new ones with
    7,006 bytes free rather than 792.
2026-08-12 MODE n never told the console, so only the text modes drew anything
    Reported from the emulator: modes 0 and 1 work and nothing else does.
    `h_mode` wrote VID_MODE and returned. `con_geom` -- which reads the
    hardware and sets the cell size, the row count, the font and the mirror
    every character write goes through -- was called from con_init and
    nowhere else. Its own header says it runs "whenever the editor regains
    control", which is true and is not enough: `MODE 4 : PRINT "X"` prints
    before the editor regains anything, and so does every program that sets
    a mode and draws.
    So the console kept the previous mode''s mirror, the text one. The
    characters went into the cell map, correctly, and no g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
    [interp.asm]
2026-08-12 the glyphs had no colour: black letters on a black screen in modes 2,4,5,6
    Reported after I said the modes were fixed. They were not, and the way
    I checked is the actual defect here.
    `bglyph` lights palette index 1 at 1 bpp and index 15 at 4 and 8 bpp --
    `nibtab` is $00/$0F/$F0/$FF and the 8 bpp arm writes $0F. `con_geom`
    seeded entry 1, and only inside the mode 3 arm. So mode 3 was the one
    non-text mode where anything could be seen, and modes 2, 4, 5 and 6
    drew their letters into an unseeded entry, which is black, onto a black
    screen. The text was there, correctly, and invisible; the cursor showed
    through because its inverse pair lands on entry 0. The comment in
    bglyph even says "255 is un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
    [console.asm]
2026-08-12 the boot stub was still writing to the old I/O page: no fonts, no palette
    Reported three times, and the first two "fixes" were checks that never
    looked at a pixel. This one was found by looking at pixels.
    [D67] moved the I/O page from $FE00 to $FF00. tools/ioregs.py renamed
    every literal in sw/, and tools/mkboot.py was missed -- its stub is
    assembly inside a Python string, so nothing scanning sw/*.asm could see
    it. Seven writes went on addressing $FE1E, $FE1F, $FE24, $FE26, $FE27,
    $FE28 and $FE29, which are plain RAM now. What those seven do:
    $FE1E/$FE1F the palette. Both banks, 64 bytes, never arrived.
    $FE24 the ROM monitor''s cursor, never turned off.
    $FE26-$FE29 the VRAM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
    [console.asm, mkboot.py]
2026-08-12 MODE 3 writes white again, and the cursor theory did not survive
    **Mode 3 blue text was mine.** The last commit reverted a palette
    seeding I had added on a wrong diagnosis, and took the *original*
    mode 3 seeding with it. One bit per pixel can only name palette entries
    0 and 1, and entry 1 of the boot palette is CGA blue -- correct for a
    bank whose slot meanings are kept, and the only colour mode 3 could
    then write text in. It overrides entry 1 to white, alone, as it did
    before I touched it. Verified failing without the fix: entry 1 is
    $12B, entry 15 is $FFF.
    **The cursor is not fixed and this commit does not claim it is.** The
    stale-register explanation -- con_geom sets the hardware cursor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
    [console.asm]
2026-08-12 FREE was one byte short of the banner, and nothing made them agree
    Reported from a real boot: the header says 31350 BYTES FREE and typing
    FREE answers 31349.
    prg_free computed `USERTOP - PROGEND`. USERTOP is the last byte a
    program may use, so the bytes from PROGEND to it are one more than
    that. It subtracts SYSBOT now -- the first byte that is not the
    program''s -- which gives the count directly and needs no +1 to explain.
    The interesting part is that these are two independent computations of
    one number, in two languages: tools/mkboot.py works it out in Python
    from the claims in tools/memmap.py and paints it into the boot banner;
    prg_free works it out on the machine from the SYSBOT the as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
    [prog.asm]
2026-08-12 branches collapse into main, and the cursor removal gets its design
    `asm-move-con` is merged (fast-forward, 21 commits) and deleted. One
    branch from here.
    The rest is a comment, deliberately. The hardware cursor has to go --
    it is why the cursor blinks in a stale spot after a mode change (two
    implementations, each remembering where the cursor is, disagreeing on
    the mode boundary), and it costs 40-60 of the 116 logic cells the part
    has left, which is roughly what a stride-agnostic row wrap needs to buy
    back 3K of main RAM.
    I cut it from cool8_vregs.v, cool8_pixel.v and cool8_video.v, then
    reverted: `con_blink` cannot draw a text cursor yet. In a text mode
    CMIR is `con_nomir`, a bare RET, be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
    [console.asm]
2026-08-12 the cursor fix goes the other way: keep the hardware one, delete ours
    The note committed an hour ago argues for cutting the hardware cursor
    and drawing all seven modes in con_blink. The cheaper move is the
    reverse, and I missed it because I found the cursor''s logic cells
    before I read its pipeline.
    `d2_cell <= sx1[10:3]` and `d2_trow <= vsrc[8:4]` in cool8_pixel.v are
    computed unconditionally -- not gated by `engine`. The hardware already
    knows which cell every pixel belongs to in all seven modes. The cursor
    is text-only purely because the result is applied inside the text path,
    in `lit = (font_q | cur_pix) ^ cur_inv`.
    So: move the invert to `pal_index` (eight XOR gates; an inverted palet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
    [console.asm]
2026-08-12 the cursor works in all seven modes, and costs 39 fewer logic cells
    The compare was never text-specific. `d2_cell` and `d2_trow` in
    cool8_pixel.v are computed unconditionally, not gated by `engine`, so
    the hardware always knew which cell a pixel was in. What made the cursor
    text-only was applying the result inside the text path, in
    `lit = (font_q | cur_pix) ^ cur_inv`.
    So the invert moves to `pal_index`: one XOR on the finished index, after
    the sprite has had its say, which is visible in text, tile and bitmap
    alike. The style mux and `in_lines` go with it -- the editor has only
    ever set style 3, and a cell that inverts is what a C64 draws -- and
    CUR_LINES and the style bits leave the I/O ma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
    [boot.asm, cool8_pixel.v, cool8_video.v, cool8_vregs.v, render.rs]
2026-08-12 the software cursor is deleted: 157 bytes, and one place that remembers
    The hardware draws the cursor in all seven modes now, so con_blink,
    GINV, CPHASE and the mirrors'' inverse handling had nothing left to do.
    They are gone, and with them the second implementation that remembered
    where the cursor is -- which is what made it blink in a stale spot
    after a mode change. There is one now, and it cannot disagree with
    itself.
    What went:
    con_blink drew the inverted cell for five modes
    GINV the complement bglyph and con_tmir XORed in
    CPHASE the soft blink phase
    BLB in_get''s 20-frames-a-phase timer
    con_cursor''s branch text wrot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
    [console.asm, input.asm]
2026-08-12 the row wrap is a modulo, so any stride is a legal text map
    `cool8_fetch.v` wrapped the row pointer with a mask --
    `(base & ~mask) | ((row_ptr + stride) & mask)`, mask = stride*32 - 1 --
    which is only correct when the stride is a power of two. That is the
    argument [D30] made for a stride of 256 and a 128x32 map: 8192 bytes to
    display 80x30, with 3072 of them padding that exists so the mask works.
    A compare and a subtract holds for any stride. 160 is a legal map now,
    which is what the software side needs to hand 3K of main RAM back to
    the user.
    **5,157 of 5,280 logic cells, from 5,125.** The wrap cost 32; removing
    the hardware cursor''s style mux had returned 39, so this lands 7 cells
    bette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
    [cool8_fetch.v, render.rs]
2026-08-12 the row address is cached, so it stops being per-character work
    con_emit goes through con_put and con_cell to con_row for every
    character written, and con_row answers a question whose inputs -- CCY
    and CTOP -- change once a line. Seven instructions, recomputed thousands
    of times for the same answer.
    CROWA holds the address of row CCY. The eleven sites in three files that
    move CCY or CTOP call `con_setrow`; con_cell takes the cached answer
    when the row asked for is the cursor''s and computes for any other,
    which is what con_get and con_fill need when they walk the screen. It
    takes BSPARE''s two bytes, which the deleted blink timer had just freed,
    so the packed region is undisturbed.
    **And i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
2026-08-12 the modulo wrap is reverted: the mask was also finding the map origin
    Tried, measured, and wrong -- recorded rather than quietly dropped.
    `(base & ~mask) | ((row_ptr + stride) & mask)` does two jobs. It wraps
    the row pointer, and `base & ~mask` derives the *map origin*: VID_BASE
    carries the scroll offset in its low bits and the map address in its
    high ones, and the mask separates them. Scrolling is one add on
    VID_BASE because of that second job.
    The compare-and-subtract replaced only the first. It wraps within
    [base, base+span) instead of within the map, so the map slides with the
    scroll rather than rotating inside it, and every row reads from the
    wrong address as soon as anything scrolls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
    [console.asm, cool8_fetch.v, cool8_vregs.v, render.rs]
2026-08-12 the image origin is derived, and the heap gets the space that frees
    **$A000 was written down when BASIC was 23,528 bytes.** It is 17,227,
    so 6,581 bytes sat stranded between the image and $FEFF where nothing
    could reach them -- a constant chosen for a size the software no longer
    is. tools/memmap.py derives it now and generates sw/org.asm, the way it
    already does sw/sysbot.asm: the image is top-aligned under the I/O page
    and starts wherever its size says. $BBB5 today, and it moves on its own
    whenever BASIC grows or shrinks.
    That works because the size does not depend on the origin -- [D6] left
    no short absolute form, so every operand is the same width at any
    address. Measured at $A000, $B000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
    [interp.asm, main.asm, memmap.py]
2026-08-13 the text map gets an explicit origin, so the alignment rule is gone
    The map had to start at a multiple of its own size -- eight addresses in
    the whole 64K, of which two were usable -- and the reason was that
    VID_BASE carried two things at once: the map''s address in its high bits
    and the scroll offset in its low ones. `base & ~mask` in cool8_fetch.v
    was what separated them, and a mask can only do that if the map is
    aligned to a power-of-two size. That is where [D30]''s 8192-byte map to
    display 80x30 comes from, and the power-of-two stride with it.
    The origin is its own register now, latched from the mode preset
    alongside base and stride. Not software-visible and no new I/O address:
    a scroll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
2026-08-13 the stride-160 blocker, found: nothing writes VID_MODE in the harness
    Three sessions of "the rows do not line up" had one cause, and it was
    not arithmetic.
    `sim/test_main.py` pokes the image in and jumps to `main`, so the boot
    ROM never runs and **VID_MODE is never written**. The mode preset --
    which is what carries the stride -- therefore never applies, and the
    console meets the *reset* value. With the presets at 160 and the reset
    at 256, con_row addressed rows 160 bytes apart on a display reading
    them 256 apart, and every row after the first was wrong.
    Found with the console''s own numbers rather than by reading: typing
    "AB" put the characters at $8640, which is row 10 at a stride of 160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
    [cool8_vregs.v]
2026-08-13 CSTRIDE is a name, and the screen readers stop guessing at it
    The map''s row pitch was a shift -- `<< 8` in sw/console.asm''s con_row
    and, worse, in sim/test_basic.py''s row(), a harness computing a screen
    address, which AGENTS.md forbids for exactly this reason: it cannot
    follow the map when the map changes.
    It is `CSTRIDE` now, read out of the image by the suite instead of
    written down in it, and that suite''s reader applies CTOP as well --
    it computed `(r & 31) << 8`, so it read the right rows only on a screen
    that had never scrolled.
    That, plus the reset-value fix from the last commit, gets stride 160
    to: **sim/test_main.py and sim/test_basic.py passing in full** -- the
    whole system, t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
    [console.asm, cool8_vregs.v]
2026-08-13 the text map is 5120 bytes: stride 160, and four copies of 256 removed
    It works. 19 software suites, check, cosim all, synth, test_video,
    test_vm (307,200 pixels, 0 wrong in every engine), and the bitstream
    fits at 5,141 of 5,280.
    The map is 80 cells of char and attribute a row -- the widest text this
    machine shows -- instead of 128 with 48 never displayed. [D30] chose the
    padding so the map''s size was a power of two, which the old mask needed
    to derive the map origin from VID_BASE; the origin is its own register
    now, so the 3072 bytes bought nothing.
    **The stride was written down in five places and I found them one at a
    time**, which is why this took four attempts:
    cool8_vregs.v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
    [console.asm, cool8_video_tb.v, cool8_vregs.v, machine.rs, mkboot.py]
2026-08-13 D69: the map is derived end to end, and 41,499 bytes is the ceiling
    Several architectural calls went in over the last day without the
    numbered entry this project requires, so here they are with the
    argument on both sides and the measurements that settled each.
    Four numbers stopped being written down and started being derived: the
    image origin ($FF00 minus its size, generated), the system floor (the
    lowest claim anywhere, generated), the text map''s pitch (CSTRIDE, read
    from the image rather than shifted in five separate places), and the
    heap floor (the top of the map, from CSTRIDE * 32).
    The hardware change that unlocked the last two is the map-origin
    register: VID_BASE used to carry the m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
2026-08-13 the memory is remapped: 40,448 bytes, one contiguous region
    31,350 in two pools becomes **40,448 in one**. The program grows up from
    $0200 and the heap comes down from $9FFF; everything else -- the text
    map, system storage, the image -- is packed above, in that order, and no
    longer sits in the middle of the user''s RAM.
    $0200-$9FFF 40,448 the user: program up, heap down
    $A000-$B3FF 5,120 the text map
    $B400-$B789 906 system storage, CALL stack, string accumulator
    $B78A-$BB98 1,039 BASIC''s room to grow into
    $BB99-$FEFF 17,255 the image, top-aligned, origin derived
    67 claims relocated, the map moved, the mode presets and reset values in
    both models, the boot stub, US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
    [console.asm, cool8_video_tb.v, cool8_vregs.v, edit.asm, fscmd.asm, interp.asm, machine.rs, main.asm]
2026-08-13 FREE said -25088, the monitor drew where nothing was looking
    Two [D70] regressions the suites did not catch, and both were invisible
    for the same reason: the check that covered each one had a hole shaped
    exactly like the failure.
    **FREE printed signed.** prg_free answers SYSBOT - PROGEND, at most
    31,350 while the user area was two pools. One region of 40,448 crossed
    32767 and num_put is signed, so a booted machine said `-25088 BYTES
    FREE` under a banner reading `40448`. The count was right the whole
    time. num_putu is the unsigned entry into the same digits.
    sim/test_boot_basic.py compares those two numbers and passed. It parsed
    with .isdigit(), which is False for "-25088", so the bad row w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
    [boot.asm, console.asm, cool8_mon_tb.v, interp.asm, memmap.py, monitor.asm, num.asm]
2026-08-13 a direct statement ran off its record into the image
    `PRINT 6*7` printed 42 and then `?SYNTAX`. Every direct statement that
    parsed an expression did it; FREE and LIST, which parse none, did not; a
    stored program never did. The answer was already on the screen, so the
    machine looked like it was working and complaining anyway.
    The statement loop has an inlined fast path where nextline would be --
    "nextline was 18 % of the run doing arithmetic the position already
    answered" -- and it asked "was that the staged direct line?" AFTER
    advancing LREC, so it tested the page of the record it was moving to.
    That is the same page only while a direct line begins and ends on one.
    DIRBUF sits at $B5FA, six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
2026-08-13 back out 17 bytes of guard that bought nothing
    Two things added while chasing the direct-mode fault cost image bytes
    and were not worth them. Measured by building with and without.
    **The keyword guard in prim: 10 bytes, reverted.** `PRINT FREE` reads
    the token as a variable name and answers a junk number before `?SYNTAX`.
    But FREE, CLS, NEW and LIST are statements -- they stand alone -- so the
    line is meaningless and the error is already correct. The guard does not
    even remove the number: PRINT emits before anything looks at ERR, so it
    changed 7749 to -7167 and nothing else. Suppressing it properly means
    testing ERR after every PRINT item, on the hot path of the most-used
    statement in the l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
    [interp.asm]
2026-08-13 the cursor blinks at 32 frames a phase again, not 8
    The hardware cursor came up at CUR_CTRL rate 0 -- 8 frames a phase,
    3.75 Hz -- because both writers said $01 and the rate field is
    CUR_CTRL[4:3], which nobody set. The software cursor it replaced counted
    32 frames in in_get, so the machine had never blinked faster than
    0.94 Hz and the change was obvious to anyone sitting in front of it.
    sw/console.asm and sw/boot.asm write $11: enabled, rate 2, 32 frames a
    phase. No RTL change -- the ladder already had the rate, nothing asked
    for it.
    Measured off the rendered picture on the image `poe emu` boots, hashing
    the framebuffer frame by frame rather than reading the register back:
    phase lengths 3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
    [boot.asm, console.asm]
2026-08-13 variables did not survive a direct line, and A-Z hid it
    Found while answering "what is MAXNAME" -- which turned out to be a
    question with a bug behind it.
    **Everything except A-Z was destroyed between direct lines.** `DIM Q(4)`
    then `Q(2)=77` on the next line answered ?INDEX; `A$="HI"` then
    `PRINT A$` printed nothing; `A#=1.5` then `PRINT A#` printed 0. The
    variable clear was in two halves and neither was where it belonged:
    main_pre reset HEAP and runs before every direct line as well as before
    RUN, and idrct reset NNAME. Together that is exactly the clear idrct
    documents itself as leaving out -- "irun without the variable clear:
    A-Z, arrays and the heap survive from the last run". The code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
    [interp.asm, main.asm, prog.asm]
2026-08-13 31 bytes back, and a waste table that was wrong on every line
    docs/13-basic.md offered 168 bytes "recoverable without giving anything
    up". Checked against the machine rather than re-copied, it is 31.
    **FPBASE is not dead code, it is the ABI.** sw/fp.asm's own header says
    so: the float package is meant to be loaded rather than linked ([D62]),
    so callers cannot know where anything landed and every entry is reached
    at a fixed offset from the base. Nothing referencing it internally is
    exactly what a jump table looks like from the inside. Deleting it would
    have taken SIN and SQR away from anything reached through SYS.
    **pshab and con_at were real.** pshab pushed garg as two stacked call
    argumen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
    [console.asm, interp.asm]
2026-08-13 D72: BASIC''s size is not a budget to optimise against
    Recorded as asked. The previous commit went hunting for bytes to make
    room for the next feature, and that is the wrong instinct on this
    machine: the image is top-aligned under the I/O page and grows down
    until it meets system storage, so the ceiling is wherever we put system
    storage and the text map. Moving them down gives BASIC room and costs
    user program space byte for byte, and 40,448 bytes is already more than
    a C64 hands a BASIC program. Features are decided on their merits.
    **What moving it costs was measured, not assumed, and the answer was a
    surprise.** SCREEN from $A000 to $9C00 gives the user 1,024 fewer bytes
    and BASIC exactl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
    [memmap.py]
2026-08-13 falling into END SUB ended the program instead of returning
    A SUB returned only through RETURN. `END SUB` was a marker h_sub scanned
    for when stepping over a definition, so if execution ever reached one,
    h_end ran and set E_DONE -- the whole program stopped, with the sub's
    output already on the screen and nothing to say it had gone wrong.
    END now looks at what follows it: `END SUB` is a return, a bare END is
    still a stop. Found while grounding the SUB parameter proposal, and it
    matters more with parameters, where a missing RETURN would end the
    program rather than return.
    Two checks in sim/test_basic.py, one for each half.
    17,832 -> 17,848 bytes; room to grow 446.
    Gates: 19 suites, chec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
    [interp.asm]
2026-08-13 FUNCTION retired, CLEAR added, SUB names stop colliding
    Groundwork for parameters, all three independent of it.
    **SUB names collided with float variables, silently.** subname appended
    "#" to make the name-table key, and "#" is the float suffix -- so
    `SUB FOO` and the float `FOO#` were one entry, whichever was written
    last won, and CALL jumped into the float bit pattern and did nothing at
    all. No error, no output. Measured: a SUB alone prints, a SUB beside an
    unrelated BAR# prints, a SUB beside FOO# is silent.
    "!" now, which carries no bit 7 in ctab so no identifier can end with
    it -- the same property that makes "(" work for arrays. Three sigils,
    three namespaces: none, "(", "!". Checked a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
    [interp.asm, main.asm, toktab.asm]
2026-08-13 SUB and CALL take parameters, and LOCAL
    SUB PLOT(X, Y, C$)
    LOCAL T
    ...
    END SUB
    CALL PLOT(10, 20, "hi")
    **A parameter and a local are one mechanism**: save the variable on
    entry, put it back on the way out. BBC''s shape, and nearly free here
    because every variable already lives at a fixed address -- so reading a
    parameter inside the sub costs exactly what reading any variable costs.
    No binding, no scope chain, no indirection. Recursion works because each
    level saves its own: measured 4 3 2 1 going down and 2 3 4 coming back,
    and 5! = 120.
    Semantics as chosen: formals saved then arguments evaluated and assigned
    left to right, so an argument naming one of the sub''s ow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
    [console.asm, cool8_video_tb.v, cool8_vregs.v, edit.asm, fscmd.asm, interp.asm, machine.rs, main.asm]
2026-08-13 D73, D74, and the documents catch up with the machine
    Everything outstanding, in one pass.
    ## Decisions written
    **D73 - SUB and CALL take parameters, and LOCAL is the same mechanism.**
    The design, what each choice rejected, the four older faults it exposed
    (the SUB/float namespace collision, END SUB ending the program, FUNCTION
    being a longer word for SUB, CLEAR missing), and the three register
    clobbers -- all the same shape, a routine reading a byte into R0 while
    R0:R1 held the value in flight, which is worth naming as a pattern
    rather than three times as an accident.
    **D74 - The map moved down a kilobyte, and its address lived in five
    places.** [D72] arriving: the image hit -188 bytes o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
    [cool8rsvm.py, interp.asm, main.rs]
2026-08-13 D75: TAB and SPC, and the RTL gates I owed
    The last of the three language additions, and the RTL gates AGENTS.md
    requires after touching rtl/soc/cool8_vregs.v -- which I had not run.
    **cosim all: 511 encodings, 22,638 instructions, 3 random streams, PASS.
    synth.py: 2,080 gates, 140 flip-flops, 2,920 GE against section 5.7''s
    estimate of 2,750, PASS.** The map relocation changed only constants in
    the presets, and both gates confirm it rather than my reasoning about it.
    "Run it, do not reason about whether it would pass" is the rule and I
    had reasoned.
    ## TAB and SPC
    PRINT I; TAB(8); "ITEM"; TAB(20); I*I
    **They are items in PRINT''s loop, taken before eval, and that is the
    whole design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
    [interp.asm, main.asm, toktab.asm]
2026-08-13 D76: strings order, and it cost nothing
    **They silently answered false before.** `IF A$ < "B"` on "ABC" printed
    nothing: the ordering arms called `rhs`, the *numeric* right-hand side,
    and compared whatever R0:R1 last held. Not an error, not a refusal -- an
    answer, and the wrong one. The reference said "= and <> only", so it was
    documented; a documented silent wrong answer is still one.
    ## The first implementation was 98 bytes and the right one is zero
    scmp became a three-way compare ($FF, 0, 1 -- fcmp''s convention) and
    each of <, <=, >, >= got an arm that called it. That worked, and it was
    six copies of one idea: four new arms plus the two = and <> already had.
    The smaller shape: a numer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
    [interp.asm]
2026-08-13 LEN was in the language and in no list, because it shared a line
    `PRINT LEN(A$)` has always worked and `LEN` appeared in neither
    docs/13a-vocabulary.md nor anything poe check looks at. Its btab entry
    sits on the same line as the `btab:` label, and tools/vocab.py starts
    reading *after* the label -- so the parser never made an entry for it.
    The check that refuses a builtin with no `;:` signature could not fire:
    it walks the entries the reader produced, and this was not one of them.
    Same shape as m.watch documented but absent, and as FSPBUF invisible to
    the relocation script -- a rule that only sees what it was handed.
    The entry is on its own line with a signature now, and vocab --check
    count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
2026-08-14 D77: the palette is in the bitstream, and that bought 76 logic cells
    The palette RAM came up zeroed -- 256 entries of black, including entry
    0 which is the border -- so a machine that never wrote it showed nothing
    at all. Three pieces of software wrote one to avoid that: the boot ROM's
    sixteen, the flash stub's thirty-two, and console.asm's one-entry
    override for mode 3. Three answers to "what colour is blue", and a black
    screen for the interval between reset and whichever ran first.
    cool8_pal.v reads pal.hex at elaboration now, as cool8_rom.v reads the
    boot image. Every software copy is deleted.
    ## Free, and then some
    256 x 12 bits is one EBR of 4096, allocated whether or not it has
    cont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
    [boot.asm, console.asm, cool8_pal.v, machine.rs, main.rs, mkbit.py, mkboot.py]
2026-08-14 D78: PAUSE, POS, NOT and CONT
    The four the C64 and the BBC both have and this machine did not, found
    by diffing the generated vocabulary against the C64 manual''s 71
    keywords and BBC''s own token table.
    **PAUSE n waits n frames**, not milliseconds, because `frames` is what
    the machine counts and what TIMER reports -- so PAUSE 60 and TIMER
    measure the same second. It polls ipoll rather than spinning: a wait
    that cannot be interrupted is a machine that has hung as far as anyone
    watching is concerned, and this is the one statement whose job is to
    take a long time. Measured exact at 0, 5, 30 and 60.
    **POS reads the console''s CCX**, not a count of what was printed, so it
    is right after anythin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
2026-08-14 D79: sixteen banks of sixteen, and they are published palettes
    [D77] put the palette in the bitstream and left fourteen of its sixteen
    banks black. They are filled, and the bitstream measured **5,121 logic
    cells before and after** -- a bank is EBR INIT bits and those were
    already being written. Fourteen designed palettes for nothing.
    256 entries was never one palette: a tile attribute''s low nibble picks
    a bank of sixteen, so the table is sixteen palettes and the bank is the
    unit worth designing.
    0 Softened CGA 10 Commodore 64
    1 PICO-8 11 NA16 (Nauris)
    2 DawnBringer 16 12 ZX Spectrum
    3 Sweetie 16 13 MSX / TMS9918
    4 Endesga 16 14 CGA, the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
2026-08-14 The map goes back to $9C00: FREE is 39,424 again
    **D80 took 5,120 bytes of the user''s BASIC memory and should not
    have.** The image grew 212 bytes and had 245 of slack against a 256
    minimum -- eleven bytes short -- and I answered by sliding the text map
    down 5 KB to buy growth room nobody asked for. Every byte the map moves
    comes off FREE one for one.
    The map is back at $9C00 exactly. FREE answers 39,424, as it did before
    D80. The user region, the map and system storage are all where they
    were, and rtl/, sim/tb/ and rust/src/machine.rs are byte-identical to
    their pre-D80 state -- so the bitstream is D79''s 5,121 cells, unchanged.
    ## The eleven bytes came out of dead system storage
    CSTKBU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
    [console.asm, cool8_video_tb.v, cool8_vregs.v, edit.asm, fscmd.asm, machine.rs, main.asm, memmap.py]
2026-08-14 D80: strengthen VPOS''s test, and cover the accumulator cases
    VPOS only asserted "the answer is a number", which a VPOS returning a
    constant would have passed. It is relative now: CLS, read it, PRINT a
    newline, read it again, and the difference has to be one.
    Three more, all previously probed by hand and thrown away -- which is
    the thing AGENTS.md says not to do:
    STRING$ inside a concatenation, and STRING$ of a STRING$. Both build
    in the accumulator, which is the one place they can tread on each
    other.
    A direct-mode STOP, where CONT answers ?CONT. No check was written
    for that: icsv records a line outside $0200..PROGEND and h_cont
    already rejects it as stale, so it falls out -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
2026-08-14 D81: CUR_Y is not CCY, and five bits could not say so
    **The cursor sat on the wrong line in modes 2, 4 and 5.** Reported from
    the machine, measured off the rendered frame: with CCY at 29 the text
    was at display rows 464-479 and the cursor at 232-239 -- half way up a
    screen whose text was at the bottom.
    con_cursor wrote CCY into CUR_Y raw and the two are not the same unit.
    The hardware counts a cursor row as 8 display lines wherever the line
    doubler is on and 16 where it is not, while the console''s own row is 16
    in every mode but 6. So the cursor moved half a row per row of text.
    modes 0, 1, 3 cursor row 16 lines console row 16 x1
    modes 2, 4, 5 cursor row 8 lines console row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
    [console.asm, cool8_pixel.v, cool8_video.v, cool8_vregs.v, machine.rs]
2026-08-14 D81, redone: one divisor, because a console row is always 16 lines
    The committed D81 put the cursor on the right row and left it **half
    height**, which was the actual complaint. Scaling the row number cannot
    change the cell''s height. This replaces it.
    d1_trow chose its divisor on the line doubler:
    d1_trow <= c_vdbl ? {1''b0, vsrc[7:3]} : vsrc[8:4];
    so a cursor cell was 8 display lines in modes 2, 4, 5 and 6 and 16
    elsewhere. **There was nothing to choose.** Every mode''s console row is
    16 display lines -- 30 over 480 in modes 0-4 and 6, 24 over 384 in mode
    5 -- because the doubler stretches source lines and the console halves
    its glyph height to match, so a row''s display pitch never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
    [console.asm, cool8_pixel.v, cool8_video.v, cool8_vregs.v, machine.rs, render.rs]
2026-08-14 D81: withdraw the mode 6 glyph-height claim, record the mode switch
    **The claim was made by a probe that could not see a glyph.** It used
    B.Machine, which pokes the image in and jumps to main, so the boot stub
    never runs -- and the stub is what uploads the fonts into VRAM. There
    were nothing but blank bitmaps in every graphics mode. What the probe
    read as "text" was the cursor, or nothing at all.
    Every mode looks right on the machine. A confident conclusion from an
    instrument that cannot observe the subject is the same shape as
    .isdigit() filtering out the negative FREE, and as the suite that
    compared two programs against a third private model of the I/O page. A
    glyph-height question needs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
2026-08-14 The DSP block: chased, priced at 8 cells, and closed
    The design uses no DSP. cool8_pixport.v''s header claimed one of the
    eight SB_MAC16 blocks for `y * stride`, cool8_snd.v said "seven sit
    idle", and 00-goals.md and README both counted 1. All four were wrong.
    tools/mkbit.py does pass `synth_ice40 -dsp`. ice40_dsp **checks this
    multiply and declines it**: it maps when cool8_pixport.v is synthesised
    alone and not when the design is flattened around it.
    ## Priced before forcing it
    Replaced the multiply with a shift and rebuilt:
    with the multiply 5,183 cells
    without it 5,175
    the multiply **8 logic cells**
    yosys is already reducing it far below a general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
    [cool8_pixport.v, cool8_snd.v]
2026-08-14 @ D82: review found two faults, and the layering decided where one goes
    Neither showed up in the eight tests that already passed.
    ## The stream did not shut on the last byte, and the comment said it did
    It shut on the first read *past* the end, so a program that read exactly
    its file and stopped held the flash open. The comment claiming otherwise
    was the only thing anyone would have checked. Ten bytes to make the
    sentence true: read the byte, then close if the count reached zero.
    ## And nothing shut it on RUN
    A stream opened in direct mode survived into the program, so a program
    inherited one it never opened and leaked the flash on every re-run.
    **The fix is in main.asm and not in h_run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
    [fscmd.asm, main.asm]
2026-08-14 D83: the small fixes, and one that was not a gap at all
    211 bytes, image 19,264 -> 19,475.
    ## A narrower mode stranded the cursor -- 31 bytes
    Mode 5 is 24 rows where every other mode is 30, and modes 5 and 6 are 32
    columns where mode 0 is 80. Nothing clamped CCX/CCY on a mode change, so
    a cursor at row 29 was outside mode 5''s display: the hardware never drew
    it and the editor went on writing where nothing was shown.
    Clamped in con_geom, not h_mode -- that is where the new geometry
    becomes true, and con_init, con_warm and a warm restart into whatever
    mode a program left need it just as much. con_setrow follows, because
    CROWA caches the row address and would otherwise put the next characte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
    [console.asm, interp.asm]
2026-08-14 D84: the pixel gate had no cursor, and found a bug the hour it did
    AGENTS.md calls sim/test_vm.py normative -- rust/ and rtl/ checked
    against each other **pixel by pixel**. It rendered a text screen, a tile
    screen, sprites over a bitmap and the sound engine, and **never a
    cursor**.
    That is the hole D81 fell through. d1_trow chose its divisor on the line
    doubler, render.rs made the identical choice, and the two models agreed
    all the way to the screen while both were wrong. Cosim compares retired
    instructions and cannot see a pixel; this compares pixels and was never
    shown the cell. A gate cannot catch a shared assumption about a thing it
    does not draw.
    cool8_video_tb.v has rendered a cursor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
    [render.rs]
2026-08-14 Every mode is gated pixel by pixel, not two of seven
    FRAME_DUMPS named three frames -- mode 0, mode 2 and the sprite
    bitmap -- so the "pixel by pixel" guarantee AGENTS.md makes for rust/
    against rtl/ covered two of the seven modes. D84 showed what lives in
    that gap: adding one frame found a real divergence within the hour.
    Nine frames now. Mode 1 through the doubler, and modes 3, 4, 5 and 6 --
    one VRAM fill read at four depths, so what varies is bpp_log and the
    doubler and a divergence in any of them shows against a background the
    other three agree about.
    **2,764,800 pixels, 0 wrong.** The two models already agreed on modes 1,
    3, 4, 5 and 6: the gap was real and only the cursor was hiding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
2026-08-14 Documentation sweep, part two: the last six files
    Checked mechanically where the claim was checkable, rather than read.
    ## 02-isa section 8 claimed a cross-check that does not run
    It said the RTL, tools/opcodes.py:cycles() and the emulator''s
    accounting were "all three checked against each other". They are not:
    sim/timing.py is not in the runner, and cosim cannot stand in for it --
    the verification contract counts interrupt injection in *retired
    instructions* precisely because the two models are not expected to agree
    on a cycle.
    So a cycle count is the one number in this project with three copies and
    no gate, and the AGENTS.md discipline -- touch the control FSM, run
    `poe timing`, update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
2026-08-14 @ D82: GET$, a line-oriented read in thirty-two bytes
    The last of data files, and it is **a loop around BGET**: fetch, stop at
    CR, append, repeat. BGET already counts the byte down, answers -1 past
    the end and shuts the stream on the last one, so the line reader has
    nothing left to decide but where a line stops.
    One call per character, which is slow and is the point. What a program
    has without it is `A$ = A$ + CHR$(BGET)`, and that recopies the whole
    accumulator every character -- 3,200 byte moves for an 80-column line --
    where this appends in place. Slower than a block read, far faster than
    the BASIC it replaces, short enough to be obviously right.
    **LF is skipped rather than ending a lin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
    [fscmd.asm, interp.asm]
2026-08-14 @ D85: ON ERROR GOTO and ERR, in 134 bytes
    Cheap for a structural reason, not a clever one. **The interpreter
    unwinds a fault by returning** -- stmt sees ERR and returns, and every
    loop, CALL frame and nested expression unwinds the same way until
    main_err prints. So by the time an error is visible where it could be
    caught, the CPU stack is already back at mains level: trapping needs
    no longjmp and no saved SP, only a line number.
    And the jump existed. `goton` is GOTOs own tail -- prg_find, LREC,
    openline, ipoll, JMP stmt -- and stmt returns when the program stops, so
    CALL goton reads as "run from this line until it ends" and a loop around
    it catches whatever it ends with.
    ## Left out on pu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
    [interp.asm, main.asm, toktab.asm, zp.asm]
2026-08-14 @ D86: the colon is seven bytes, because the loop was always there
    `A=5:PRINT A` works. So does `A=5 PRINT A`, and **it always did** --
    which is the finding, not the feature.
    `stmt` is a loop over *statements*, not over lines. A handler ends in
    JMP stmt; stmt skips spaces, and only a zero byte sends it to the next
    record. Several statements on a line have run since the statement loop
    existed. What did not work was the colon: `:` is below $80, so it fell
    through the token test into h_let, which read it as a variable name.
    Punctuation, not a token -- stored as itself, no slot in TOKTAB, and
    LIST gives it back for nothing: `10 A=1:PRINT A:REM HI` round-trips.
    ## The semantics were already ri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
    [interp.asm]
2026-08-14 13-basic section 11: the colon note was still pre-D86
    The known-wrong list still explained that `A=5:PRINT A+1` answering
    ?SYNTAX was correct because there is no `:` separator. There is one now,
    and the more interesting half is that `A=5 PRINT A+1` had worked all
    along -- stmt was already a loop over statements rather than over lines.
2026-08-14 @ D86: the colon broke seventeen statements, silently
    `cnext` is nextline + stmt -- it abandons the rest of the line.
    Seventeen handlers ended that way, and while nothing could follow them
    that was free. The moment `:` became legal, `CLS:PRINT 1` dropped the
    PRINT with no error and no clue.
    The rule is exact: **cnext is only for statements that moved the program
    under the interpreter.** DELETE, RENUM, a program LOAD and a MERGE
    rewrite the records LREC points into, so carrying on from where we stood
    would run whatever landed there. The other thirteen leave the program
    alone and now end in JMP stmt, which continues on the line and reaches
    the next record by itself. Same size -- the two jumps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
    [fscmd.asm, interp.asm]
2026-08-14 @ D87: SYS "name" -- a binary carries its own address
    `SYS "GAME.BIN"` loads a file and jumps into it. 91 bytes, image
    19,598 -> 19,689.
    **The first two bytes of the file are where the rest goes**, low byte
    first -- the C64s PRG format, and it transfers exactly because this
    machine is little-endian like the 6502 it comes from. A released binary
    needs no accompanying number: the address travels with the code.
    Before this, starting a shipped game meant a BASIC stub --
    `10 LOAD "GAME.BIN" AT $3000:SYS $3000` -- with the address typed twice
    and correct in both places. That still works and is still right for
    something wanting a BASIC front end. This is the one-liner for the rest.
    ## It is fs_l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
    [fs.asm, fscmd.asm, main.asm]
2026-08-14 D87 reviewed: six bytes smaller, and a guard it did not have
    Three findings, and the arithmetic is the point.
    **Copying X into Y cost four MOVs through R0.** PUSHW X / POPW Y is the
    same move in two bytes -- and the address is being pushed anyway, so it
    is one extra push and a pop rather than eight bytes of shuffling.
    **Y was popped and immediately pushed again** around the jump. Pushing
    it *under* the address means one save covers both the load and the code
    being run, and X comes back out from over it.
    **A file shorter than its own two-byte header** wrapped the count to
    65,534 and poured it over the interpreter. I put the guard in after the
    pushes first, which cost thirteen bytes of stac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
    [fscmd.asm]
2026-08-14 @ The documents catch up with the afternoon
    This mornings audit found seven of thirteen documents carrying wrong
    headline figures. Four of them drifted again during the work that
    followed, which is the same lesson at a shorter interval: a number
    written in prose goes stale the moment the thing it describes moves.
    04-system.md the memory map was still pre-D82: the map moved down a
    kilobyte and FREE went 39,424 -> 38,400 with the users
    agreement, and the table did not follow. All five rows
    are current and the note says why it moved and that
    standing rule 5 governs the next one.
    00-goals.md 5,183 cells -> **5,098**.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
2026-08-14 @ The demo disc, and 10 PRINT on it
    Drive 13 of sixteen is the demo disc -- 0 to 12 stay the users and 14
    and 15 are the system discs, so a machine out of the box still has drive
    0 and a demo disc is not somewhere a user overwrites by accident.
    ## The sources are the truth and the disc is derived
    tools/mkdemos.py formats the volumes, **types each demos/*.bas at the
    machine**, and lets SAVE write it. It types rather than tokenises
    deliberately: a program on disc is tokenised and the only thing that
    knows the token table is sw/token.asm, so a host-side tokeniser would be
    a second implementation of it and would drift the first time a keyword
    was added. That is the trap AGENTS.md names first.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
    [mkdemos.py]
2026-08-14 The C64 palette in the C64s order, and one key()/settle()
    ## Bank 10 was the right colours at the wrong indices
    lospec sorts its commodore64 list by tone, so its entry 6 is a brown and
    its 14 a dark blue. On a C64 colour 6 *is* blue and 14 *is* light blue,
    and a program that says 6 means blue. A palette named after a machine
    has to answer to that machines numbers or it is only a swatch. Values
    from c64-wiki, the VICE/CCS64 set, in index order.
    ## key() and settle() had two copies, and mkdemos wanted a third
    They live in sim/harness.py now and sim/test_boot_basic.py imports them,
    which is what AGENTS.md means by not writing a second implementation of
    a shared thing. The demo builder uses t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
    [mkdemos.py, palette.py]
2026-08-14 An unpainted cell is blank too, and one byte fixed it
    ## The bug
    `ed_read` rebuilds a logical line by reading back the cells the console
    painted, and trims trailing blanks by testing for `$20`. **A cell the
    console has never touched holds `$00`, not `$20`.** So the first line
    typed onto a row with unpainted cells took the whole 80-column row into
    the record: `190 PRINT 1` stored 74 bytes instead of 5, the extra being
    the rest of the screen row.
    It needed the screen to scroll, which is why it took forty lines to see
    and why it looked positional rather than content-dependent -- forty
    *identical* lines reproduce it, lines 190 and 200 and no others.
    **Nothing showed it.** LIST was right, RUN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
    [edit.asm, mkdemos.py]
2026-08-14 The emulator window keys were in a source comment, and wrong
    F1 is the warm restart. The comment above the table in rust/src/emu.rs
    said "F9 and F10 send the chord's raw scancodes" while the table three
    lines up said F1 and the code at the bottom matches F1 -- so the one
    place a person looks for the restart key named a key that does nothing
    but send scancode $01 to the machine.
    They were also nowhere in docs/, which is where AGENTS.md says the truth
    lives, so there was no second place to check. They are in
    docs/12-tasks.md now, next to the commands that open the window, with
    the reason F1 and F10 exist at all: Windows keeps Ctrl+Esc and
    Ctrl+Shift+Esc, so the emulator injects their scancode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
    [emu.rs]
2026-08-14 The diagonal is the C64s own glyph, and the maze joins up
    ## Why it was broken
    CP437 has no diagonals where PETSCII has 205 and 206, so the text
    version drew `/` and `\` at 47 and 92. **Those glyphs have side
    bearing**: they stop short of the cell edge, so every join in the maze
    broke and the picture was a field of dashes rather than a maze. The text
    font is 4 KB of EBR read by the hardware -- ROM, not redefinable -- so
    mode 1 could not be fixed, only left.
    Mode 2 is the same 40x30 geometry with the pattern in RAM. Same square
    16x16 cells, same C64 palette in bank 0, same blue paper and light blue
    ink; the only thing that changes is where the glyph comes from.
    ## The glyph is transcribed,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
2026-08-14 10 PRINT scrolls, and the hardware does it
    The tile map is a ring 32 rows tall with 30 shown, so scrolling is not a
    copy: `VID_SCY` steps the eight pixels inside a tile and one stride onto
    `VID_BASE` steps the row, masked back into the ring with `AND W-1`
    because software wraps the base and the hardware only wraps its own row
    pointer inside it (04-system.md 5.5).
    It draws the row it is **about to need** and then scrolls onto it, so
    the first 31 draws fill the screen and the row below before anything
    moves and no row is ever shown before it has been drawn.
    `MODE 2` leaves VID_BASE at 0 and VID_STRIDE at 128. Both were measured
    off the machine rather than assumed, and the demo reads the stri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
2026-08-14 The mask is gone from the scroll, and three documents still taught it
    Asked whether the video chip needs anything cheap added. Reading it says
    no, and says two things that were already there had been missed.
    ## Nothing to add
    **5183 of 5280 logic cells, 98 %** -- about 97 free. Everything obvious
    is already priced in 04-system.md 5.11: a blitter 500-700 LUT4, a line
    drawer 200, a second layer 250-400. Whole-tile scroll registers were
    rejected outright ([D35]) because the coarse step is one add, and a
    palette sequencer because a vblank handler is more flexible. None of it
    fits and none of it is the bottleneck -- BASIC is.
    ## Two things already in the chip
    **VID_IRQ bit 1 is a vblank flag*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
    [cool8_fetch.v]
2026-08-14 The coarse step goes with fine step 0, and the shudder was mine
    The RTL is fine. Driving VID_SCY from outside, with BASIC out of the
    loop, moves the picture exactly -2 pixels per step for all eight steps
    with zero mismatch, so tile fine scroll does what it says.
    ## What was actually wrong
    **Both VID_BASE and the tile row offset are sampled at frame start, and
    the vblank flag sets at that same instant.** So by the time software
    sees the flag the latch has happened and everything it writes lands on
    the *next* frame -- both alike. The pair of values belonging to one
    frame therefore has to be written into one gap, which means the coarse
    step goes with **fine step 0**.
    I had it on fine step 7.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
2026-08-14 A fine scroll touches 31 rows, so only one is safe to draw in
    ## The row being drawn was on screen
    Thirty rows of sixteen are the whole 480 lines, so **any non-zero
    VID_SCRL_Y shows the bottom of row B and the top of row B+30** -- the
    window touches 31 rows, not 30. Of a 32-row ring that leaves exactly one
    row off screen, B+31, and it is the only one software may draw into.
    The fill was 31 rows, which put the draw one row early: into B+30, the
    part-shown one. Every new row was then built in full view along the
    bottom edge, which is what showed. Fill 32 and the phase is right.
    Measured by aligning consecutive frames on the scroll and counting what
    still differs, middle band against bottom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
2026-08-15 The taskbar toolkit, pinned exactly, and SDL2 keeps its job
    Dear ImGui rather than egui, for a reason that is checkable rather than
    a preference: **egui does not compose at current versions.** egui is
    0.36.1, `egui_sdl2_gl` pins egui ~0.33, and `egui-phosphor` wants ^0.35.
    Three ways apart, and the only resolution is pinning egui backwards,
    which is the opposite of running current.
    imgui =0.12.0
    imgui-sdl2-support =0.13.0 -> imgui ^0.12.0, sdl2 ^0.37
    imgui-glow-renderer =0.13.0 -> imgui ^0.12.0, glow ^0.14
    glow =0.14.2
    All from the imgui-rs org, released together, and the SDL2 support crate
    asks for **sdl2 ^0.37 -- the version this cr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
2026-08-15 A cold machine comes up on drive 1, and every volume exists
    ## Volume 0 is the ROMs, so the user starts on 1
    `sw/boot.asm` walks volume 0 for BOOT.BIN and cannot be told otherwise --
    it is the 4 KB part a board cannot reflash, identical on the bench and
    on the board. Coming up on 0 put every unqualified SAVE beside the file
    the machine boots from.
    **FSDRV was never initialised anywhere.** It inherited the zero the
    cold-start RAM wipe leaves, which is how volume 0 became the default by
    accident rather than by decision.
    `fsc_init` sets it, and it lives in fscmd.asm beside FSDRV and
    fsc_mount rather than in `main`, which only composes ([D68]). It cannot
    go in the ROM at all: `main` wipes eve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
2026-08-15 A taskbar on the window, and nothing here draws a widget
    Buttons for the keys this front end keeps, each with its shortcut and a
    line of description under the pointer; a menu of every program on every
    disc; fullscreen, which has no bar.
    ## The toolkit does the widgets
    Dear ImGui through `imgui-sdl2-support` and `imgui-glow-renderer`, with
    Phosphor (MIT, vendored) merged into its font atlas -- so an icon is a
    character in a string. rust/src/bar.rs decides what the bar holds and
    what each control does to the machine; it draws nothing and packs no
    glyph. The codepoints are read out of Phosphor's stylesheet, not
    guessed.
    **SDL2 keeps every job it had** -- window, speaker, clipboard,
    scancodes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
    [bar.rs, cool8disk.py, cool8rsrun.py, emu.rs, main.rs]
2026-08-15 The launcher waits on the machine, not on a stopwatch
    The play button counted 200 frames and then typed, which is either too
    slow or -- on a machine whose boot ever gets longer -- wrong.
    ## The cursor is the wrong signal, and checking said so
    `sw/boot.asm` enables the hardware cursor for the **ROM's** loading
    screen, so a blinking cursor means the ROM is alive, not that BASIC is
    listening. Nothing after that turns it off and on again.
    ## There is already a definition of ready, and it is server-side
    `settle` -- the suites' idle test, in Rust because it polls per
    instruction. Nothing waiting in the UART or the keyboard, the input ring
    drained, the CPU sitting at its keyboard wait.
    It is `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
    [cool8rsrun.py, emu.rs, machine.rs, main.rs]
2026-08-15 A frame counter in silicon, because the period counted them in software
    ## How they did it then
    Every machine of the era counted time by counting the vertical blank,
    and every one of them counted it **in software**: the C64s TI, the
    Spectrums FRAMES, the Ataris RTCLOK, each incremented by an interrupt
    handler. Which is why TI stops on a C64 during tape and disk work -- no
    interrupt, no time. The C64 also carried a real time-of-day clock in the
    CIA, BCD with an alarm, which is the expensive answer to the same
    question.
    ## So this counts them in hardware
    TMR_L/TMR_M/TMR_H: 24 bits of frames since reset, on the same
    `frame_start` the vblank flag and the cursor blink already use. 24
    flip-flop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
    [cool8_vregs.v, machine.rs, main.rs]
2026-08-15 GOSUB, in 29 bytes, because RETURN already knew how to come back
    BM5 to BM7 of the Rugg/Feldman set need GOSUB and this BASIC had only
    `SUB`/`CALL`. Writing the benchmarks with `CALL` instead would have
    produced numbers that look comparable with the published ones and are
    not, so the language gets the statement.
    ## It costs 29 bytes because nothing new was invented
    The call frame is five bytes -- resume Y, LREC, and **the save depth to
    unwind to**. A GOSUB frame records the depth *unchanged*, so its unwind
    does nothing and `h_ret` pops either kind without being told which. That
    was read before it was claimed, not assumed.
    So GOSUB is CALL's frame and GOTO's jump, and the push both use is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
2026-08-15 PRINT A;: is not a syntax error, and the benchmark that found it
    ## The parser bug
    `PRINT A;:GOSUB 100` raised ?SYNTAX. After a `;` or `,` the item loop
    tested only for *zero* -- end of line -- and sent everything else back
    to `eval`, which was then handed a statement separator. So a trailing
    separator worked at the end of a line and failed the moment a second
    statement followed on the same one, which is why nothing had hit it:
    that shape only turns up when you are printing a label and then calling
    something, which is exactly what a benchmark harness does.
    Two instructions, and gated in sim/test_interp.py.
    ## demos/bench.bas, and it is not finished
    The Rugg/Feldman set BM1-BM8, published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
    [interp.asm]
2026-08-15 The benchmarks run, and the machine is slow where GOSUB is
    BM1-BM8 as published, timed on the frame counter, against the machines
    they were written for. The listings inside the timing are unchanged: the
    repeat loop is outside them and `THEN GOTO` is the one edit.
    ## Two rows, and the second is the honest one
    COOL8 is 8.375 MHz and most of that table is 1-2 MHz, so the second row
    is every time multiplied by 8.375 -- what it would score clocked like a
    6502. It beats a C64 on the arithmetic loops and **loses badly on BM5 to
    BM7**, which is exactly where GOSUB and arrays are. That is a real
    result and it says where to look if the interpreter is ever worth
    optimising.
    Every figure is from one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
2026-08-15 COLOR takes PALETTEs dead token, and the pen becomes a variable
    ## CATTR: the console had one colour, hardcoded, in two places
    `A_TEXT = $07` was a constant at both places the console writes an
    attribute, so nothing the machine printed could be any colour but light
    grey. It is a variable now, and `con_fill` reads it too -- so CLS and a
    scroll paint in the current paper rather than reverting.
    **It lives in the image, not the storage region, which is [D67]s
    direction reversed on purpose.** The region is packed solid to $AE6A and
    its floor is computed from the claims, so a claim there comes out of the
    user's FREE -- and out of *two* bytes, because a cell is a char and an
    attribute and an odd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
    [console.asm, interp.asm, main.asm]
2026-08-15 CURSOR, and the break gives it back -- found by tracing, not guessing
    CURSOR on[, rate] takes SPRITE's dead token: 0 off, 1 on, rate 0-3 for
    8, 16, 32 frames a phase and solid. **Nothing in software blinks
    anything** -- `blink_r` counts frames in cool8_vregs.v and the rate
    picks which of its bits to test, and the phase restarts whenever the
    cursor moves, which is what keeps it visible while a key is held. One
    byte to CUR_CTRL and the hardware does the rest.
    The demos stop poking $FF24 and say `CURSOR 0`, which is the point of
    adding it: a statement instead of an address in every program.
    ## A break gives the cursor back
    A program can turn it off, and a break is **not** a warm restart -- t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
2026-08-15 COOL8 in purple, and a progress marker that is not in the measurement
    ## The banner
    The boot banner already carried an attribute a line, so COOL8 is entry
    13 -- bank 0s purple -- and nothing else about the boot changes.
    ## The progress marker
    Each benchmark now times its three passes **separately** and adds them
    up, so the `#` that appears after each pass goes out **between** timed
    spans and never inside one. That was the constraint: the display must
    not be in the measurement.
    `H#` accumulates, `9500` averages once at the end. The old shape timed
    the whole repeat loop as one span, which left nowhere to print from.
    ## Three mistakes worth naming, all the same shape
    The rewrite script ma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
    [mkboot.py]
2026-08-15 The banner cyan back, measured against the screenshot that has it
    `docs/img/readme-editor.png` was shot before any of this, and the
    question was whether its colours are PICO-8 and whether the palette has
    drifted lighter since. **Neither.** Read with Pillow and matched against
    tools/palette.py, all six of its colours are bank 0, Softened CGA -- and
    two of them, $556 and $7EE, exist in bank 0 and **nowhere else** in the
    256 entries, so the identification is not a coincidence of shared greys.
    PICO-8 is bank 1 and accounts only for the black.
    So there was nothing to change in the ROM palette: the image already
    shows the palette the machine runs.
    Rendering the current boot screen through the ha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
    [mkboot.py]
2026-08-15 A verified memo in prg_find, and zp.asm was never a zero page
    ## The memo
    Every GOTO and GOSUB walked the program from PROGBOT, so their cost grew
    with how far in the target sat. `prg_find` remembers the last line it
    resolved and where it was, in four bytes.
    **It is verified, not invalidated.** The record at the remembered
    address must still carry the remembered number, checked on every hit, so
    an edit, a RENUM, a DELETE or a LOAD cannot leave a stale pointer -- a
    moved line fails the check and falls through to the search. The version
    that clears the memo instead needs six paths to be right; this one needs
    none, and a missed one there is silent corruption rather than an error.
    Only an exa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
    [asm.asm, cool8asm.py, fp.asm, fpbas.asm, fs.asm, input.asm, interp.asm]
2026-08-15 A Mandelbrot that finishes: Q6 fixed point and Mariani-Silver
    Mode 6, 128x120 computed as 2x2 blocks, 64 iterations, on the VM.
    ## Integer, because a float op costs five times an integer one
    Q6 -- 64 units to 1.0 -- is the largest scale whose products still fit a
    signed 16-bit word: `zx*zy` peaks at 16,384, where Q7 would reach 65,536
    and overflow. Two details are load-bearing:
    `A*B/32` and not `2*A*B/64`: same value, and the doubled form peaks at
    32,768, over a signed word by one.
    **The escape is tested before squaring.** A value that has just escaped
    can be four times the bound and squaring it overflows, so the test is
    |zx|>2 or |zy|>2 and the squares are skipped on the way out -- a sq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
    [mkdemos.py]
2026-08-16 The window was lightening every colour, and the Mandelbrot was invisible
    Both found by the user looking at the screen, which is the one check I
    cannot run.
    ## sRGB, applied once too often
    `AutoRenderer::new` passes **output_srgb=true**, so its shader puts a
    linear->sRGB curve on everything it draws. SDL hands us a plain
    framebuffer that converts nothing itself, so the curve landed once too
    often and every colour came out lighter than the machine made it.
    That is why a window capture and a frame grabbed out of memory
    disagreed: the PNG path never touches the shader. The palette was exact
    the whole time -- measuring it against docs/img/readme-editor.png said
    so, and I read that as "nothing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
2026-08-16 @ The blue band was the framing: a 1.5-unit step, not 2
    A step of two Q6 units over 128 columns forces a view exactly 4.0 wide,
    and the set is 2.25 across -- so a quarter of the picture sat outside
    it, every point escaping on the first iteration, one flat blue band down
    the left. Not a rendering fault; the view was simply too wide, and I
    chose that width because two units divides evenly.
    `I*3/2` is integer as well, and steps 1,2,1,2 -- 1.5 on average. That
    gives 2.97 across by 2.81 down against a 512x480 display area, which is
    the set and very little else, correctly proportioned.
    It samples finer as a side effect, so more escape counts actually occur
    and the colour count went from 45 to 50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
2026-08-16 A sine sweep with a gradient trail, and LINE was the whole answer
    WAVE: a full-width horizontal line follows a sine down mode 6 and
    leaves a 64-line trail -- newest white, the one before it aged into a
    cyberpunk ramp, the oldest erased from a ring.
    The first version drew its spans by hand, on the strength of a real
    measurement: PIX_DATA auto-increments X, so a horizontal run is one
    store a pixel and a vertical one is three -- 27 frames against 88 for
    twenty 192-pixel spans. It ran at four iterations a second. The profile
    says why: h_poke was 3.9% of the clocks and prim/stmt/erel/eval were
    64%. BASIC was not storing pixels, it was parsing statements about
    storing pixels, and the direction of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
2026-08-16 A second memo slot: 2.6x on BM5-BM7, and 48 bytes off FREE
    prg_find remembered one line. The inner loop of BM5-BM7 is `GOSUB 2`
    then `GOTO <head>` -- two targets at opposite ends of the program --
    so the two evicted each other on every pass and a one-slot memo did
    not merely fail to help: it paid for a check that never hit and then
    walked from PROGBOT anyway.
    Isolated, that loop is 104 frames; the same loop with the GOSUB removed
    is 31. So the call was costing 73 frames, of which the call itself was
    8 and the other 65 were the eviction making every GOTO re-walk ~60
    records. With a second slot the loop is 39.
    In the demo's table, where COOL8 is pinned at 100 and every other row
    rises as it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
    [lowram.asm, prog.asm]
2026-08-16 The sine was never a sine: a float stored in an integer is not converted
    The trail came out as stripes with black between them, because the sine
    was sampled uniformly in phase: it crawls at the turning points and
    moves eleven rows a frame through the middle. The sine now supplies the
    timing rather than the position. With amplitude 110 a one-row step needs
    a period of at least 2*pi*110 ~ 691 frames, so the table is 720 entries
    and the head visits every row of 10-230 without skipping one. Measured
    on the running demo: 0 background rows inside the band, at every sample
    from 2 s to 18 s.
    The ring buffer is gone with the stripes. A head that visits every row
    repaints the whole screen each sweep,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
2026-08-16 D88: a float crossing into an integer converts, implicitly
    `A = 110 * SIN(X#)` put 2 in A and `A = 120 + 110 * SIN(X#)` put -6654.
    The expression was right up to the moment it was stored -- PRINT of
    either printed 110 and 230 -- because the integer store took whatever
    eval left in R0:R1, which for a float is not a value at all. It floors
    now, through the same ftoi that INT() uses, so writing INT() by hand
    changes nothing.
    16 bytes, image 19,915 to 19,931, at seven doors: both assignments
    (scalar and array element), both of POKE's operands, and FOR's start,
    limit and step. evali is one routine because this was already the
    fourth site wanting the sequence -- INPUT's .num and INT()'s iint are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
2026-08-16 The launcher says what it is running; the relax count stops shouting
    "44 branches relaxed in main.asm" opened every suite, every demo build
    and every emulator launch, because it was printed from sim/harness.py's
    library build path rather than from the assembler's own command. Its
    comment said "nothing relaxes today, so this stays quiet until
    something does" -- forty-four do, and it had been shouting ever since.
    `python tools/cool8asm.py <file>` still reports it, which is where
    someone is asking about an image rather than using one, and --pressure
    is the fuller question.
    In its place cool8rsrun.py opens with what a person launching a machine
    cannot otherwise see: version and git describe, th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
2026-08-16 The leading line was half-drawn two frames in five
    Mode 6 uses 61,440 of 64 KB of VRAM, so there is no second page to flip
    to: the machine is single-buffered, and LINE walks Bresenham left to
    right over a real slice of the frame. The loop drew both spans and then
    waited for VSYNC, so the white line finished about 6 ms into the frame
    and the raster crossed that row while it was still being walked -- left
    half white, right half still the trail colour.
    Measured over 300 frames, sampling the same way in both:
    old 174 full-width, 122 partial, 4 absent (partial 41%)
    new 300 full-width, 0 partial, 0 absent (partial 0%)
    VSYNC moves ahead of the drawing so a frame starts with the pen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
2026-08-16 D89: LINE takes the horizontal case out of Bresenham -- 10x
    LINE 0,y,255,y,c cost 6.4 ms, which is 209 cycles a pixel, while CLG
    filled 61,440 pixels at 10 cycles each on the same memory path. The
    hardware was never the limit; the general algorithm was.
    Its inner loop calls pixxy, which writes PIX_X_L, PIX_X_H, PIX_Y_L and
    PIX_Y_H from garg -- eight loads and stores -- then stores the colour,
    then compares four 16-bit quantities against the endpoint, then updates
    two 16-bit error terms. Per pixel. For a horizontal span X only ever
    increments and Y never changes at all.
    **And PIX_DATA auto-increments X in hardware.** The one piece of
    acceleration the video chip offers for exactly this case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
    [cool8rsrun.py, interp.asm]
2026-08-16 poe demo: rebuild the disc and boot it, in one command
    The disc goes stale every time sw/ changes, and the launcher's own
    staleness check has now told the user to run `poe demos` three times in
    one session. `poe demo` does both:
    poe demo == cool8rsrun.py --rebuild --flash sim/build/demos.img
    --rebuild picks the builder from the target: demos.img goes to
    mkdemos.py, anything else to flash.py.
    **--no-shots on mkdemos is what makes it usable.** mkdemos normally runs
    every demo for twelve chunks of 500M cycles to photograph it, which is
    minutes; skipping that leaves typing the sources onto the disc, which is
    not. The pictures are for 14-demos.md, not for booting.
    **A flag, deliberately,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
    [cool8rsrun.py, mkdemos.py]
2026-08-16 H.line: a line of BASIC in one round trip, and the disc in 2.5 s
    mkdemos typed every character at the keyboard, which is a round trip
    each, because the PS/2 queue is sixteen deep and a key is two scancodes
    -- a line cannot be delivered in one go and the harness settles after
    every one. Ninety seconds to put five demos on a disc, nearly all of it
    waiting. **It is 2.5 s now.**
    **The machine still tokenises.** H.line writes the text where ed_read
    would have left it and enters ed_inject -- ed_enter without the screen
    scrape -- so sw/token.asm remains the only thing that turns BASIC into
    tokens, which is what 14-demos.md section 2 protects. Nothing on the
    host knows what PRINT is worth. ed_injec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
2026-08-16 The suite is 29 s, not 129, and neither cause was the one I guessed
    Four hypotheses were offered before anything was measured -- cmd()'s
    cursor walk, re-assembling per job, a server process per case, and
    splitting the one long job. All four were real costs. None was the
    answer. One cProfile run found it in a minute:
    14,278 calls 46.5 s self 100.0 s cumulative ioregs.registers()
    **registers() globs rtl/ and walks every line of every file, on every
    call.** It was written for once-per-run use -- `poe check` verifying the
    map, a tool resolving a name at start-up. Then Machine.row() grew a call
    to `ctrl`, `ctrl` resolves its register by name through `addr_of`, and
    `addr_of` calls this: on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
    [ioregs.py]
2026-08-16 BM5 is the published listing again: GOSUB 9000, and it is not slower
    CALL/SUB was a fair adaptation for as long as this BASIC had no GOSUB --
    a SUB is found once at RUN rather than searched for per call. GOSUB
    exists now, so the adaptation was a choice rather than a necessity, and
    BM5 exists to price exactly the thing it was avoiding.
    BM5 CALL NUL 0.700 s
    BM5 GOSUB 9000 0.676 s -4%
    **A per-call line-number lookup is now as fast as a target resolved once
    at RUN**, which is the two-slot memo (696514e) doing its job: GOSUB 9000
    and GOTO 500 are the loop's two prg_find targets and both stay resident,
    so neither walks. 9000 is a high line number deliberately -- it is what
    the publ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
2026-08-16 WAVE: one colour per row, 239 on screen, which is the mode's ceiling
    256 was asked for and is not reachable: mode 6 is 240 rows, and a colour
    has to be *on* a row to be seen. So the ramp is 240 entries, the sweep
    covers rows 1-239, and no two rows share a colour -- **239 measured on
    screen at every sample, zero background rows**.
    **The grouping in twos and threes was the ramp being too short.** A
    smooth ramp moves one channel by one at a time, so its distinct colours
    equal the steps it takes through 12-bit RGB, and a hue circle at full
    saturation is six segments of fifteen: 90 steps and no more. Spread over
    247 entries that is 2.7 entries a colour, which is exactly the banding
    reported. The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
2026-08-16 WAVE: row 0 was never painted, and the step is halved to shrink the rest
    Two black gaps, one a bug and one inherent.
    **The mirror was 240-S, so the table spanned rows 1-239 and row 0 was
    never painted** -- a permanent black line along the top, there by
    construction rather than intermittently. It is 239-S now and all of
    0-239 is covered, checked against the generated table rather than the
    screen.
    The other is exposure, not a fault: the head is drawn first and the rows
    behind it are filled one LINE at a time, so a row shows background until
    its turn and the raster can cross the span mid-fill. Three rows a frame
    rather than six takes the worst case from eight spans to five and
    roughly halves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
2026-08-16 WAVE cycles 253 colours in lockstep, and the suite now proves it
    The spec changed: every painted line takes the next of 253 palette
    entries, wrapping -- lines and colours locked, nothing skipped. Entry 0
    stays the black border, 255 the white head, 254 parked at black, 1..253
    the cyclic ramp (loop closes at 2 clicks, duplicates asserted at zero).
    253 is also the right modulus, not just the leftover count: a sweep
    paints 478 lines and gcd(478,253)=1, so the row-to-colour alignment
    precesses through every phase; 254 would share a factor 2 and lock half
    out. On screen at an instant: 127-200 distinct, measured -- a 478-value
    window folded into 253 -- with every entry back within a sweep.
    The fli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
    [mkwave.py]
2026-08-16 D91: PIX_DATA_Y -- the store address picks the step direction
    A second write-only data register on the pixel port, $FF39. Writing it
    plots exactly as PIX_DATA does and then advances Y instead of X, so a
    vertical run is one store per pixel the way a horizontal one has been
    since D34. Any line draws from its lesser-Y endpoint, so +1 is the only
    direction either register needs.
    No mode bit, deliberately: the direction travels with the store, the
    Bresenham inner loop holds no state, nothing is set, saved or restored,
    and an interrupt cannot land between a mode write and the store it
    governed. The rejected PIX_CTRL bit costs the same logic plus a software
    contract about who resets it.
    Measured: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
    [cool8_pixport.v, cool8_soc_tb.v, machine.rs]
2026-08-16 LINE walks on the port's own steps, and the fan gate held every octant
    The Bresenham rework D91 was for. Every line draws downward now -- the
    endpoints swap when the caller's go up -- so the port's +1 is the only y
    step that exists and PIX_DATA_Y carries y for the whole line; the
    rightward x walk is PIX_DATA's own increment; the four-16-bit-word
    endpoint compare is a pixel countdown, since the dominant axis steps
    every iteration and the length is known up front.
    Measured, marginal cycles a pixel with the one-pixel baseline
    subtracted: steep 225 -> 121, shallow 249 -> 170, diagonal 260 -> 181,
    vertical 101. Not the 3x hoped for -- the 16-bit error arithmetic in
    memory is what remains -- but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
    [interp.asm]
2026-08-16 D92: VID_DBASE_H -- the glass and the pencil part company
    The black frame the user saw between ships was real and the docs'
    "never a torn frame" claim was false. The fetch re-latches VID_BASE at
    every frame start and a drawn frame takes seven of them, so the display
    followed the page under construction: CLG on the glass, the finished
    page never shown. One register cannot serve a display that samples per
    frame and a drawing that spans frames.
    The fix is an 8-bit register at the unclaimed $FF30 plus the unused
    VID_CTRL bit 6: while set, the fetch scans from {VID_DBASE_H, $00} and
    VID_BASE steers only the drawing -- the pixel port and CLG both follow
    it. A mode preset clears the bit, so MODE h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
    [cool8_soc_tb.v, cool8_video.v, cool8_vregs.v, machine.rs, mk3d.py]
2026-08-16 COBRA: SPACE shows the hidden-line ship, and the profile chose the fixes
    Answering "is this the fastest": no, and the profiler said why before
    anything was changed. sim/test_run.py --profile is a tool now -- the
    scratch ritual was written twice, AGENTS.md's own threshold -- and it
    measured the wireframe frame at 31.5% CLG, ~15% nested-subscript
    machinery, ~13% actual drawing.
    Mode B, on SPACE, pays both off and removes hidden lines with the same
    instrument. Backface culling runs in the generator: the spin is 72
    fixed frames, so the visible edge set of each is computed offline from
    the published face normals and edge-face table -- the sign pinned by
    the stern, visible at frame 0 -- and the m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
    [mk3d.py]
2026-08-16 The bar was eating the spacebar, and the harness is what proved it
    COBRA's SPACE did nothing in the window while the identical press
    through the VM's keyboard queue switched modes -- reproduced end to end
    from the shipped disc image (DRIVE 13, LOAD, RUN, m.key(" "): 799 lit
    bytes to 529), which localised the theft to the one layer the harness
    cannot drive: the SDL/ImGui front end.
    The mechanism: NAV_ENABLE_KEYBOARD was set, so clicking Play or the
    disc combo left that widget holding ImGui's nav focus,
    want_capture_keyboard stayed true from then on, and the event loop's
    `if ui_keys { continue; }` fed every later key to the bar instead of
    the machine. SPACE is ImGui's activate-focused-widget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
2026-08-16 The map holds at 208 bytes, by decision, and the gate now says so
    check-memmap had been red since the Bresenham rework: the image grew to
    20,166 bytes and the gap to system storage fell to 208, under the
    gate's 256 tripwire. That is the gate doing its job -- the image grows
    downward silently, and an overlap would look like boot corruption, not
    like "the image got bigger" -- and rule 5 makes the remedy the user's
    call, not the code's.
    The call: hold. BASIC is finished; the demos are verification; FREE
    stays 38,400 and the map does not move. The tripwire drops to 128 so
    the accepted 208 is green, while any future growth past ~80 bytes
    forces this conversation again before the gap can close.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
    [memmap.py]
2026-08-16 COBRA is the hidden-line ship alone, culled by what is actually drawn
    The see-through mode is eliminated by decision -- the hidden-line ship
    is simply better, and one mode is one code path. Its profile survives
    in the docs, because it is why this loop looks as it does.
    The popping edges had a real cause: Elite's face normals are
    hand-rounded integers, near their planes but not on them, so the
    normal-based cull flipped a few degrees away from where the drawn
    geometry turns edge-on -- edges vanished while their faces were still
    visibly open. Visibility is now the signed area of each face under the
    exact integer projection the machine draws: the generator walks every
    face's boundary loop out o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
    [mk3d.py]
2026-08-16 SYNTH: the screen is the sequencer, and the melody is the original's
    A port of tomcoolpxl/c64-synth with its trick kept whole: the play loop
    has no note array -- it PEEKs the characters off the text screen, which
    COOL8 does natively because modes 0/1 live in main RAM. The three
    DEFAULT_TRACKS ride verbatim in their PRINT statements (DATA is
    numbers-only here; the first cut tried READ A$ and learned it at
    ?SYNTAX), a char is a note by A=1..Z=26, anything else a rest.
    Pitch is the synth's own SID arithmetic -- 40 * 1.0595^(note+mask) *
    985248/2^24 Hz, masks 82/70/46, the slightly-sharp 1.0595 semitone
    reproduced deliberately -- precomputed by tools/mksynth.py into DATA as
    the machine's ~2*Hz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
2026-08-16 SYNTH: the lead holds longer and sits softer, as the original does
    The lead's release was one volume step a frame -- gone in a sixth of a
    second where the original tails off over the better part of one (its
    release time-constant is ~0.3 s). It steps down every fourth frame now,
    a ~0.7 s tail, and plays at 10 rather than 12 -- a square standing in
    for a triangle wants the volume drop.
2026-08-16 SYNTH: seven voices, live 1-8 toggles, and the whole screen in C64 blue
    The arrangement lands, everything the picklist chose plus the toggles:
    a visible, editable drum row (K kick, S snare, H hat, written to sit
    under the melody), a lead echo two steps late -- a pure delay,
    deliberately not a detune, which was vetoed -- an arp echo one step
    late, and a bass drone an octave down. Keys 1-8 toggle each voice
    while it plays; the row's digit lights white or dims grey, muted
    voices skip triggers and envelopes and are silenced at the flip. Voice
    8 is spare: its toggle lights, nothing sounds.
    The whole screen is C64 colours now: bank 0's sixteen slots repainted
    with the machine's own Commodore 64 p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
    [mksynth.py]
2026-08-16 SYNTH: one percussion line, a fitting pad, and the grid is an editor
    The two percussion lines collapse into one, the right way round: the
    bass row's invisible rest-snare (the original's bass_snare flip) is
    gone, and the drum row IS that percussion made visible -- derived by
    the generator from the bass track's own rests, one S per bar off-beat.
    K and H still decode, so the editor can type a kick or a hat where
    there was none. The bass now simply cuts on rests.
    Row 5 stops being an empty echo label and becomes the PAD: each bar's
    root, derived from the bass line's own bar-start notes (A H J F), held
    soft in the arp's octave. Lead echo and bass drone move to voices 6-7.
    And the editor lands: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
    [mksynth.py]
2026-08-16 SYNTH: a flute of fleeting high notes, and lowercase typing works
    Voice 6 (the row labelled 6, where the echo was) is the flute: two-note
    sparkles placed in the lead's rest gaps, each drawn from that bar's own
    arpeggio tones -- asserted against the lead for clashes -- played an
    octave above the lead (a fourth pitch mask, 94) at low volume with a
    fast fade, which is what makes a square wave sound like a recorder
    rather than a buzzer. Visible and editable like every other row; the
    playhead and the editor extend over it.
    And the field report "i cannot type letters" had a one-line cause: the
    gate had only ever typed a shifted C, while a real keypress arrives as
    lowercase c (99), which the edito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
    [mksynth.py]
2026-08-16 SYNTH: all eight voices are rows, space types the bar mark
    The bass, checked against the source: the instant cut on rests matches
    the original's zeroed oscillator; what was off was balance, now the
    original's own ratios -- lead .35 / bass .3 / arp .2 as 10/9/7. The
    sawtooth itself is out of reach; square is the only tone the chip has,
    and that is recorded rather than approximated away.
    The drone owns row 7 now -- the bar roots it always played, visible
    and typable -- and row 8 is the horn: brassy mid-register stabs of
    each bar root's fifth on the bar mid-beats, the letters derived seven
    semitones up the bass line. Space types the bar mark: on a beat column
    it writes the colon, elsewhere a p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
    [mksynth.py]
2026-08-16 SYNTH: the drone is gone, row 7 is a scratch track
    Awful, by verdict, and deleted rather than defended. Row 7 keeps its
    place in the grid as an empty, beat-marked track wired to a clean mid
    square -- type into it and it plays, staccato between the bar marks;
    leave it and it is silent. Same read machinery, same toggle, same
    editor reach; only the sound and the content changed.
2026-08-16 SYNTH: three anticipations where the drone was
    Row 7 is the PLUCK: the coming bar's root one step before each chord
    change, on the clean mid square, cut to a single step by the next beat
    mark -- J into bar 3, F into bar 4, A leading home. The notes are the
    bass line's own bar-start letters read one bar ahead, asserted clear
    of the lead and the flute at those steps. Suite 19 passed; disc
    rebuilt.
2026-08-16 PLASMA: paint once, animate only the palette
    The pixels never move. Mode 6 is painted once with a fixed
    interference field -- colour(x,y) = A(x)+G(y), two host-computed
    integer sine tables summing to 1..46 -- and the animation is palette
    rotation over a 47-entry cyclic rainbow. Separability is the whole
    trick: it makes the paint loop one statement a pixel through
    PIX_DATA's auto-increment (~25 s of visible top-down fill, its own
    progress bar, MANDEL-class), where a general field would take minutes
    at interpreter speed.
    47 colours and not 240 because rotation is priced in PAL_DATA pokes:
    240 entries is a third of a second a turn, 3 fps; 47 stream in ~90 ms
    through the port's auto-increment,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
    [mkplasma.py]
2026-08-16 D93 + INTRO: text fine-scroll exists now, and the scroller proves it
    The INTRO demo reached for the horizontal scroll and nothing moved:
    section 5.5 had documented text fine-X for a milestone while the pixel
    stage's mux passed text through unscrolled -- the documented-but-absent
    trap, in silicon. The engine mux gives text the low four bits now, in
    logical pixels (a mode 1 cell is 8 of them, so smooth motion is fine
    0..7 plus a two-byte VID_BASE step per cell); the machine's renderer
    and cool8_video_tb's golden model follow, cursor-cell compare included.
    The demo: an 80-column banner shown 40 at a time, every row 40-column
    periodic so the window wraps seamlessly -- an infinite scroll costing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
2026-08-17 test_boot: the banner address follows the map now, not the testbench
    cool8_boot_tb.v carried its own $8104 for the boot banner, written down
    when the text map lived at $8080 and never touched since. D70 moved the
    map (2026-08-13) and the bench started checking user RAM for a banner
    being drawn at $A0A4; two moves later it was $98A4 and the bench was
    still reading $8104. Five of its 22 checks failed for four days --
    bisected to 4dfc63e exactly, parent passes -- and nobody saw, because
    map moves are software work and the rtl group was not in the loop.
    Not environmental: the netlist/cells_sim leg passed throughout.
    The fix is the shape +stopat= already had: the symbols belong to the
    assembler.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
    [boot.asm, cool8_boot_tb.v]
2026-08-17 BAPPLE: the Bad Apple pipeline, gate-proven against a synthetic clip
    Encoder, 68-byte machine-code decoder, BASIC stub and disc plan; the
    user's one remaining step is the mp4 (tools/mkbadapple.py <file>, then
    a disc build).
    Why this port is easy where every other 8-bit one was hard: flash is
    8 MB and FLS_DATA auto-advances, so streaming is native and plain
    delta-RLE at 256x192/15fps needs none of the heroics that define the
    genre -- the C64's 170 KB vector quantisation, the BBC's floppy
    choreography. The fight everywhere else was storage; ours was only
    decode speed, and 8.375 MHz settles it.
    The stream: mode 5 byte planes delta-encoded against the frame two
    back, because pages alternate un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
2026-08-17 mkbadapple: a missing input names itself instead of a traceback
    [mkbadapple.py]
2026-08-17 BAPPLE: the real film plays frame-exact from the twelve drives
    The stream fits because the planner packs drive tails (chunks cut
    against the 64K file cap and the drive's remaining space at once,
    page-aligned as Volume.add places them) and because the encoder's
    credits trim drops the two static text cards after the film. Two
    build-order bugs made a byte-perfect disc play confetti: mkdemos
    flushed the machine's pre-chunk flash over the freshly placed chunks,
    and the stub typed over WAVE left its colour-ramp DATA lines 205-249
    where READ expected the chunk table. Chunks now go in before the
    machine boots, the finished file is read back chunk by chunk, the stub
    gets a NEW, and the gate types a d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
    [mkbadapple.py, mkdemos.py]
2026-08-26 fix(ci): Ensure build directory exists before saving disk image in CI
    [cool8disk.py, mkweb.py]
2026-09-09 feat(action): CoolAction!, a compiled language for games
    The Action! model D52 chose and D68 lost, as a cross-compiler in the
    crate rather than an image on the machine -- so the size arithmetic
    that shelved the self-hosted compiler does not apply, and the web
    emulator can carry it. docs/15-action.md is the reference, D97 the
    argument and what was rejected.
    BYTE, CARD, INT, pointers, arrays, records, PROC/FUNC with recursion
    and a stack frame, and a variable bound to an address for every
    hardware register. C's operators, but comparisons bind looser than
    the bitwise ones -- `status & 1 == 0` is the question a register poll
    actually asks.
    The compiler assembles its own output, and that assemb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
    [action_main.rs, cool8asm.py, lib.rs]
2026-09-09 chore(git): ignore the vendored trees, the story files and the built disc
    Five things were sitting untracked at the top of the tree and none of
    them belongs in it.
    `tools/ucsd-psystem-os` and `tools/ucsd-psystem-vm` are Peter Miller's
    reconstruction of the UCSD p-System, cloned rather than vendored --
    they carry their own `.git`, so committing them nests a repository
    inside this one and takes 5.4 MB of somebody else's history with it.
    `z3/` is the Infocom story files and three more cloned repositories of
    reference ZIL. Those games are commercial software and are not ours to
    redistribute. The interpreter in `sw/z3/` is ours and is committed;
    the stories are not, and `tools/gen_z3.py` names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
2026-09-09 fix(basic): integer booleans, MAXNAME 64, GOSUB renumbering, lazy names
    D94, and the tokeniser and name-table work that came with it.
    **Relational expressions returned float bits.** `true:`/`false:` left
    `STYPE` alone, so a comparison with a float operand -- `A# < 1000.0` --
    answered with `STYPE = 2` and the value in `FACC`, and the `IF` that
    asked the question tested the wrong thing. Both now clear `STYPE`, so a
    relational is always the integer -1 or 0 the rest of the interpreter
    expects.
    **`MAXNAME` 32 to 64.** `NTAB` is allocated at `RUN` between `PROGEND`
    and `CSTK`, so 64 entries cost 832 bytes of a 38.4 KB user area and
    nothing that was not already the user's. A program with several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
    [emu.rs, flash.py, interp.asm, lowram.asm, mkdiagram.py, prog.asm, token.asm]
2026-09-09 feat(z3): a native Z-Machine V3, and the Infocom suite on drives 13-14
    Twelve assembly modules, 7.5 KB at $0200..$1F73, running Infocom's
    1980s interactive fiction on the real machine: HHGG on drive 13,
    ZORK1, PLANETFALL and LEATHER GODDESSES on drive 14. Each is reached
    by an eight-line BASIC stub that sets the drive and the colours and
    calls `SYS "NAME.BIN"`, which is what docs/14-demos.md says a demo
    needing machine code should do.
    The interpreter is the Z-Machine as specified: the object tree and its
    property tables, the abbreviation-expanding text decoder, the
    dictionary as a 16-bit binary search over Infocom's own vocabulary,
    the call stack with its locals and the branch and store enc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
2026-09-09 feat(pascal): UCSD p-System II.0, and the label scope that stopped it
    Eleven modules, 11,395 bytes at $0200, running the authentic 1979 UCSD
    p-System: the P-Machine, its segment loader, the CSP standard-procedure
    set, string and set operations, and an SBIOS driving the real console
    and the real filesystem. The operating system itself is not ported --
    `SYSTEM.PASCAL`, the Filer, the Compiler and the Editor are Peter
    Miller's reconstructed p-code, packaged as a standard UCSD volume on
    drive 15 and executed as they are.
    D96 is the memory map it needs and docs/04-system.md section 2.2 is
    normative for it: two pools either side of the text screen, because a
    single arena on a 64 KB machine cannot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
2026-09-09 feat(demos): put the two ports on the disc, and fix the exclusions list
    `tools/mkdemos.py` packages the Z-Machine and the p-System alongside
    the BASIC demos: the interpreter as a PRG on the volume the stories
    live on, the story chunks as `.DAT`, and the UCSD system volume onto
    drive 15. `tools/cool8disk.py` grows the volume names those need.
    docs/14-demos.md describes all five, which is where a demo is
    documented.
    The exclusions list in docs/12-tasks.md was wrong, in the way it warns
    about. It claimed five suites were on disk and not in the runner, then
    named six in the prose and the table, and said "this is all of them" --
    while `sim/test_cooltris.py` and `sim/test_cooltris2.py` had arrive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
    [cool8disk.py, mkdemos.py]
2026-09-09 fix(action): the library names no address, and the register check reads .act
    Seventeen of sw/libaction.act's thirty register equates were wrong. It
    was written from a plan's prose rather than from the generated map:
    SetColor wrote the cursor position, WaitVBlank polled the border colour
    and never returned, the timer calls wrote into the sound engine. It
    compiled and passed `poe check` for a whole round because tools/ioregs.py
    globbed *.asm and *.bas and nobody had told it a third dialect existed.
    - tools/ioregs.py emits sw/io.act beside io.asm and io.bas -- a BYTE
    per register and a CARD for every _L/_H pair -- and its checker and
    literal-rewriter read *.act too. Run over the old librar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
    [ioregs.py]
2026-09-09 test(action): Line() against LINE, pixel for pixel
    The library's Line follows h_line's structure -- the horizontal case
    apart, always drawn downward, a pixel countdown, the port's own steps
    -- and this is its gate: sim/test_run.py's fifteen-line fan through the
    compiled routine, the whole mode 4 frame compared with the reference
    that gates the interpreter. The nibble packing moves into
    test_run.fan_bytes() so there is one copy of the contract, not two.
    Measured, by routine through dbg.Profile: 128 clocks a pixel over the
    fan, against LINE's 101-181 -- same algorithm, same stack traffic.
2026-09-09 feat(demos): RAINBOW in CoolAction!, exact against the BASIC
    demos/rainbow.act is demos/rainbow.bas statement for statement: two
    endpoints bouncing round mode 4, a ring of fifteen old lines erased
    oldest-first, the colour the ring slot. READ/DATA is an initialised
    CARD ARRAY of $0RGB words, DIM a declaration, 0-Q is -q.
    The gate runs both to the fortieth VSYNC / WaitVBlank and requires
    the same 38,400 bytes of VRAM and the same sixteen palette entries.
    They matched on the first run. Measured: 5,745,642 clocks compiled
    against 6,722,811 interpreted, which is 1.2x and does not matter --
    both sit in the frame wait.
    The first version of the gate compared two blank screens and passed:
    run(until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
2026-09-09 feat(demos): COBRA in CoolAction!, exact on both pages, and the first real speed number
    demos/cobra.act is demos/cobra.bas statement for statement: 72 frames
    of the Cobra Mk III projected at start-up, each frame's visible edges
    unpacked into flat endpoint arrays, the display flipped between mode
    5's two pages after each frame wait, the two-flips-old frame erased in
    black. Its 2,264 table entries are not typed twice: tools/mkcobra.py
    copies them out of the BASIC's DATA into a marked block, and `poe
    check` gains a cobra job that fails if the block is stale. The four
    endpoint arrays and the projection table are BYTE where the BASIC has
    integers -- a mode 5 coordinate is 0-255 by construction --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
2026-09-10 feat(action): seven more ports, exact against their originals, and INTRO's shudder found
    TRIANGLES, MAZE, PLASMA, WAVE, MANDEL, SYNTH and INTRO in CoolAction!,
    each a demos/name.act beside its name.bas and each held to it by
    sim/test_action.py: both run to the same frame wait, RND call or key
    wait, and what the machine holds -- VRAM, palette, text map, the
    programmed voices, the registers -- must be identical. All seven match.
    The library grew what the ports needed: Rnd(), the interpreter's own
    xorshift from its seed so a picture made of random numbers can match;
    ReadKey(), sw/kbd.asm's decoder on the same three tables, which
    tools/cool8kbd.py --emit copies into a marked block and `poe chec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
2026-09-10 feat(action): the loader -- a program owns the machine, and never comes back
    sw/loader.act (D102): SYS "NAME.BIN" puts a 3.5 KB stub in BASIC's
    user area; the stub turns interrupts and their sources off, points
    the vectors at its RETI, streams NAME.PRG from the flash by the
    library's own catalogue lookup to the address in its header, and
    jumps in with Reset() as the return -- so a program compiled at $1400
    may run to $FEFF over the whole of BASIC, and one that finishes
    restarts the machine as Ctrl+Shift+Esc does. The library gains
    FlashOpen/FlashByte/FlashRead/FlashClose, DiskFind/DiskOpen and
    Reset(); tools/mkdemos.py builds every CoolAction demo as the pair;
    test_loader watches RAINBOW lan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
    [mkdemos.py]
2026-09-10 feat(demos): SLIDES -- the old test pictures, as fully as mode 6 can show them
    The USC-SIPI Mandrill and Peppers and Kodak's parrots and painted face,
    a picture at a time on the space bar, in mode 6: 256 x 240, all 256
    palette entries at once, each any of 4,096 colours (D103).
    - tools/mkpics.py: a picture file is the hardware's own bytes -- an
    eight-byte header, the palette as PAL_DATA takes it, the pixels as
    VRAM holds them. libimagequant posterised to four bits, run again
    with the distinct colours fixed until all 256 differ; --fetch gets
    the originals and holds each to its SHA-256; they stay out of git.
    - demos/slides.act: lists drive 10 with the library's new DiskDir and
    DiskEn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
    [cool8disk.py, mkdemos.py, mkpics.py]
2026-09-10 fix(machine): FLS_DATA stalls as the RTL's does -- 34 clocks a byte
    The machine handed every flash byte over at once, so SLIDES' picture
    stream measured 14 clocks a byte where the board takes 34. The RTL's
    shifter spends four clocks a bit, not the two its own comments and
    04-system.md section 4.8 claimed: 32 clocks on the wire and two to
    hand the byte over and arm the next, and the first byte 161 clocks
    after the stream opens.
    - sim/tb/cool8_flash_tb.v measures both on the RTL and fails on any
    other figure.
    - rust/src/machine.rs: the flash keeps when its prefetched byte is
    there; a read before then is held off, and MachineBus::wait carries
    the clocks into the instruction, as mem_ready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
    [cool8_flash.v, cool8_flash_tb.v, machine.rs]
2026-09-10 feat(demos): SLIDES shows more than 256 colours -- the palette changes between rows
    D104. Each of the four pictures is drawn with a palette of its own per
    row: up to two entries rewritten in the blanking before a row (ones the
    row above used) and up to fourteen while the row above is drawn (ones
    it does not use), so no entry ever changes under a pixel showing it.
    The machine's frame shows 822, 523, 628 and 446 colours where one
    palette showed 256, 254, 254 and 252, 22 to 48 % closer to the
    originals once both are blurred as the eye blurs dithering.
    - The budget is read out of the Verilog: VID_RASTER changes at pixel
    648-650 of the line before and the palette is read a pixel ahead of
    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
2026-09-11 feat(demos): COBRA, compiled, tumbles on three axes -- every frame computed at 60 Hz
    D105. demos/cobra.act is no longer the BASIC's twin: the Cobra Mk III
    tumbles on three axes and each frame -- the rotation, 28 vertices into
    perspective, 13 faces culled, the visible edges erased and drawn -- is
    computed between two vertical blanks, in 55,958 of the frame's 139,583
    clocks. The PRG is 8,430 bytes against the port's 15,009.
    - A mode no preset names: mode 6's timing at 4 bpp, stride 128 --
    256 x 240, 30,720 bytes a page, so two pages double-buffer.
    - Assembly where the profile put the clocks: Transform (unsigned MUL
    with 128 carried in, the surplus off as two constants), Faces (the
    same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
    [mk3d.py, mkactdata.py, mkdemos.py]
2026-09-11 feat(demos): COBRA 2 -- a camera circles a ship that flies straight, under a sky fixed in the world
    D106. demos/cobra2.act is a copy of the compiled COBRA, which is left
    alone, read the other way round: the ship does not turn in the world,
    so the rotation COBRA builds is the camera's, at half COBRA's rates,
    and everything fixed in the world goes through it.
    - 28 stars, directions, swing across the screen exactly as far as the
    camera turns; 20 specks of dust, points near the ship, slide one unit
    a frame back along its length -- the flight -- and part company in
    front of it and behind as the camera circles. Sky() puts them through
    Transform's three rows and a table-and-MUL perspective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
    [mk3d.py]
2026-09-11 feat(demos): COBRA 2's ship flies through dust that stays put
    D106, flipped at the owner's word. The ship has a place in the world
    (sh) and flies four of the dust's units of two a frame along its nose,
    the camera following it; a speck is a place in the world, and what goes
    through the rotation and the perspective is its place less the ship's,
    built each frame into a vertex's record (.rel). The same picture as
    dust sliding past a ship that stood still, but the shape a second ship
    will need, each with a place of its own.
    - Eight model units a frame, four times the first cut's: the dust at
    1.4 px a frame moved less than the camera's orbit moved it, and did
    not read as flight.
    - A speck com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
    [mk3d.py]
2026-09-11 feat(demos): COBRA 2's camera two-thirds slower, and half the dust
    At the owner's word: the camera circles at a sixth of COBRA's rates, a
    third of the first cut's half -- yaw is then one step of sine a frame --
    and ten specks of dust where there were twenty. The generator's checks
    hold at the new rates: no edge flickers in the tumble's first 4,096
    frames, the faces against their triangles on the screen only below an
    area of 90.
    - DustAt() gets three tries at a place in reach and ahead of the ship
    before it mirrors one through the ship's centre: with the camera
    slower, one try put only 104 of 131 recycled points back on the
    screen the next frame; three put 96 of 101.
    - D106 and 14-demo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
2026-09-11 fix(demos): COBRA writes DBASE before VSYNC -- the glass showed the old page mid-erase
    The fetch takes VID_DBASE_H at the frame start, on the pulse that ticks
    the counter VSYNC waits on, so demos/cobra.bas's DBASE written after
    VSYNC reached the glass a frame late, and BASE moved to the old page in
    the same line put its erase in view. Measured on the rendered frame: at
    9 flips of 9 the first frame after the flip was the old page mid-erase.
    tools/mk3d.py now writes `POKE $FF30,P:VSYNC` then `POKE $FF13`; none
    fail, still 4.5 display frames a drawn frame.
    cobra_flips compares the glass, not the registers, which read a page
    apart either way: each flip is found exactly (the VSYNC park, then
    `st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
    [mk3d.py]
2026-09-11 feat(demos): Arkanoid -- the arcade's 33 rounds, DOH and the intro, from its own sheets
    demos/arkanoid.act is the arcade Arkanoid in mode 2: the 32 rounds and
    DOH's 33rd, the seven capsules, the laser, three balls, catch and the
    exit, the enemies through the gates, DOH's shots, sixteen hits, his
    death and his dissolve, the title's logo, the intro's story and the
    ship's escape, and five tunes from the arcade's own sound logs. The
    effects are made on the voices.
    tools/mkarkanoid.py rips all of it from the sheets in assets/arkanoid/
    -- no pixel drawn by hand -- into arkanoid_art.act and two data files,
    ARKANOID.DAT and ARKSCENE.DAT: 92 KB of tiles and patterns the game
    streams from its own dri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
2026-09-11 fix(demos): Arkanoid -- a ball through a late Vaus or a shrinking one, and enemies wrapping to the bottom
    Three collisions the owner saw in play, each found by an experiment
    sim/arkanoid.py now has (touch, late, vaus, up) and each held by the
    gate.
    A ball bounced off the Vaus only when it crossed the Vaus's top in a
    frame, so a Vaus that came under it a frame late -- the ball's bottom
    one to eight pixels past the top -- let it through. It now bounces
    anywhere in the Vaus's body on the way down.
    The body the ball, the capsules, the enemies and DOH's shots meet was
    the form's, and a morph plays while the form already says where it
    goes: for the 18 frames of shrinking from enlarged, up to 8 p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
    [mkarkanoid.py]
2026-09-12 feat(demos): COOLTRIS -- seven shapes into a well, in twenty levels of colour
    A falling-block game in the manner of the 1989 NES one, written from
    its published numbers and none of its pixels: 48 frames a row at the
    first level down to 2 at the twentieth, ten rows a level, 40/100/300/
    1200 times the level for one to four rows at once, a point a cell for a
    soft drop, a key that repeats after 16 frames then every 6
    (tetris.wiki). Two kindnesses on top, both asked for: the shapes come
    from a bag of seven shuffled, and a hollow ghost shows where the piece
    will land. Otherwise the board's: no hold, no wall kicks, no hard drop.
    tools/mkcooltris.py draws every tile -- one bevelled block, a hollow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
2026-09-12 fix(demos): Arkanoid -- the Vaus goes out through the exit, not standing dead in it
    Taking the gap a B opens ended the round the moment the Vaus reached it,
    at vx 200: the ten thousand landed, then the Vaus stood still for some
    seventy frames -- the screen unchanged -- and vanished where it stood
    before the next round came up. It now goes on right after the score,
    two pixels a frame, sliding into the gap and out of the field (206, 222,
    232 in the frames sim/arkanoid.py exit shoots), and only then does the
    round turn. The gate holds it: the Vaus must reach 230 before round 2.
    sim/arkanoid.py gains an exit mode, which catches a B, drives the Vaus
    into the gap and shoots every eighth frame acr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
2026-09-12 feat(demos): COOLTRIS -- ten tunes, one for each level, and the score where it can be read
    The tune was liked, so there are ten. tools/mkcooltris.py composes each
    from a key, a scale, four chords by their degree in it and an eight-step
    motif of degrees away from the chord's own: a lead over a walking bass
    with a third between the beats, four bars round and round on voices 0-2.
    They run through minor, dorian, major, phrygian and harmonic minor, and
    the step shortens from 13 frames to 9, so the tenth is brisker than the
    first; 2,574 bytes for all ten. A level plays tune (level mod ten), so
    every level change brings a new one and the twentieth screen sounds like
    the tenth. The front plays all t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
    [mkcooltris.py]
2026-09-12 feat(demos): COOLTRIS -- the first tune back as it was, and nine more written by hand
    The composed nine were not worth the one written by hand, so they are
    gone. The tune this port started with -- A minor, a melody over a
    walking bass with a third between the beats -- is tune one again, note
    for note out of the repository's own history, and nine fellows are
    written out beside it in the same shape: thirty-two eighths, a bass on
    the even steps two notes to a chord, a third or a fifth between them on
    the odd ones. D minor longing, E phrygian dark, C major bright, A dorian
    hopeful, D minor driving, E minor marching, F lydian floating, A
    harmonic minor dramatic, D dorian restless; the step shorte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
    [mkcooltris.py]
2026-09-12 fix(demos): COOLTRIS -- the board's own turns, cell for cell, and rain on the front
    Turning a piece twice walked it down the well. The I, the S and the Z
    have two forms, not four, and my table gave them four, the third and
    fourth a row below the first and second; the owner saw it on the I and
    again on another. Two goes at the table by hand had already got the J's
    fourth turn wrong, so this takes the published grids whole instead: the
    Nintendo rotation system's, read cell by cell off the diagram on
    tetris.wiki. The I, the S and the Z have two forms, the O one, the T,
    the J and the L four, and they come in with the nub below the bar as the
    board's do. The gate carries those grids as reference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
2026-09-13 feat(demos): COOL SWEEPER -- three fields in three themes, and music written note by note
    A minesweeper for the CoolAction menu, COOLSW on drive 11. The first
    cell dug and the eight round it are never mines: the mines are placed
    on the first dig, so it always opens ground to reason from.
    A cell is 16 x 16, four tiles, so a number can be a bold digit with a
    bevel and a shadow; that sizes the levels to mode 2's screen rather
    than to the 1990 game -- 9 x 9 with 10 mines, 14 x 11 with 25, 18 x 12
    with 45. The field is a checkerboard of two shades, a number's colour
    is its bank, and each level's theme -- meadow, sea, lava -- is the
    whole palette, so the front repaints itself as the cursor moves.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
2026-09-13 feat(demos): YENDOR, milestone 3 -- NetHack's things, and the room for the rest
    The things: 48 kinds from objects.c -- weapons, armour over six slots,
    potions, scrolls, wands, rings, the amulet of life saving and the Amulet
    with its imitation -- under appearances shuffled each game, blessed,
    uncursed or cursed, with what each does; the pack, wielding, wearing,
    gold, throwing and firing daggers, the discoveries.
    The room, as the owner chose it (D109): the compiler drops routines
    nothing reaches (every disc program 1.7-3.0 KB smaller, the loader stub
    3,543 -> 1,049 bytes); $0800-$13FF is the loaded program's own RAM, where
    YENDOR binds its three cell maps; the names are records in YNAMES.DAT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
    [mkdemos.py]
2026-09-13 feat(demos): MOTT, milestone 5 -- the mines and their town, Delphi, Sokoban
    Seventeen levels: the dungeon's twelve, three of the Gnomish Mines from a
    second stairs down on level 2 or 3, two of Sokoban from a second stairs
    up above the Oracle's level. The mines are caves by NetHack's mkmap()
    passes, their loops in assembly; the second is a town with a temple and
    its priest (#chat, donations, protection), a general store, watchmen and
    gnomes at peace. Delphi has the Oracle among four fountains and centaurs
    (#chat: minor and major consultations, in the game's own words). Sokoban
    is two small puzzles, proven solvable by tools/mkmott.py and solved push
    by push through the keyboard by the gate. Th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
    [mkmott.py]
2026-09-13 feat(demos): MOTT, milestone 6 -- the Amulet and the climb back, music and sounds, Platino
    Level 12 holds the Amulet of Mott with the Wizard of Mott asleep beside
    it: his blow steals it, intervene() comes every 50 to 250 turns once it
    is lifted, the mysterious force turns the stairs up, and up the stairs of
    level 1 with it the game is won. Platino appears to one who writes his
    name in the dust.
    Ten tunes in MMUSIC.DAT, a part of the dungeon's played twice on coming
    into it and then quiet; in the quiet, the part's own noises now and then;
    a monster's blow sounding as its kind; NetHack's noises() and dosounds().
    Levels: no corridor ends in nothing, four to six loops besides the
    spanning walk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
    [mkmott.py]
2026-09-13 feat(demos): MOTT saves -- S writes MOTT.SAV and ends the game, the title's C continues it
    NetHack's rules, as the owner chose: S asks, parks the level, erases the
    file's eight sectors and writes the build's stamp, the run of globals from
    save_from to save_end and every level made from its VRAM slot, showing
    which level it is on, then its state byte last. The title offers a save
    this build wrote; C reads it back, clears the state -- a save is used once
    played on -- and enters the level where the hero stood. Bytes are kept
    inverted so a level's zeros are never programmed.
    MOTT.SAV is 32 KB on drive 9, reserved on a 4 KB sector by a `reserve`
    line in demos/mott.disc and cool8disk's Volume.res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
    [cool8disk.py, mkdemos.py, mkmott.py]
2026-09-13 feat(demos): GALAGA, milestone 1 -- the arcade's art, and the formation breathing in a bitmap
    The ripped arcade sheets (The Spriters Resource's General Sprites and
    Screens and Text, via their GitHub copies) cut by tools/mkgalaga.py into
    152 sprite patterns in GALAGA.DAT, the formation's frames as lists of
    changing pixels, the font and the colour PROM. demos/galaga.act runs in
    mode 4: the forty characters drawn into the bitmap, swaying and
    breathing by the disassembly's own tables, stars, and the fighter in
    sprites. D113 is the argument; the gate holds the bitmap to the
    program's state pixel for pixel and every frame inside its frame
    (busiest 72,286 clocks of 139,583). PRG 16,105 bytes.
    Co-A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
2026-09-13 feat(demos): GALAGA, milestone 2 -- four horizons under a raster split
    The owner-approved backdrops from OpenGameArt (a blue planet's limb, a
    green nebula, a Mars ridge, a gold giant; credited in
    assets/galaga/README.md) cut by tools/mkgalaga.py into bands of 224 x 72
    in GALAGA.DAT. The palette is ordered so its first eight are the only
    colours the bitmap uses low on the field; a raster interrupt gives the
    band its own last eight on the row above it and the vertical blank puts
    the arcade's back. The gate holds the split to its lines through the
    machine's palette log and the band's pixels to their RAM copy. PRG
    16,895 bytes, busiest frame 74,157 clocks.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
2026-09-13 feat(demos): GALAGA, milestone 3 -- the fighter's shots, explosions and the score
    Two shots at a time, each testing the pixels its head passed through
    against the characters at rest; a hit is scored (bee 50, butterfly 80,
    boss 150, a boss taking two), and explodes in the arcade's own five
    double-size frames drawn into the bitmap, each frame put back -- black,
    or the backdrop from its RAM copy -- before the next, and the characters
    under it drawn again. A character near a live explosion moves by erasing
    and redrawing, since its lists assume a picture the explosion may have
    drawn over.
    Found on the way and written into docs/04-system.md: PIX_X is one
    eleven-bit counter whose advance carries i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
2026-09-13 feat(demos): GALAGA, milestone 4 -- stage 1 flies in on the arcade's own paths
    tools/galaga_paths.py is the disassembly's flight tables, starts, stage
    waves and home slots, extracted by script, and a bit-exact model of the
    sub CPU's interpreter, the launcher, the sway and the object states.
    tools/mkgalaga.py relocates the path bytes into one blob with the wave
    scripts; demos/galaga.act ports the interpreter to CoolAction!: six
    flyers in sprites, the arcade's own tiles and flips from the angle, an
    arrived enemy turning upright and settling into its bitmap slot, shots
    hitting what flies. D114.
    The gate holds all forty of stage 1 to the reference, frame for frame,
    each launched on the game's o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
    [galaga_paths.py, mkgalaga.py]
2026-09-13 feat(demos): GALAGA -- the title, STAGE n, the panel's badges, and stage after stage
    A title with the arcade's score table and the credits the backdrops'
    licences ask for; each stage announced in the field, its badges added up
    the arcade's way (50s, 30s, 20s, 10s, 5s, 1s) in the right-hand panel
    beside the fighters in hand; a stage cleared -- the launcher done and
    nothing left in the formation, the air or exploding -- goes on to the
    next, and every fourth the level's backdrop. The vblank handler's tables
    start as the arcade's colours, so the title, which has no backdrop,
    keeps its green.
2026-09-13 feat(demos): GALAGA -- the arcade's sounds, from its sound CPU's own streams
    tools/galaga_sound.py is the sound ROM's note streams (checked by CRC)
    and a tick-exact model of its driver; tools/mkgalaga.py renders each
    sound to 60 Hz and packs its changes -- a mask of the voices whose
    increments and volumes follow, then the frames to the next. The game
    mixes them the driver's way, sounds in its fixed order and a later one's
    voice winning, the tunes on voices 0-2 and the effects on 3-5: the start
    theme under PLAYER 1, the shot, the hits, the boss's first hit, the
    formation's pulse while it breathes, the challenging stage's call. The
    gate holds the start theme to the rendering frame for frame.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
    [galaga_sound.py, mkgalaga.py]
2026-09-13 feat(demos): GALAGA -- a tune for each level
    Four tunes written out note by note in tools/mkgalaga.py, in COOL
    SWEEPER's notation and read by its parser: the blue planet in E minor,
    heroic and driving; the nebula in D dorian, floating; the red ridge in A
    minor, a march; the gold giant in C major, fast. Lead, bass and an
    arpeggio on voices 0-2 with their own envelopes and the lead's vibrato,
    the drums on voice 7; an arcade tune takes the voices while it plays.
    The gate hears the level's notes and its drums in stage 1's play.
    PRG 48,017 bytes.
    [mkgalaga.py]
2026-09-13 feat(demos): GALAGA -- the fighter's death, READY and GAME OVER
    Something flying into the fighter is destroyed with it; the fighter goes
    up in the arcade's four double-size frames with a burst of noise, and two
    and a half seconds on READY brings a fighter from the panel, or GAME
    OVER ends the game. The gate crashes one and holds the explosion over the
    backdrop -- put back from its VRAM copy -- to the pixel. The boxes are
    provisional until the arcade's own tolerances are read.
2026-09-13 feat(demos): GALAGA -- challenging stages tallied, the score pop-ups
    A challenging stage counts its hits; a whole wave of eight shot pays the
    arcade's group bonus, 1000 then 1500, shown where the last fell in the
    sheet's own pop-up; and when the stage is done NUMBER OF HITS, then a
    hundred each under the results tune, or PERFECT ! and the special bonus
    of ten thousand under its own. sim/galaga.py gains an autopilot, and the
    gate plays stage 3 with it and holds the payment to the tally.
2026-09-13 feat(demos): GALAGA -- the challenging stages' own creatures
    Stages 11 and 15 fly the dragonfly and the scorpion. The captured
    fighter's patterns (with the butterfly's, 50 in all) sit last in the
    sprite blob; each creature's SW_ block is streamed over them for its
    stage and the SPR block puts them back after the results. The gate
    plays stage 11 and checks both streams.
2026-09-13 feat(demos): GALAGA -- the attack: dives, escorts, bombs, the arcade's restart
    tools/galaga_dives.py (the reference, from the disassembly) extends the
    path machine with f_0857, f_1B65's sortie timers, boss escorts and the
    capture hold, per-flyer bomb chances with l_0D8D's aim, continuous
    bombing, c_23E0's count and culling, the hit windows and the restart's
    counts; the game ports them. Bombs are sprites: 31, 30, or a free or
    settling flyer slot's, a settling character handed to the bitmap with
    its turn's visits counted down. The rockets fly in arcade coordinates.
    The gate holds stage 1 (to continuous bombing) and stage 16 (the sprite
    budget spent) to the reference frame for frame, 3,000 fra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
2026-09-13 feat(demos): GALAGA -- waves and tunes from the data file, the dive sound, extra fighters
    A stage's waves and a level's tune are loaded from GALAGA.DAT when
    wanted (Load, into RAM) instead of all being held: PRG 55,354 to
    52,797 bytes with the rest of this in. The arcade's dive sound plays
    where it sets it (a sortie finding its diver, a pool launch, F9 while
    continuous bombing); a fighter is added at 20,000, 70,000 and every
    70,000, with its sound. sim/galaga.py sizes lists where the bytes are.
2026-09-13 feat(demos): GALAGA -- the results after GAME OVER, pause, its docs and the disc
    After GAME OVER the arcade's results as its screens' sheet lays them
    out: shots fired, hits, the hit-miss ratio. P pauses. docs/14-demos.md
    gets GALAGA's section and its place on drive 11; D115 says why the
    bonus bee waits (VRAM). The gate adds the pause, the results, and the
    path a person takes: the ROM booting the demos disc, SYS "GALAGA.BIN",
    GALAGA.DAT found, space and stage 1. PRG 53,412 bytes.
2026-09-13 feat(demos): GALAGA -- the capture: the tractor beam, the fighter taken, FIGHTER CAPTURED
    f_21CB, f_2222, f_20F2 with c_2188, and f_19B2 ported from the ROM: the
    beam grows a row every p6 frames, holds 64 frames and takes a fighter
    within its window up, spinning and turning red; FIGHTER CAPTURED; the
    boss goes home by db_flv_cboss with the red fighter, which rests above
    it, joins its sorties or dives alone, and is worth 500 / 1,000. The
    beam is the sheet's, pressed to the screen's rows and drawn into the
    bitmap, its blues turned in place and put back from the band's copy.
    The gate sees a capture through and the bitmap exact after it; the
    harness spares Caught as it spares FighterHit. D116. P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
2026-10-04 feat(demos): GALAGA -- the rescue and the dual fighter
    f_2000 ported: a boss shot while it dives with the fighter it captured
    hands it back. The fighter spins free (c_2188) while anything else is in
    the air, walks to the middle and down to its row while the player's
    slides left, and the two join. f_1B65 and continuous bombing stand down
    for it, as the ROM's task 1D does, so the sky empties.
    The second ship takes a flyer slot's four sprites the way a bomb takes
    them, so a pair means five flyers. The two fire a rocket each; a hit
    takes that ship only and costs no fighter, and no capture is tried while
    two are flying. The gate captures, rescues, fires the pair and loses one
    of them. D117. PRG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
2026-10-04 feat(demos): GALAGA -- the backdrop band halved, and the bonus bee transforms
    The band drops from 64 rows to 32 (the crops raised sixteen rows so each
    horizon still falls in it), which frees 3,584 bytes of VRAM -- room for
    one of the bonus bee's three creatures at a time. The sheet's galaxian
    flagship, scorpion and bosconian are generated into GALAGA.DAT and
    streamed in with the level's backdrop.
    f_1A80 ported: with few enemies left one at rest is armed and kept out
    of other sorties, then goes as the level's creature down the path its
    colour names, splitting at the F2 tokens (Clone) into transients with
    slots of their own. They are worth 160 each and the last the trio's
    1,000, 2,000 or 3,00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
2026-10-04 fix(demos): GALAGA -- the backdrops out, the field the arcade's black
    The four horizons were this port's own idea and a distraction, by the
    owner's verdict. Out go the band, the raster palette split, the band's
    copy in VRAM, BandPixel for the stars and the restores, the pictures and
    their credits; what the bitmap draws is put back as black. The levels
    keep their tunes and their bonus-bee creatures.
    VRAM: 3,584 bytes back, the patterns ending at $F100 with 3,840 free.
    Program: 919 bytes, and no interrupt at all now. The gate loses its
    raster-split check and keeps the rest. D120. PRG 58,564 bytes.
    [mkgalaga.py]
2026-10-04 feat(demos): GALAGA -- the entry's tune, the badges' clicks, the bonus bee blinking
    Three small arcade touches: the name-entry screen plays the tune the
    sound ROM has for it (0x10, rendered all along and unused); each stage
    badge goes up on its own with the arcade's click (0x15, likewise); and
    the armed bonus bee blinks for its sixty-four frames, which is the
    player's warning that this one is about to go -- the bitmap's character
    erased and drawn again, and FmStep leaving it where it is while it is
    not drawn. The gate watches for all three. PRG 58,868 bytes.
2026-10-04 fix(demos): GALAGA -- rockets hit by the arcade's box, and the attract shows a capture
    Three things from playing it:
    A rocket now hits a character still in the formation by hitd_det_rckt's
    box -- five pixels either way, Y's halves three below to two above -- as
    it already did one in the air, instead of by the character's drawn
    pixels. A shot through a boss's wing used to pass through it.
    A round of the attract leaves nothing of the round before: every sprite,
    explosion, rocket and bomb is cleared when one starts.
    The attract's fighter steps aside from a bomb, stands clear of a diving
    capture boss and then under its beam, so the round shows the capture,
    the fighter taken, and the pair afte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
    [mkgalaga.py]
