tomcoolpxl/cool8-cpu/(notices)

Notices in the files:
docs/01-decisions.md:
for RGB444 screens. It is GPL-3 and runs on the host only: an optional
DawnLike's detail; NetHack's own tiles, copyleft and in more than a
